obotx/diy-robot-kit/README.md

# ObotX

ObotX is an open-source mobile manipulator with a mecanum base, two vertical
Z axes, a horizontal X axis and a four-finger electric gripper.

This repository contains the bill of materials, electrical diagram, firmware
and Raspberry Pi control software required to reproduce and commission the
robot.

<p align="center">
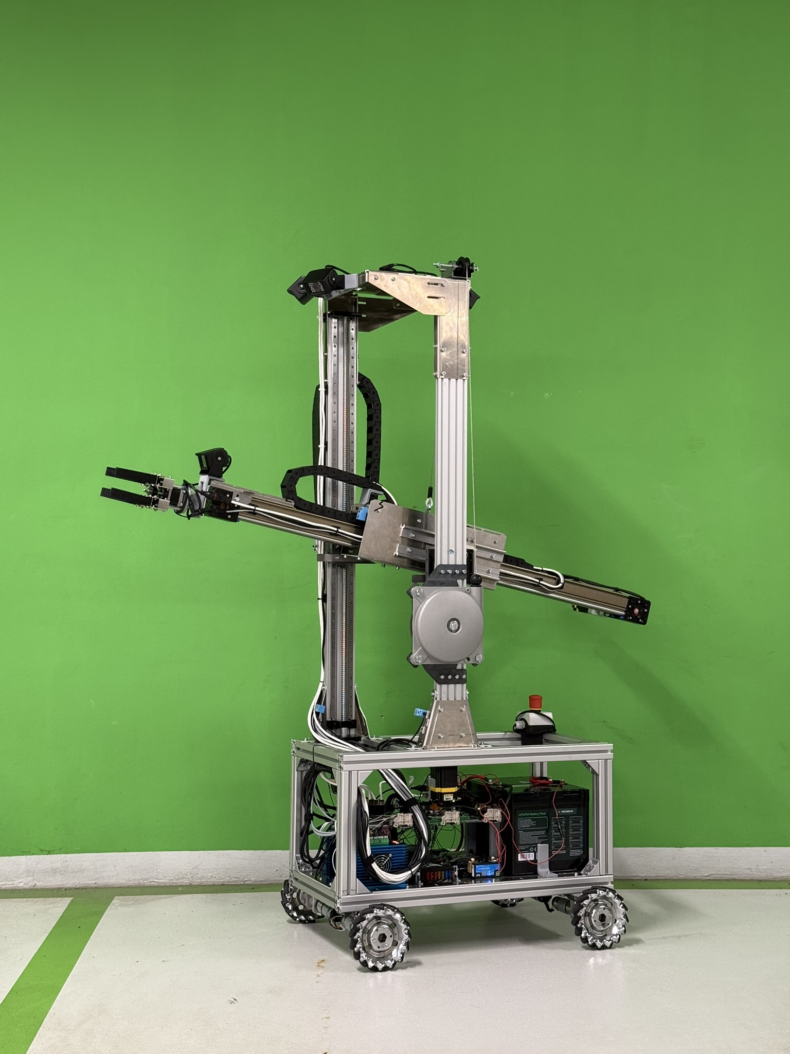
[picture p1: media/obotx-robot.jpg]
ObotX mobile manipulator
  
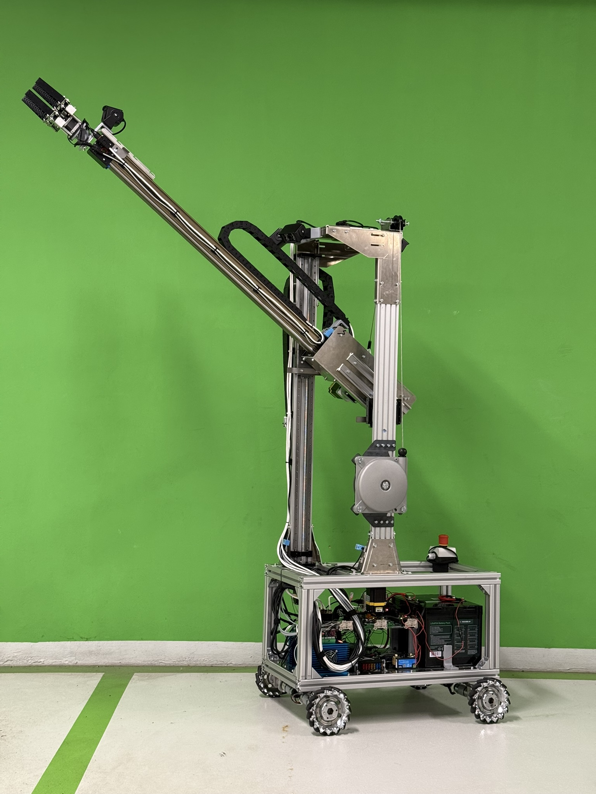
[picture p2: media/obotx-robot-extended.jpg]
ObotX manipulator extended
  
</p>

### Demonstration video

The following video shows the assembled ObotX robot in operation.

https://github.com/user-attachments/assets/15b41a1a-71f6-4121-ad5b-7e64adb0d48f

## Teleoperation system

The complete ObotX teleoperation system consists of two parts:

| Component | Role |
| --- | --- |
| **Device** | The physical ObotX robot, including the mecanum base, manipulator, gripper, cameras, Raspberry Pi and STM32 controllers. |
| **Teleoperation interface** | The browser-based operator panel served by the Raspberry Pi. It sends commands to the Device and displays robot status and camera video. |

```text
Operator -> Browser interface -> Wi-Fi / Ethernet -> ObotX Device
```

The Raspberry Pi web server and teleoperation interface are included in this
repository under [`software/rpi`](software/rpi/).

### Teleoperation interface

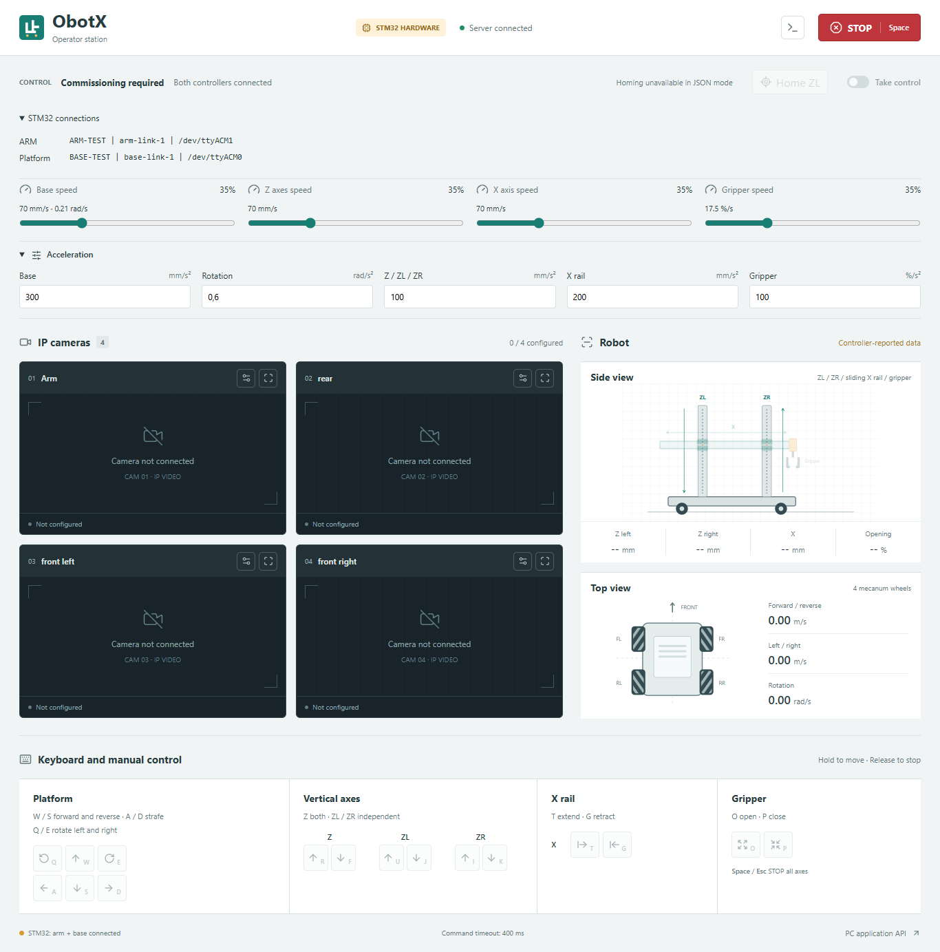
[picture p3: media/obotx-teleoperation-interface.png]
ObotX browser-based teleoperation interface


## Build and commissioning order

1. Purchase the parts from the [main BOM](hardware/bom/bom.csv) and
   [mechanical BOM](hardware/bom/mechanical-bom.csv).
2. Build the robot using the [mechanical assembly drawings](docs/assembly/README.md).
3. Wire the robot according to the
   [electrical diagram](hardware/wiring/ObotX_electrical_diagram.pdf).
4. Configure and commission the
   [battery system](docs/power/victron-battery-commissioning.md).
5. Configure the [closed-loop stepper drivers](software/stm32_arm/docs/zdm-2ha865-parameters.md).
6. Flash the [ARM](software/stm32_arm/README.md) and
   [BASE](software/stm32_base/README.md) controllers.
7. Install the [Raspberry Pi software](software/rpi/INSTALL.md) and configure
   the [network connection](software/rpi/docs/network-connection.md).
8. Complete the [commissioning checklist](docs/testing/commissioning-checklist.md)
   before placing the robot on the floor or attaching a payload.

## Documentation

Use the [documentation index](docs/README.md) to find the instructions for each
subsystem.

## Safety

Keep the physical emergency stop accessible. Support axes that can fall when
motor power is removed. Begin motor tests unloaded and with the drive wheels
raised. Never use the browser, Wi-Fi, Ethernet, camera video, BatteryProtect or
software STOP as the only emergency-stop function.

Do not commit passwords, Bluetooth encryption keys, private configuration,
invoices, contracts or personal/customer data.
