obotx/diy-robot-kit/hardware/drawings/README.md

# Mechanical drawings

Assembly drawings in [`assemblies/`](assemblies/) contain bills of materials,
exploded views and mounting instructions. Part drawings in [`parts/`](parts/)
define manufacturing dimensions, material, thickness and bending data.

## Assembly order

| Drawing | Assembly |
| --- | --- |
| [OBX-A001](assemblies/OBX-A001_REV.pdf) | Base frame |
| [OBX-A005](assemblies/OBX-A005_REV.pdf) | One wheel and motor assembly; build four |
| [OBX-A006](assemblies/OBX-A006_REV.pdf) | Electrical mounting plate assembly |
| [OBX-A012](assemblies/OBX-A012_REV.pdf) | Complete mobile base |
| [OBX-A011](assemblies/OBX-A011_REV.pdf) | Cable carrier assembly |
| [OBX-A009](assemblies/OBX-A009_REV.pdf) | Vertical lifting module |
| [OBX-A003](assemblies/OBX-A003_REV.pdf) | Fixed node module |
| [OBX-A004](assemblies/OBX-A004_REV.pdf) | Moving node |
| [OBX-A010](assemblies/OBX-A010_REV.pdf) | Horizontal actuator module |
| [OBX-A007](assemblies/OBX-A007_REV.pdf) | Balancer module |
| [OBX-A008](assemblies/OBX-A008_REV.pdf) | Cable pulley block |
| [OBX-A000](assemblies/OBX-A000_REV.pdf) | Final robot integration |

Read every sheet of a drawing before assembly. The item numbers in an exploded
view refer to the bill of materials on the first sheet of that drawing.

Use the part PDFs when ordering laser-cut, bent or machined parts. Send the
matching STEP file together with the PDF, but treat the PDF dimensions,
material and tolerances as authoritative.
