obotx/diy-robot-kit/hardware/bom/bom.csv

Category | Subsystem | Item | Qty | Estimated Cost PLN | Supplier/Link | Notes
Control | Raspberry Pi Gateway | Raspberry Pi 4B 4GB | 1 | 470 | https://www.morele.net/raspberry-pi-4-model-b-cpu-1-5ghz-ram-4gb-5939927/ | Robot-side gateway
Control | Raspberry Pi Gateway | SanDisk Ultra microSD 64GB 140MB/s UHS-I Class 10 A1 with adapter | 1 | 90 | https://botland.com.pl/karty-pamieci-microsd-sd/9960-karta-pamieci-sandisk-ultra-microsd-64gb-140mbs-uhs-i-klasa-10-a1-z-adapterem-619659200541.html | Raspberry Pi system storage
Control | Base Controller | STM32 Nucleo-F446RE | 1 | 89 | https://botland.com.pl/stm32-nucleo/4905-stm32-nucleo-f446re-stm32f446re-arm-cortex-m4-5904422333164.html | Base controller
Control | Arm Controller | STM32 Nucleo-F446RE | 1 | 89 | https://botland.com.pl/stm32-nucleo/4905-stm32-nucleo-f446re-stm32f446re-arm-cortex-m4-5904422333164.html | Arm controller
Control | USB | Angled USB-A to Mini-USB cable, 1 m, black | 2 | 34 | https://allegro.pl/oferta/kabel-usb-mini-usb-do-nawigacji-kamery-aparatu-wideorejestratora-1m-katowy-15325171795 | Connects Raspberry Pi to STM32 Nucleo boards
Control | Signal Interface | PC817 8-channel optoisolator module | 1 | 12 | https://allegro.pl/oferta/modul-optoizolatora-8-kanalowego-pc817-18445333761 | 8-channel optoisolated input module
Control | Signal Interface | PC817 4-channel optoisolator module | 1 | 9 | https://allegro.pl/oferta/modul-optoizolatora-4-kanalowego-pc817-18445323186 | 4-channel optoisolated input module
Control | Signal Interface | ULN driver module | 2 | 32 | https://www.amazon.pl/dp/B0CH8ZD1FL | Output driver modules for X and Z control sections
Base | Drive | Mecanum wheel and motor platform set | 1 | 3500 | https://pl.aliexpress.com/item/4001034973724.html | Complete base wheel and motor set
Base | Drive | Cytron MDD10A Rev 2.0 dual-channel DC motor driver | 2 | 218 | https://botland.com.pl/sterowniki-silnikow-dc/15818-cytron-mdd10a-dwukanalowy-sterownik-silnikow-dc-30v10a-5904422350444.html | Two boards control four base motors
Arm | Z Axis | 4 Nm 5.8 A closed-loop stepper motor with brake and ZDM-2HA865 driver | 2 | 1378 | https://sklep.akcesoria-cnc.pl/silnik-serwo-krokowy-4nm-5-8a-serwokontroler-zdm-2ha865-z-hamulcem-p-505.html | One motor and driver set per Z axis
Arm | X Axis | 2.5 Nm 4 A NEMA 23 57EBP105ALC-TF0 closed-loop stepper motor with ZDM-2HA865 driver | 1 | 455 | https://sklep.akcesoria-cnc.pl/silnik-serwo-krokowy-2-5nm-4a-serwokontroler-zdm-2ha865-cnc-p-10.html | X-axis motor and driver set
Sensors | Arm | Inductive limit sensor | 4 | 48 | https://pl.aliexpress.com/item/1005007377313993.html | One sensor for each axis and one level-detection sensor
Gripper | End Effector | Electric four-finger gripper | 1 | 350 | https://pl.aliexpress.com/item/1005009794922378.html | Electric four-finger variant
Gripper | Motor Driver | Pololu 2973 TB67S249FTG stepper motor driver carrier | 1 | 54 | https://botland.com.pl/sterowniki-silnikow-krokowych/12228-tb67s249ftg-sterownik-silnika-krokowego-47v45a-pololu-2973-5904422318918.html | Gripper stepper motor driver
Power | Battery | Green Cell CUBE LiFePO4 12.8 V 50 Ah 640 Wh battery with BMS | 2 | 1240 | https://allegro.pl/produkt/green-cell-cube-akumulator-lifepo4-50ah-12v-12-8v-640wh-lfpgc12v50ah-28bf92dd-3377-480e-abae-5b22cc76a739?offerId=17348570470 | Two batteries connected in series after individual charging and balancing
Power | Charging | FOXSUR FPT-250 12 V / 24 V 25 A charger | 1 | 235 | https://www.foxsur.com/products/119.html | LiFePO4-compatible charger
Power | Protection | Victron Energy BatteryProtect BP-65 12/24 V 65 A | 1 | 144 | https://allegro.pl/produkt/zabezpieczenie-akumulatora-victron-energy-batteryprotect-12-24v-65a-f34779a4-f8ed-4237-9bd2-b917573e413c?offerId=18337320716 | Low-voltage load disconnect
Power | Monitoring | Victron Energy SmartShunt 300 A / 50 mV | 1 | 279 | https://allegro.pl/oferta/victron-smart-shunt-monitoring-akumulatorowy-akumulatora-300a-50mv-17166550056 | Battery monitor with Bluetooth
Power | Protection | VEOZ 06112 battery disconnect switch, 200 A, 12/24 V | 1 | 30 | https://allegro.pl/oferta/wylacznik-pradu-hebel-w-obudowie-200a-12-24v-kamer-van-przyczepa-kempingowa-16363077673 | Main service disconnect
Power | Protection | Mini-ANL / MIDI fuse holder, 200 A | 1 | 25 | https://allegro.pl/produkt/gniazdo-bezpiecznika-mini-anl-midval-200a-minianl-9d2406f0-88eb-432b-bf5a-58fbd06d9141?offerId=13480475607 | Holder for the main battery fuse
Power | Protection | Mini-ANL / MIDI fuse, 60 A, 32 V | 1 | 8 | https://allegro.pl/produkt/bezpiecznik-samochodowy-nozycowy-mini-anl-60a-32v-adc839b3-0ead-4bf9-b0bf-be926bc51fba?offerId=13427921262 | Main battery fuse
Power | Protection | UNI GB8A 8-way fuse holder | 1 | 30 | https://allegro.pl/oferta/skrzynka-gniazdo-obudowa-bezpiecznikow-uni-gb8a-11463680225 | Branch fuse holder; install fuse ratings shown in the electrical diagram
Power | Distribution | Positive DC busbar, 14-way, 150 A, 48 V DC | 1 | 50 | https://allegro.pl/produkt/listwa-zaciskowa-14-wyjsc-150a-rozdzielacz-pradu-48v-dc-fa34389f-f51d-4b50-9f6e-cc494f19f347?offerId=19054339890 | Positive power distribution
Power | Distribution | Negative DC busbar, 14-way, 150 A, 48 V DC | 1 | 50 | https://allegro.pl/produkt/listwa-zaciskowa-14-wyjsc-150a-rozdzielacz-pradu-48v-dc-fa34389f-f51d-4b50-9f6e-cc494f19f347?offerId=19054339890 | Ground / negative power distribution
Power | DC/DC | Mean Well DDR-60G-12 DIN-rail DC/DC converter, 12 V 5 A | 1 | 220 | https://www.tme.eu/pl/details/ddr-60g-12/przetwornice-dc-dc/mean-well/ | 12 V accessory and camera rail
Power | DC/DC | Mean Well DDR-30G-5 DIN-rail DC/DC converter, 5 V 5 A | 1 | 180 | https://www.tme.eu/pl/details/ddr-30g-5/przetwornice-dc-dc/mean-well/ | Dedicated Raspberry Pi 5 V rail
Vision | Cameras | Wired camera, 3.6 mm lens, non-PoE | 4 | 480 | https://pl.aliexpress.com/item/1005008786075053.html | Four wired cameras
Network | Ethernet | Teltonika TSF010 unmanaged 5-port 10/100 Ethernet switch | 1 | 154 | https://allegro.pl/oferta/teltonika-tsf010-plaski-switch-przemyslowy-5x-eth-na-szyne-din-18436236300 | DIN-rail switch for cameras and Raspberry Pi
Wiring | Mounting | DRG-01 DIN-rail module holder | 10 | 25 | https://www.gotronik.pl/drg-01-uchwyt-mocujacy-na-szyne-din-35mm-p-6660.html | Recommended quantity for mounting modules on 35 mm DIN rail
Wiring | Mounting | DRG-03 DIN-rail module holder | 6 | 48 | https://www.gotronik.pl/drg-03-uchwyt-mocujacy-na-szyne-din-35mm-p-6663.html | Recommended quantity for mounting modules on 35 mm DIN rail
