obotx/diy-robot-kit/hardware/bom/mechanical-bom.csv

Group | Part number / standard | Description | Qty | Source
Custom part | OBX-P001 | 40 x 40 profile, L=306 mm | 5 | OBX-A001
Custom part | OBX-P002 | 40 x 40 profile, L=750 mm | 4 | OBX-A001
Custom part | OBX-P013 | 40 x 40 profile, L=296 mm | 1 | OBX-A001
Custom part | OBX-P014 | 40 x 40 profile, L=132 mm | 2 | OBX-A001
Custom part | OBX-P021 | 40 x 40 profile, L=400 mm | 4 | OBX-A001
Custom part | OBX-P004 | Z carriage mount | 1 | OBX-A009
Custom part | OBX-P004M | Mirrored Z carriage mount | 1 | OBX-A009
Custom part | OBX-P005 | X-axis mount | 1 | OBX-A003
Custom part | OBX-P006 | IGUS mount | 1 | OBX-A004
Custom part | OBX-P007 | Z-axis mount | 2 | OBX-A009
Custom part | OBX-P008 | Upper mount | 2 | OBX-A009
Custom part | OBX-P009 | X-axis mount cover | 1 | OBX-A003
Custom part | OBX-P010 | Gripper mount | 1 | OBX-A010
Custom part | OBX-P015 | Limit-switch indicator 2 | 2 | OBX-A009
Custom part | OBX-P016 | Limit-switch indicator 3 | 1 | OBX-A004
Custom part | OBX-P017 | Limit-switch mount | 1 | OBX-A003
Custom part | OBX-P018 | Limit-switch indicator 4 | 1 | OBX-A010
Custom part | OBX-P019 | Limit-switch indicator 1 | 2 | OBX-A009
3D printed | OBX-P022 | Bearing housing 1; 100% infill, 0.3 mm, ABS/ASA | 2 | OBX-A003 and OBX-A004
3D printed | OBX-P023 | Bearing housing 2; 100% infill, 0.3 mm, ABS/ASA | 2 | OBX-A003 and OBX-A004
Custom part | OBX-P025 | Wheel mount | 4 | 4 x OBX-A005
Custom part | OBX-P028 | Balancer mount | 1 | OBX-A007
Custom part | OBX-P029 | Pulley-block mount | 1 | OBX-A008
3D printed | OBX-P030 | Pulley spacer; 100% infill, 0.3 mm, ABS/ASA | 4 | OBX-A008
Custom part | OBX-P031 | Cable-carrier mount | 1 | OBX-A003
Custom part | OBX-P032 | Gripper camera mount | 1 | OBX-A010
Custom part | OBX-P033 | Fixed cable-carrier mount | 1 | OBX-A011
Custom part | OBX-P034 | Electrical mounting plate | 1 | OBX-A006
Custom part | OBX-P035 | Carriage cable-carrier mount | 1 | OBX-A011
Custom part | OBX-P036 | Camera mount | 1 | OBX-A009
Custom part | OBX-P038 | Gearbox spacer | 3 | OBX-A010
Purchased mechanical | FI3K4040M | 40 x 40 angle connector kit | 22 | OBX-A001
Purchased mechanical | WS_10_300_1 | Linear rail | 2 | OBX-A003
Purchased mechanical | IGUS WJ200UM_01_10 | Linear carriage | 2 | OBX-A004
Purchased mechanical | IGGUS WJ200UM_01_10_LL | Linear carriage LL | 2 | OBX-A004
Purchased mechanical | TULEJA B-12-15-12-18-1,5 | Flanged bushing | 2 | OBX-A003 and OBX-A004
Purchased mechanical | Shoulder screw ISO 7379-12-M10-25 | Shoulder screw | 2 | OBX-A003 and OBX-A004
Purchased mechanical | KGX80-1000 | Vertical linear module | 2 | OBX-A009
Purchased mechanical | DS60-1000 | Horizontal linear module | 1 | OBX-A010
Purchased mechanical | HPS60-05SW | Gearbox, ratio 5:1 | 1 | OBX-A010
Purchased mechanical | JM30C | Jaw coupling, 14 mm / 14 mm | 1 | OBX-A010
Purchased mechanical | OBX-P037 | CNC cable carrier, 18 x 37 mm | 2 | OBX-A010 and OBX-A011
Purchased mechanical | BALANSER | Balancer | 1 | OBX-A007
Purchased mechanical | Szpula Diall 8 x 50 mm | Pulley wheel | 2 | OBX-A008
Purchased mechanical | Shoulder screw ISO 7379-8-M6-55 | Shoulder screw | 2 | OBX-A008
Main BOM reference | OMNI WHEEL + MOTOR | Wheel and motor assembly | 4 | Main BOM; 4 x OBX-A005
Main BOM reference | NEMA 23 57EBP105ALC-TF0 | X-axis stepper motor | 1 | Main BOM; OBX-A010
Fastener | DIN 912 M3 x 20 | Socket-head screw | 14 | OBX-A003 and OBX-A009
Fastener | ISO 4032 M3 | Hex nut | 14 | OBX-A003 and OBX-A009
Fastener | DIN 912 M4 x 16 | Socket-head screw | 16 | 4 x OBX-A005
Fastener | ISO 4032 M4 | Hex nut | 16 | 4 x OBX-A005
Fastener | DIN 912 M5 x 10 | Socket-head screw | 8 | OBX-A007
Fastener | DIN 912 M5 x 12 | Socket-head screw | 69 | OBX-A005, OBX-A009, OBX-A010 and OBX-A011
Fastener | DIN 912 M5 x 16 | Socket-head screw | 56 | OBX-A003, OBX-A006, OBX-A008, OBX-A009 and OBX-A010
Fastener | DIN 912 M5 x 20 | Socket-head screw | 8 | OBX-A003 and OBX-A004
Fastener | DIN 912 M5 x 35 | Socket-head screw | 4 | OBX-A010
Fastener | ISO 4032 M5 | Hex nut | 54 | OBX-A003, OBX-A008, OBX-A009, OBX-A010 and OBX-A011
Fastener | DIN EN ISO 7040 M5 | Self-locking nut | 4 | OBX-A004
Fastener | DIN 557 M5 | Square nut | 39 | OBX-A007, OBX-A009, OBX-A010 and OBX-A011
Fastener | M5 profile T-nut with spring ball | Profile T-nut | 38 | OBX-A005, OBX-A006 and OBX-A009
Fastener | ISO 7089-5 | Washer | 4 | OBX-A008
Fastener | DIN 912 M6 x 16 | Socket-head screw | 22 | OBX-A003, OBX-A004 and OBX-A010
Fastener | ISO 4032 M6 | Hex nut | 2 | OBX-A008
Fastener | DIN 557 M8 | Square nut | 2 | OBX-A010
Fastener | DIN 912 M8 x 12 | Socket-head screw | 2 | OBX-A010
Fastener | DIN 912 M10 x 35 | Socket-head screw | 3 | OBX-A007
Fastener | ISO 4032 M10 | Hex nut | 3 | OBX-A007
Fastener | DIN EN ISO 7040 M10 | Self-locking nut | 2 | OBX-A003 and OBX-A004
