obotx/diy-robot-kit/hardware/cad/solidworks/DS60 - 1000.SLDASM

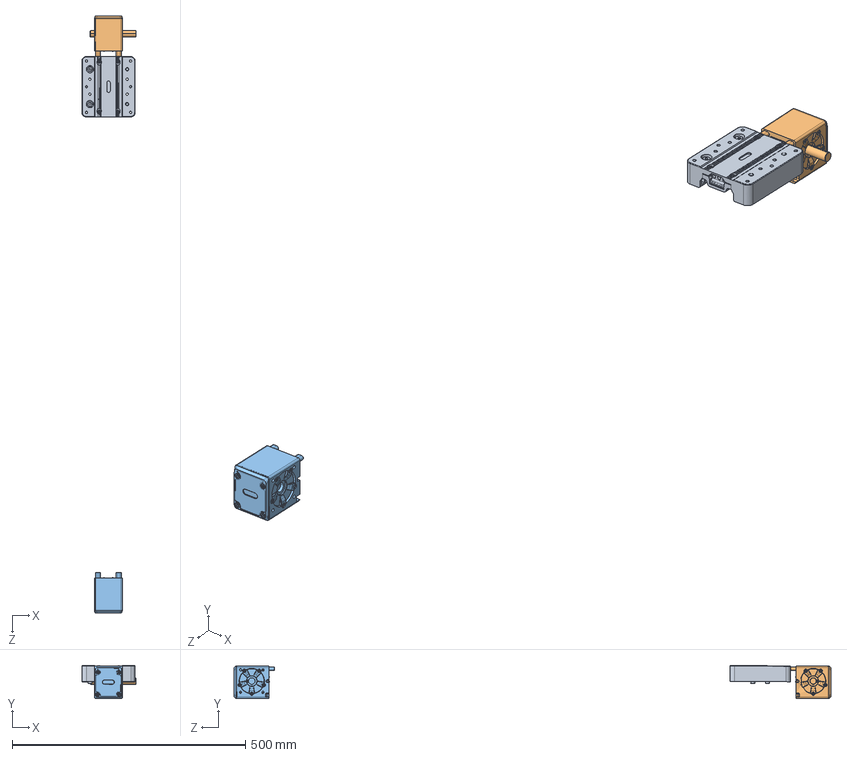
[picture p4: CAD file, 2026-11-09]
hardware/cad/solidworks/DS60 - 1000.SLDASM
116.4 x 70.8 x 1280.0 mm
60C____
