obotx/diy-robot-kit/hardware/cad/solidworks/OBX-P028.SLDPRT

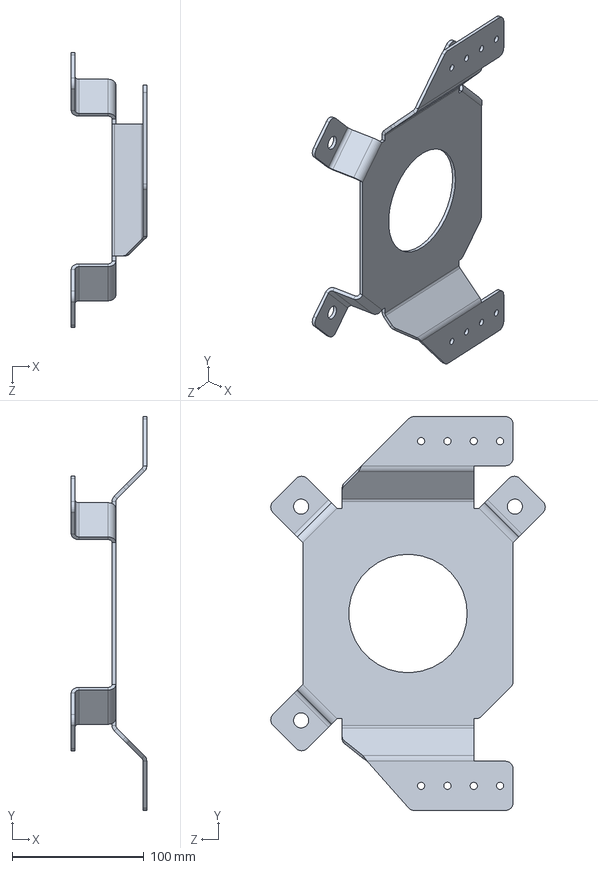
[picture p5: CAD file, 2026-11-09]
hardware/cad/solidworks/OBX-P028.SLDPRT
57.5 x 299.5 x 208.8 mm
