obotx/diy-robot-kit/hardware/cad/step/assemblies/OBX-A007__mm_szt_REV.STEP

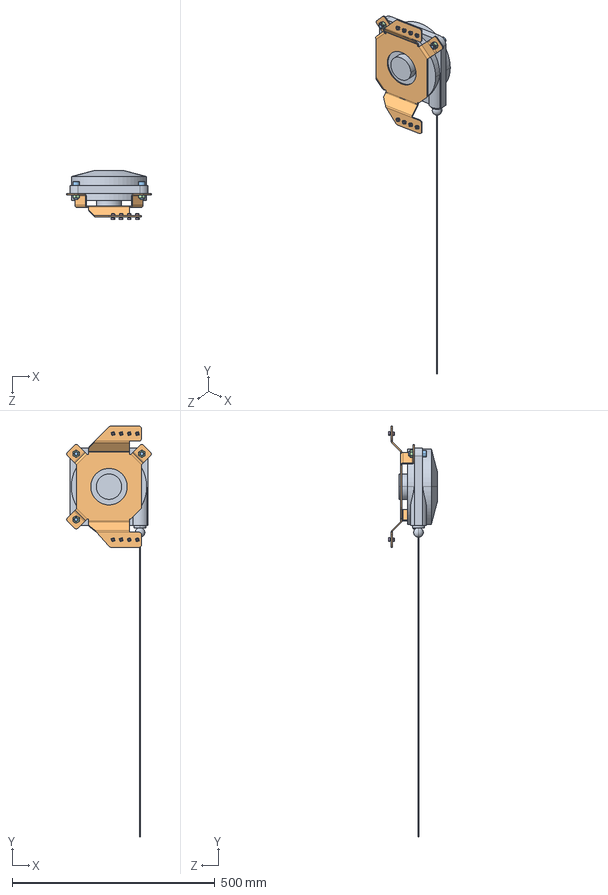
[picture p6: CAD file, 2026-11-09]
hardware/cad/step/assemblies/OBX-A007__mm_szt_REV.STEP
208.8 x 1014.6 x 122.0 mm
BALANSER
OBX-P028
DIN 912 M10 x 35 --- 35N_DIN 912 M10 x 35 --- 35N x 3
ISO - 4032 - M10 - W - N_ISO - 4032 - M10 - W - N x 3
DIN 912 M5 x 10 --- 10N_DIN 912 M5 x 10 --- 10N x 8
Square nut DIN 557 M5 -N_Square nut DIN 557 M5 -N x 8
