obotx/diy-robot-kit/hardware/cad/step/parts/OBX-P022_ABS_1.5mm_szt_REV.STEP

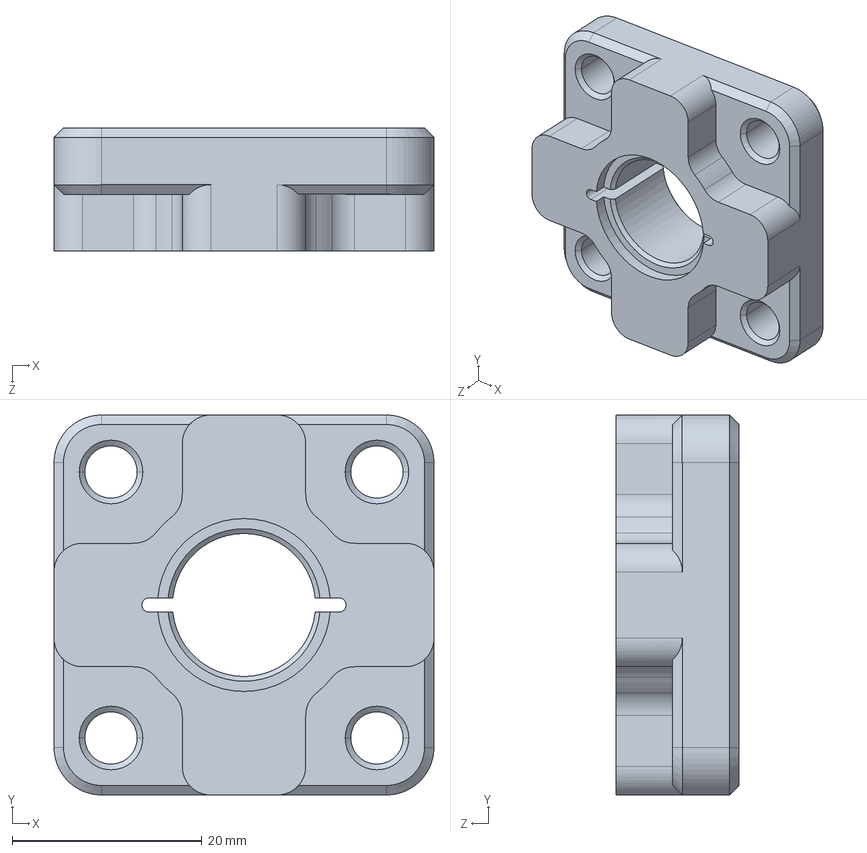
[picture p7: CAD file, 2026-11-09]
hardware/cad/step/parts/OBX-P022_ABS_1.5mm_szt_REV.STEP
40.0 x 40.0 x 13.0 mm
