obotx/diy-robot-kit/hardware/cad/solidworks/OBX-P037.SLDPRT

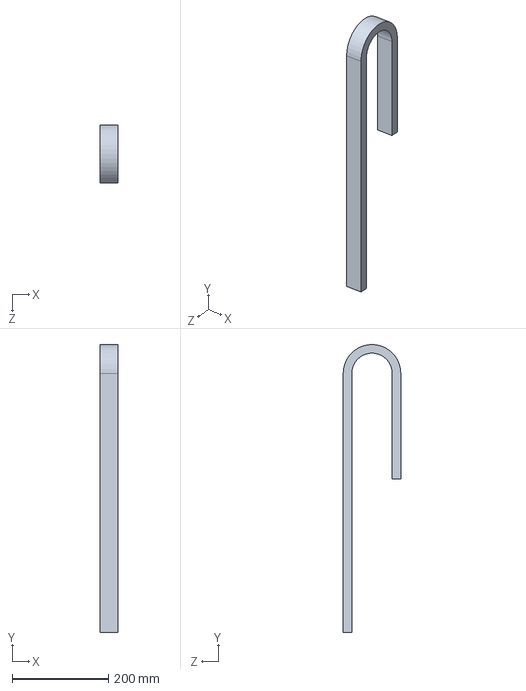
[picture p8: CAD file, 2026-11-09]
hardware/cad/solidworks/OBX-P037.SLDPRT
37.0 x 600.0 x 120.0 mm
