obotx/diy-robot-kit/hardware/cad/step/parts/OBX-P015_Stal węglowa_1.5mm_szt_REV.STEP

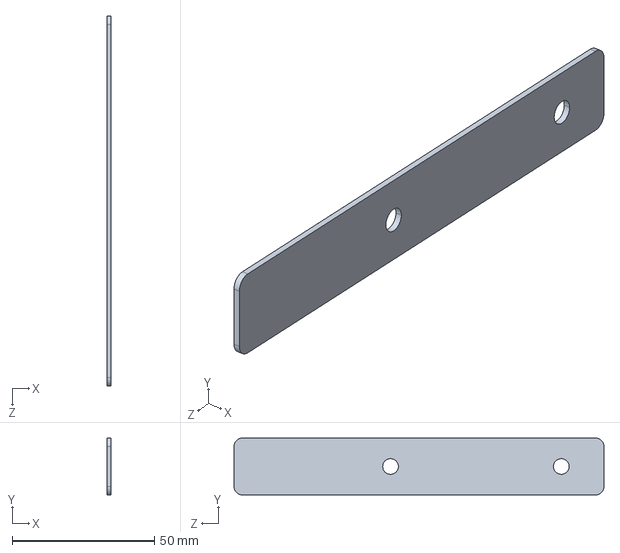
[picture p10: CAD file, 2026-11-09]
hardware/cad/step/parts/OBX-P015_Stal węglowa_1.5mm_szt_REV.STEP
1.50 x 20.0 x 130.0 mm
