obotx/diy-robot-kit/hardware/cad/step/parts/OBX-P030.STEP

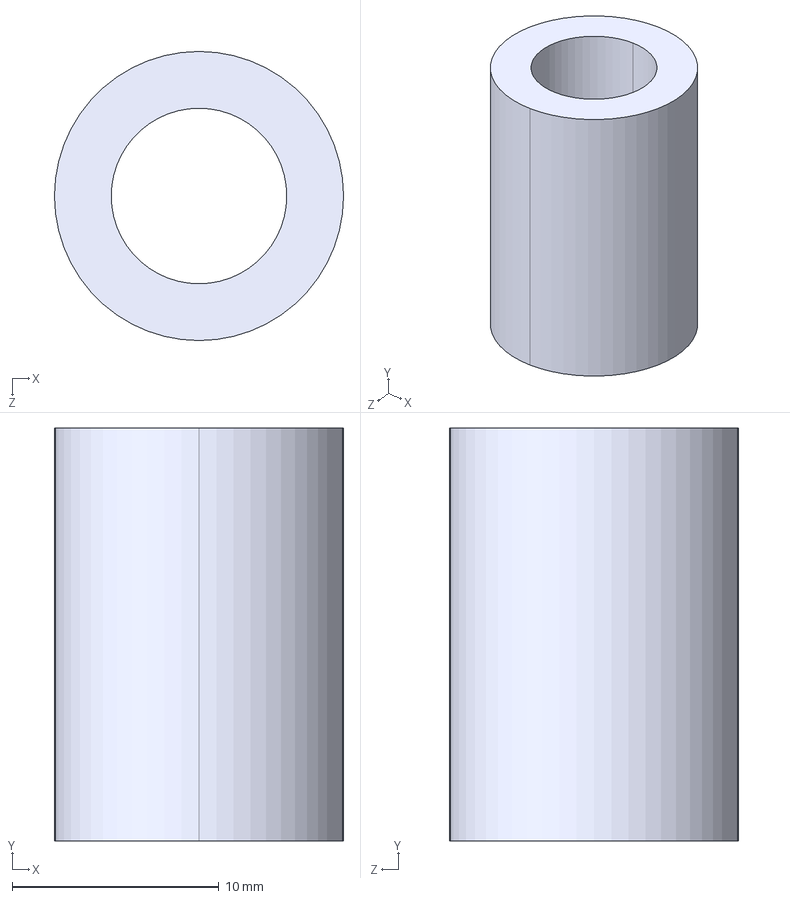
[picture p12: CAD file, 2026-11-09]
hardware/cad/step/parts/OBX-P030.STEP
14.0 x 20.0 x 14.0 mm
