obotx/diy-robot-kit/hardware/cad/solidworks/OBX-P013.SLDPRT

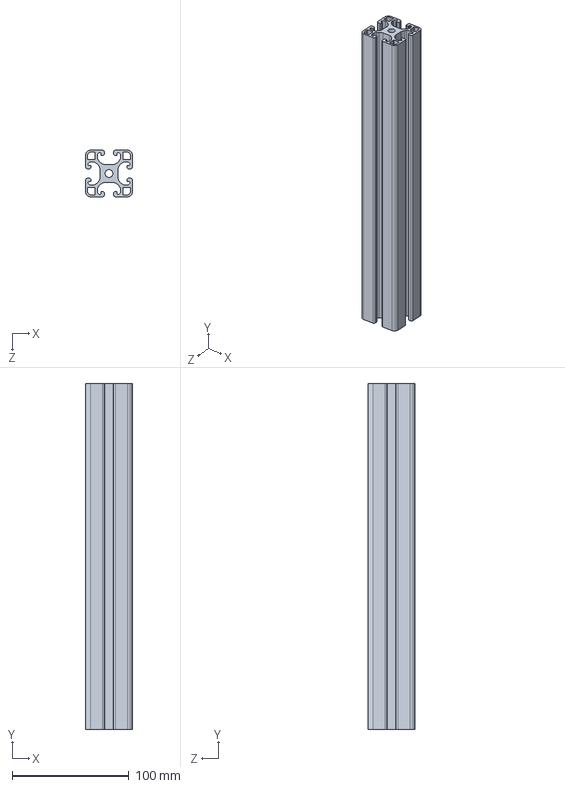
[picture p13: CAD file, 2026-11-09]
hardware/cad/solidworks/OBX-P013.SLDPRT
40.0 x 296.0 x 40.0 mm
