obotx/diy-robot-kit/hardware/cad/step/assemblies/OBX-A008__mm_szt_REV.STEP

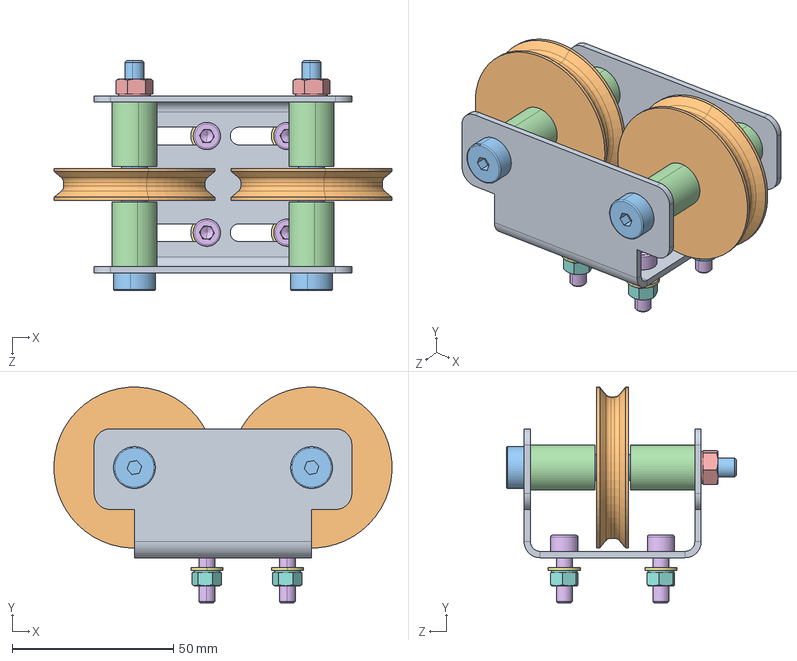
[picture p14: CAD file, 2026-11-09]
hardware/cad/step/assemblies/OBX-A008__mm_szt_REV.STEP
104.9 x 67.0 x 71.5 mm
OBX-P029
Szpula Diall 8 x 50 mm x 2
ŚRUBA PASOWANA ISO 7379-8-M6-55 x 2
OBX-P030 x 4
ISO - 4032 - M6 - W - N_ISO - 4032 - M6 - W - N x 2
DIN 912 M5 x 16 --- 16N_DIN 912 M5 x 16 --- 16N x 4
Washer ISO 7089 - 5_Washer ISO 7089 - 5 x 4
ISO - 4032 - M5 - W - N_ISO - 4032 - M5 - W - N x 4
