obotx/diy-robot-kit/hardware/cad/step/parts/OBX-P004M_Stal węglowa_2mm_szt_REV.STEP

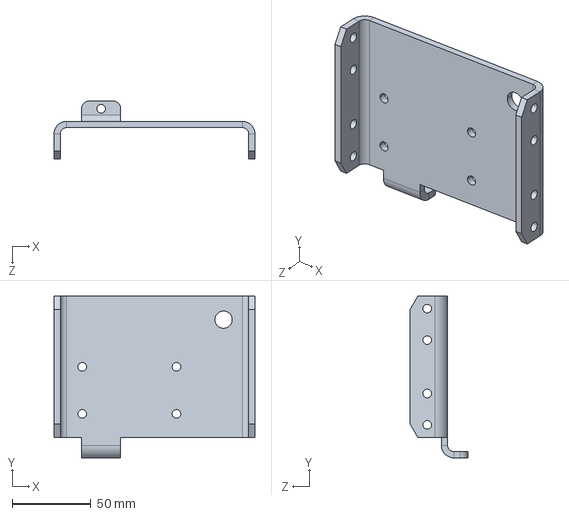
[picture p15: CAD file, 2026-11-09]
hardware/cad/step/parts/OBX-P004M_Stal węglowa_2mm_szt_REV.STEP
128.0 x 103.0 x 37.0 mm
