obotx/diy-robot-kit/hardware/cad/solidworks/OBX-P034.SLDPRT

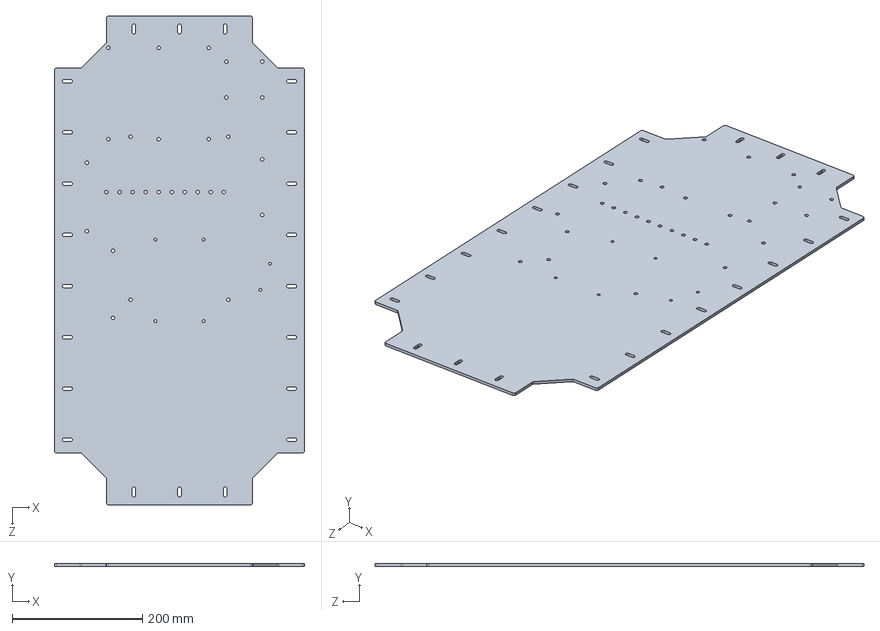
[picture p16: CAD file, 2026-11-09]
hardware/cad/solidworks/OBX-P034.SLDPRT
384.0 x 4.00 x 750.0 mm
