obotx/diy-robot-kit/hardware/cad/step/assemblies/OBX-A001__mm_szt_REV.STEP

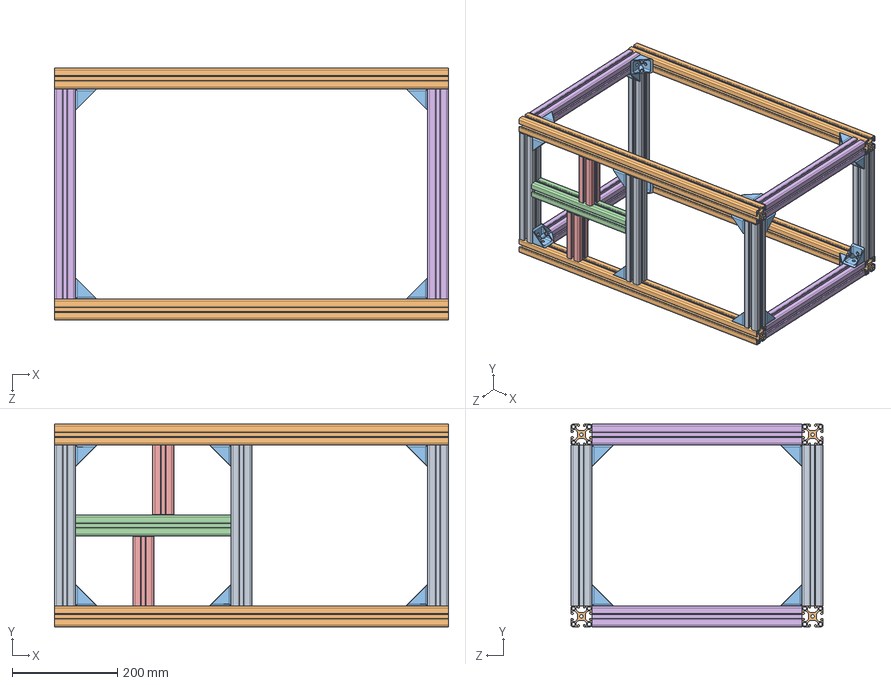
[picture p17: CAD file, 2026-11-09]
hardware/cad/step/assemblies/OBX-A001__mm_szt_REV.STEP
750.0 x 386.0 x 480.0 mm
OBX-P001 x 5
OBX-P002 x 4
FI3K4040M x 22
OBX-P013
OBX-P014 x 2
OBX-P021 x 4
