obotx/diy-robot-kit/hardware/cad/step/parts/OBX-P025_Stal węglowa_4mm_szt_REV.STEP

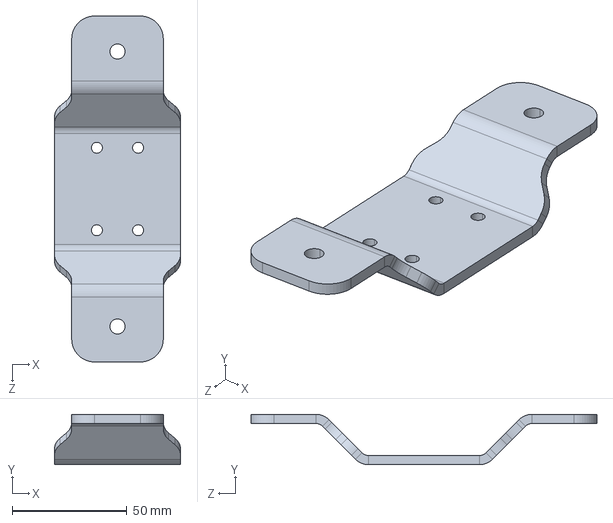
[picture p18: CAD file, 2026-11-09]
hardware/cad/step/parts/OBX-P025_Stal węglowa_4mm_szt_REV.STEP
55.0 x 22.0 x 151.0 mm
