obotx/diy-robot-kit/hardware/cad/step/assemblies/OBX-A005__mm_szt_REV.STEP

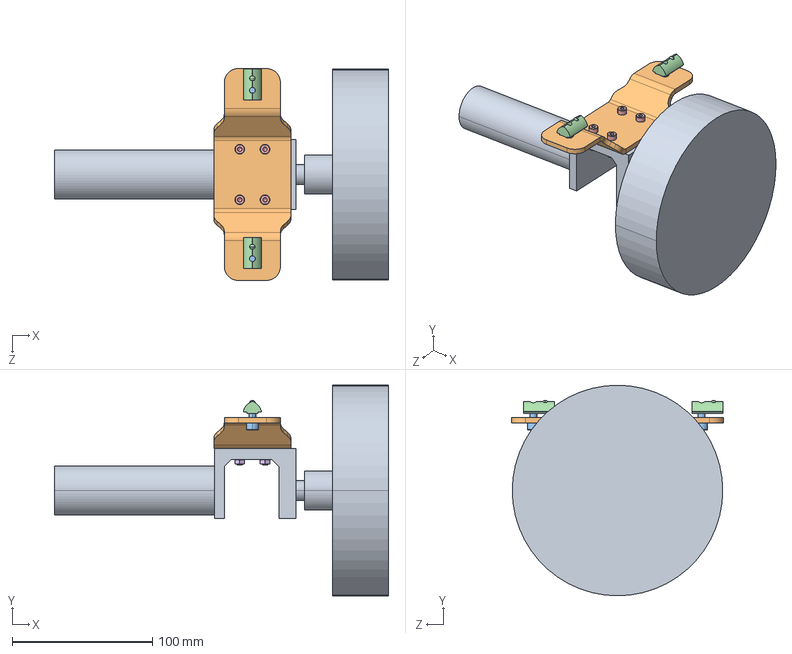
[picture p19: CAD file, 2026-11-09]
hardware/cad/step/assemblies/OBX-A005__mm_szt_REV.STEP
238.0 x 150.0 x 151.0 mm
OMNI WHEEL + MOTOR
OBX-P025
DIN 912 M5 x 12 --- 12N_DIN 912 M5 x 12 --- 12N x 2
Nakrętka wpustowa z kulką 8 M5 ITEM x 2
DIN 912 M4 x 16 --- 16N_DIN 912 M4 x 16 --- 16N x 4
ISO - 4032 - M4 - W - N_ISO - 4032 - M4 - W - N x 4
