obotx/diy-robot-kit/hardware/cad/step/parts/OBX-P016_Stal węglowa_1.5mm_szt_REV.STEP

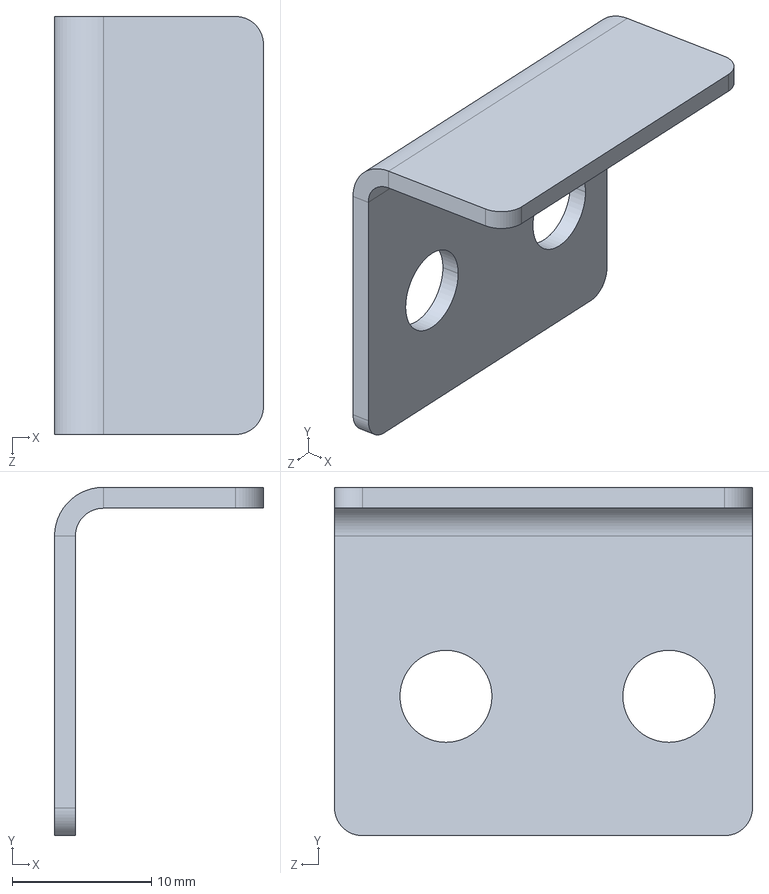
[picture p20: CAD file, 2026-11-09]
hardware/cad/step/parts/OBX-P016_Stal węglowa_1.5mm_szt_REV.STEP
15.0 x 25.0 x 30.0 mm
