obotx/diy-robot-kit/hardware/cad/solidworks/OBX-P033.SLDPRT

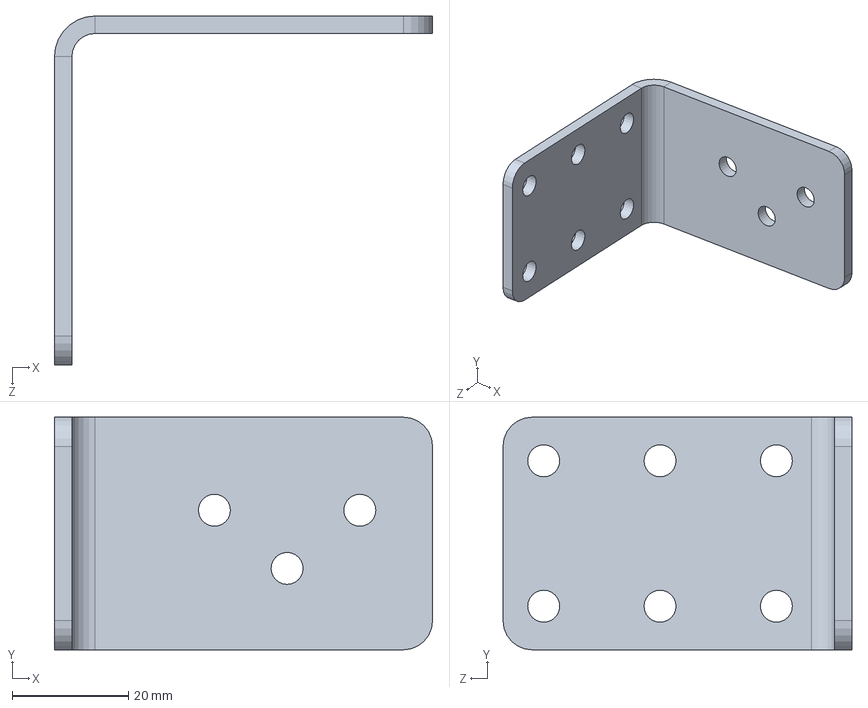
[picture p21: CAD file, 2026-11-09]
hardware/cad/solidworks/OBX-P033.SLDPRT
65.0 x 40.0 x 60.0 mm
