obotx/diy-robot-kit/hardware/cad/step/assemblies/OBX-A011__mm_szt_REV.STEP

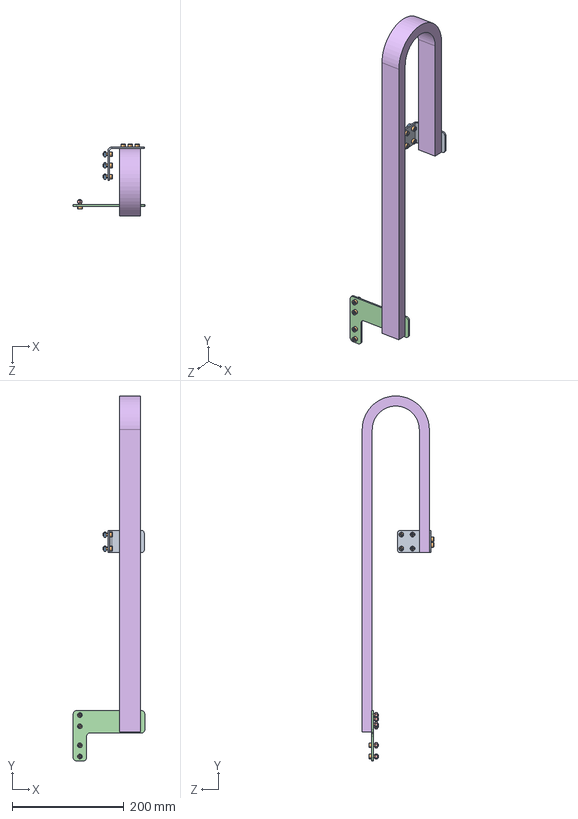
[picture p22: CAD file, 2026-11-09]
hardware/cad/step/assemblies/OBX-A011__mm_szt_REV.STEP
128.0 x 652.0 x 128.0 mm
OBX-P033
DIN 912 M5 x 12 --- 12N_DIN 912 M5 x 12 --- 12N x 16
Square nut DIN 557 M5 -N_Square nut DIN 557 M5 -N x 6
OBX-P035
ISO - 4032 - M5 - W - N_ISO - 4032 - M5 - W - N x 10
OBX-P037
