obotx/diy-robot-kit/hardware/cad/step/parts/OBX-P036_6063-T1_3mm_szt_REV.STEP

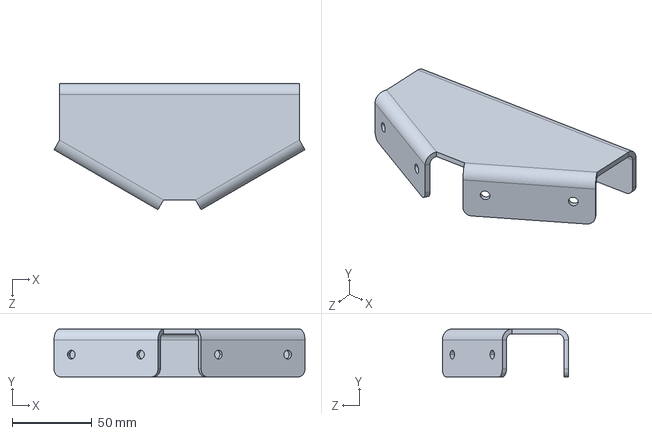
[picture p23: CAD file, 2026-11-09]
hardware/cad/step/parts/OBX-P036_6063-T1_3mm_szt_REV.STEP
157.0 x 30.0 x 79.1 mm
