obotx/diy-robot-kit/hardware/cad/step/parts/OBX-P018_Stal węglowa_1.5mm_szt_REV.STEP

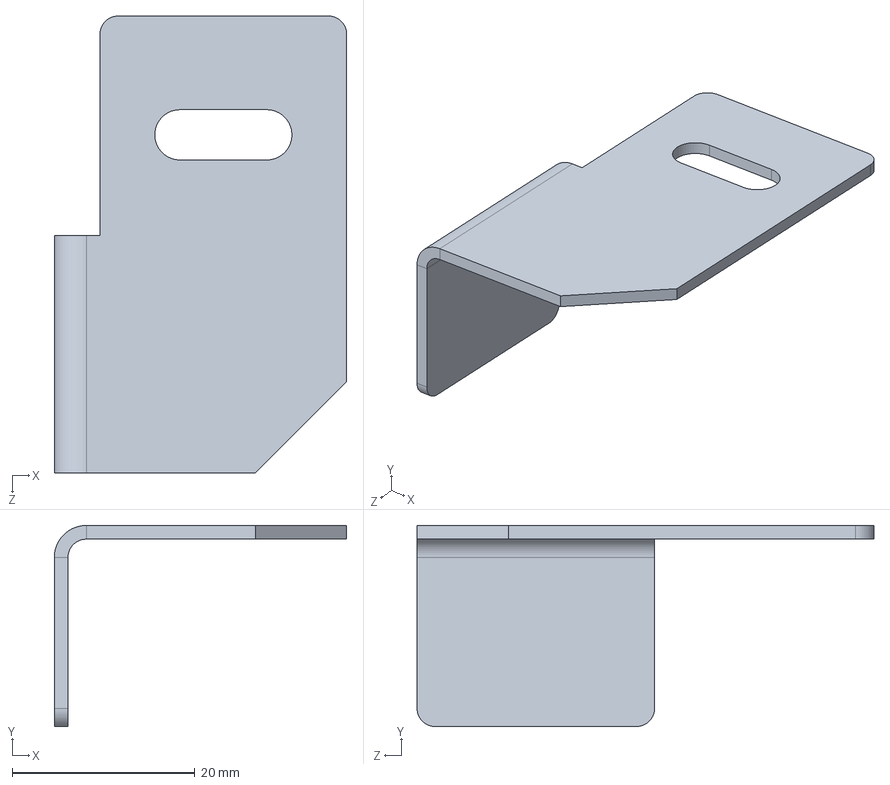
[picture p25: CAD file, 2026-11-09]
hardware/cad/step/parts/OBX-P018_Stal węglowa_1.5mm_szt_REV.STEP
32.0 x 22.0 x 50.0 mm
