obotx/diy-robot-kit/hardware/cad/solidworks/OBX-P023.SLDPRT

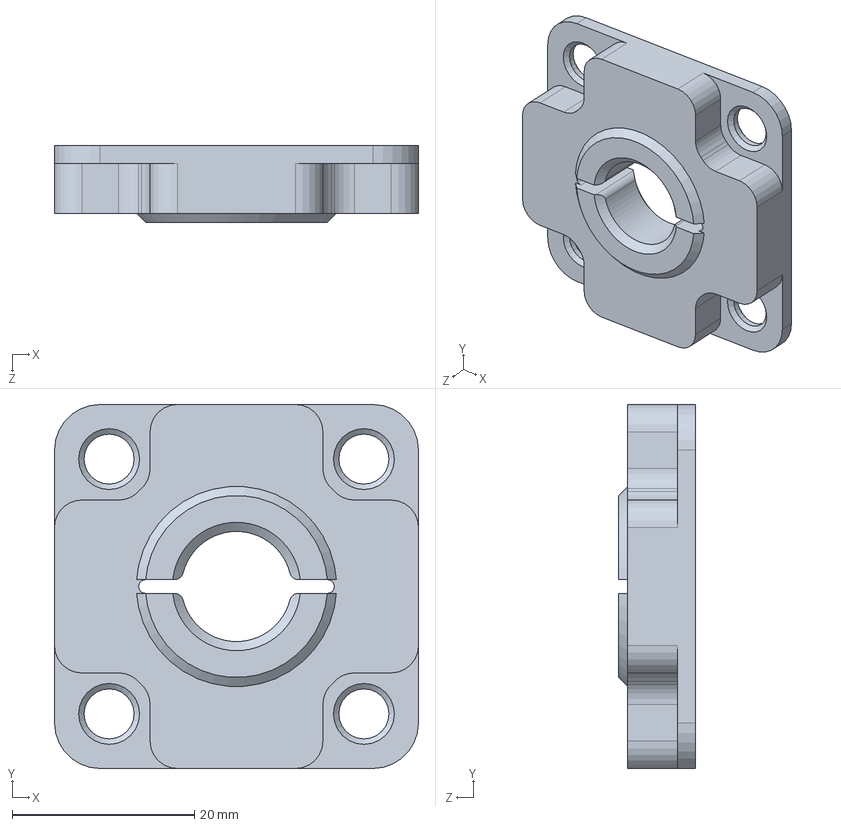
[picture p26: CAD file, 2026-11-09]
hardware/cad/solidworks/OBX-P023.SLDPRT
40.0 x 40.0 x 8.50 mm
