obotx/diy-robot-kit/hardware/cad/step/parts/OBX-P032_6063-T1_3mm_szt_REV.STEP

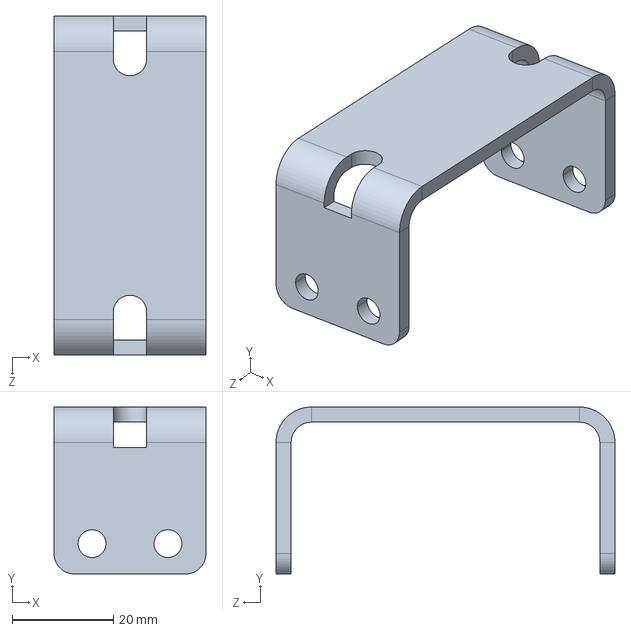
[picture p28: CAD file, 2026-11-09]
hardware/cad/step/parts/OBX-P032_6063-T1_3mm_szt_REV.STEP
30.0 x 33.0 x 67.0 mm
