obotx/diy-robot-kit/hardware/cad/solidworks/OBX-P006.SLDPRT

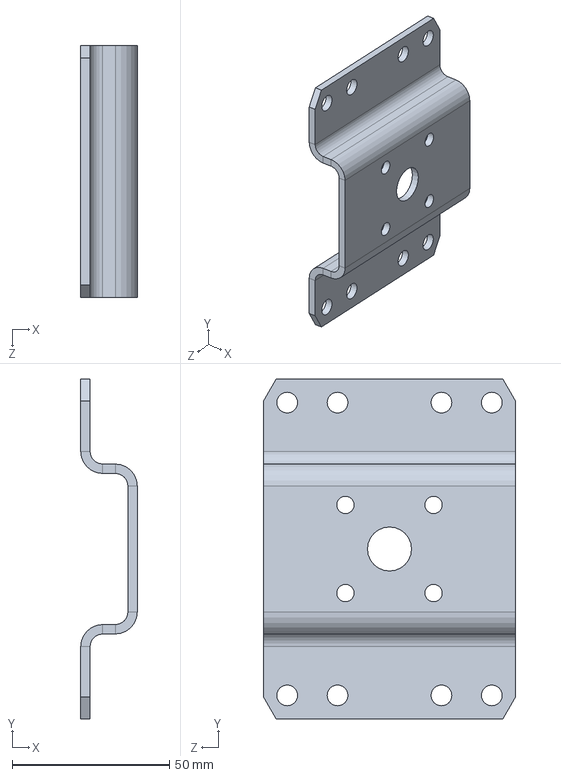
[picture p29: CAD file, 2026-11-09]
hardware/cad/solidworks/OBX-P006.SLDPRT
18.0 x 108.0 x 80.0 mm
