obotx/diy-robot-kit/hardware/cad/step/assemblies/OBX-A012__mm_szt_REV.STEP

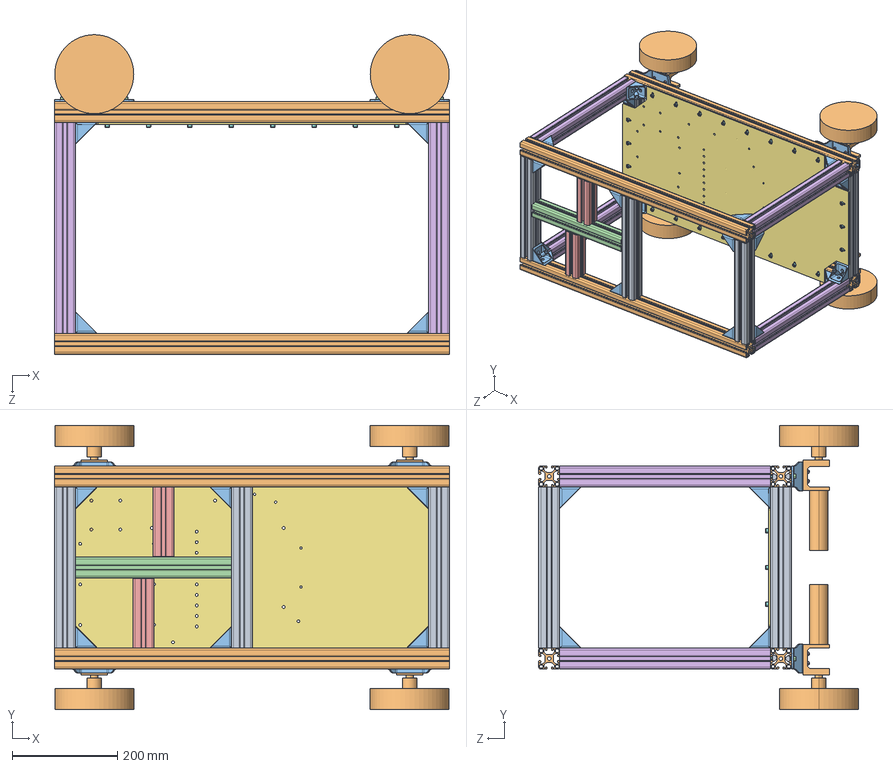
[picture p30: CAD file, 2026-11-09]
hardware/cad/step/assemblies/OBX-A012__mm_szt_REV.STEP
750.0 x 540.0 x 607.0 mm
OBX-P001 x 5
OBX-P002 x 4
FI3K4040M x 22
OBX-P013
OBX-P014 x 2
OBX-P021 x 4
OBX-P034
DIN 912 M5 x 16 --- 16N_DIN 912 M5 x 16 --- 16N x 22
Nakrętka wpustowa z kulką 8 M5 ITEM x 30
OMNI WHEEL + MOTOR x 4
OBX-P025 x 4
DIN 912 M5 x 12 --- 12N_DIN 912 M5 x 12 --- 12N x 8
DIN 912 M4 x 16 --- 16N_DIN 912 M4 x 16 --- 16N x 16
ISO - 4032 - M4 - W - N_ISO - 4032 - M4 - W - N x 16
