obotx/diy-robot-kit/hardware/cad/solidworks/TULEJA B-12-15-12-18-1,5.SLDPRT

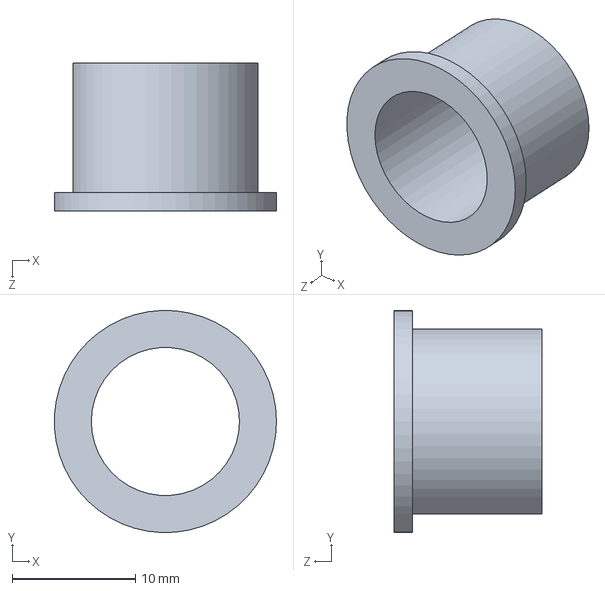
[picture p31: CAD file, 2026-11-09]
hardware/cad/solidworks/TULEJA B-12-15-12-18-1,5.SLDPRT
18.0 x 18.0 x 12.0 mm
