obotx/diy-robot-kit/hardware/cad/step/assemblies/OBX-A004__mm_szt_REV.STEP

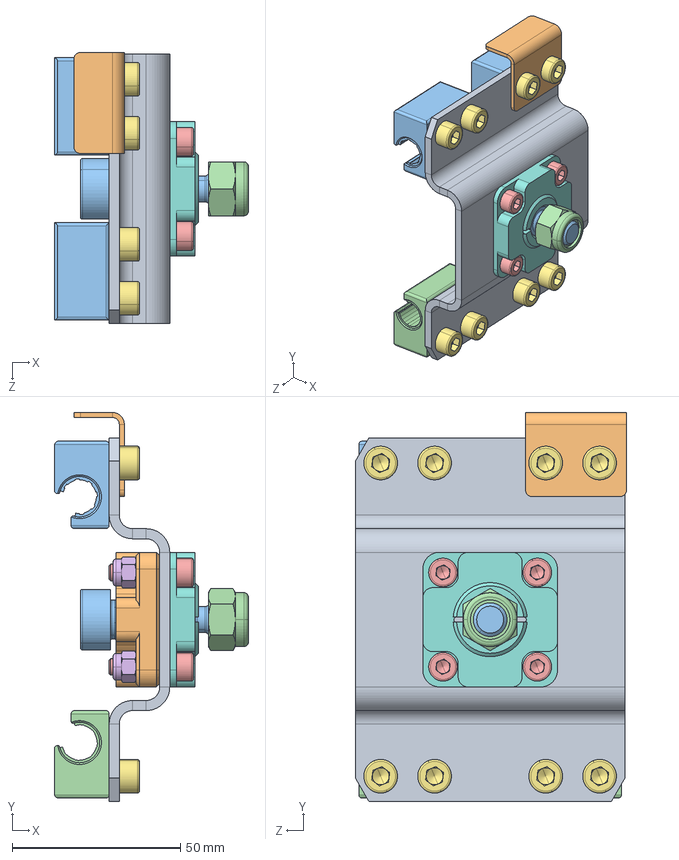
[picture p32: CAD file, 2026-11-09]
hardware/cad/step/assemblies/OBX-A004__mm_szt_REV.STEP
57.7 x 115.5 x 80.5 mm
OBX-P006
OBX-P022
IGUS WJ200UM_01_10 x 2
IGGUS WJ200UM_01_10_LL x 2
DIN 912 M5 x 20 --- 20N_DIN 912 M5 x 20 --- 20N x 4
DIN EN ISO 7040 - M5 - N_DIN EN ISO 7040 - M5 - N x 4
DIN 912 M6 x 16 --- 16N_DIN 912 M6 x 16 --- 16N x 8
OBX-P023
TULEJA B-12-15-12-18-1,5
OBX-P016
Shoulder screw ISO 7379-12-M10-25
DIN EN ISO 7040 - M10 - N_DIN EN ISO 7040 - M10 - N
