obotx/diy-robot-kit/hardware/cad/step/parts/OBX-P010_7075-O (SS)_3mm_szt_REV.STEP

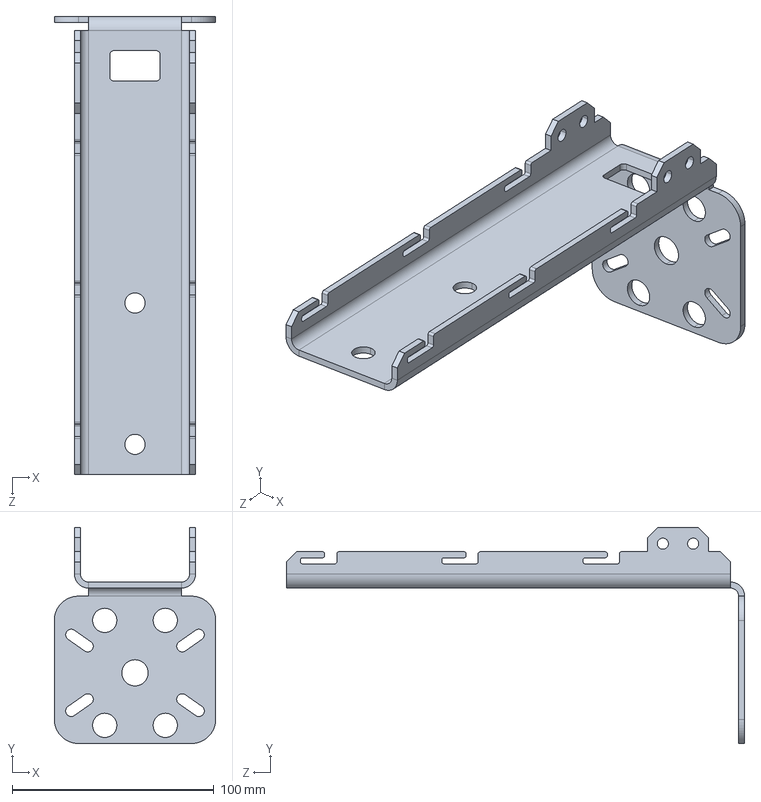
[picture p33: CAD file, 2026-11-09]
hardware/cad/step/parts/OBX-P010_7075-O (SS)_3mm_szt_REV.STEP
80.0 x 107.0 x 227.0 mm
