obotx/diy-robot-kit/hardware/cad/step/parts/OBX-P009_7075-O (SS)_3mm_szt_REV.STEP

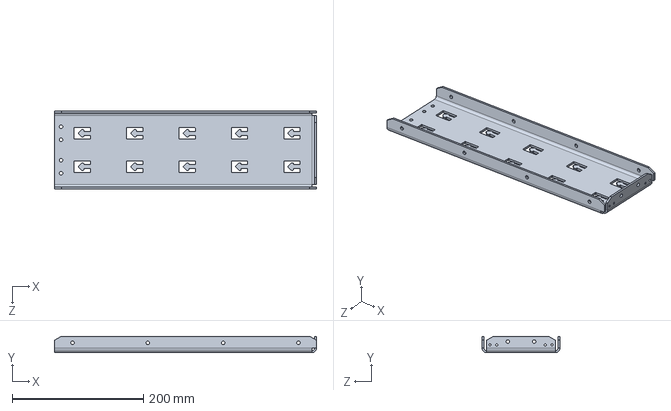
[picture p34: CAD file, 2026-11-09]
hardware/cad/step/parts/OBX-P009_7075-O (SS)_3mm_szt_REV.STEP
400.0 x 25.0 x 119.0 mm
