obotx/diy-robot-kit/hardware/cad/step/parts/OBX-P005_7075-O (SS)_3mm_szt_REV.STEP

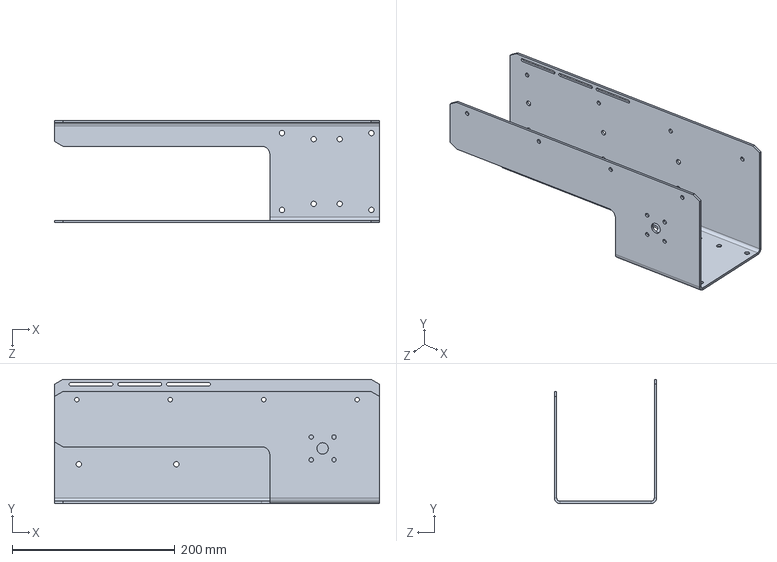
[picture p35: CAD file, 2026-11-09]
hardware/cad/step/parts/OBX-P005_7075-O (SS)_3mm_szt_REV.STEP
400.0 x 153.0 x 126.0 mm
