obotx/diy-robot-kit/hardware/cad/step/parts/OBX-P008_7075-O (SS)_3mm_szt_REV.STEP

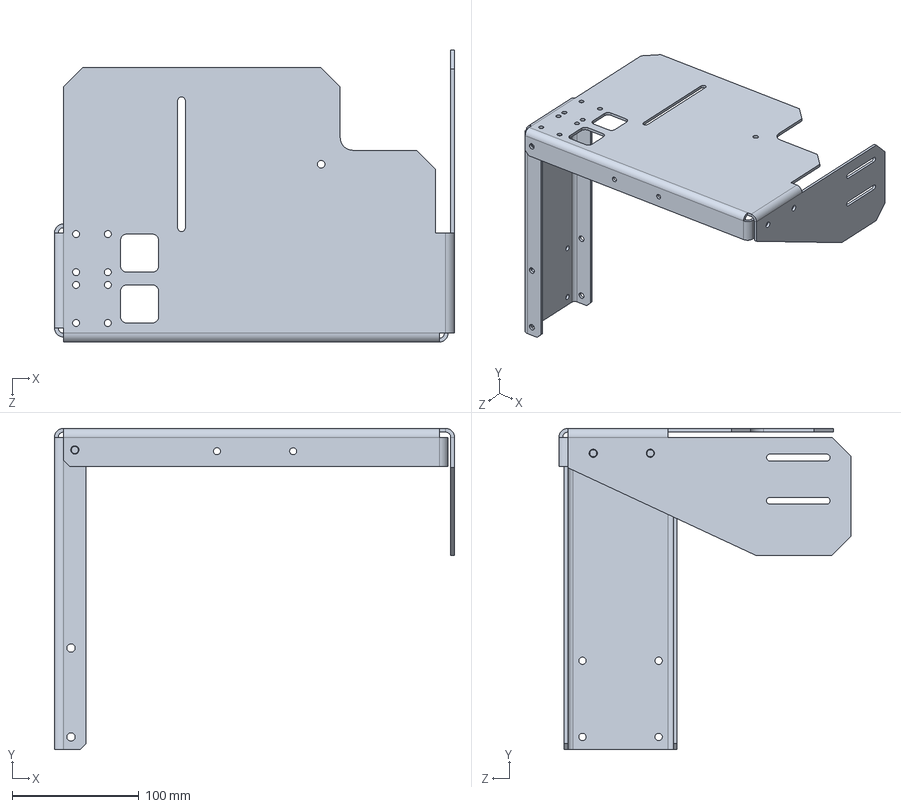
[picture p36: CAD file, 2026-11-09]
hardware/cad/step/parts/OBX-P008_7075-O (SS)_3mm_szt_REV.STEP
315.0 x 253.0 x 230.0 mm
