obotx/diy-robot-kit/hardware/cad/solidworks/IGGUS WJ200UM_01_10_LL.SLDPRT

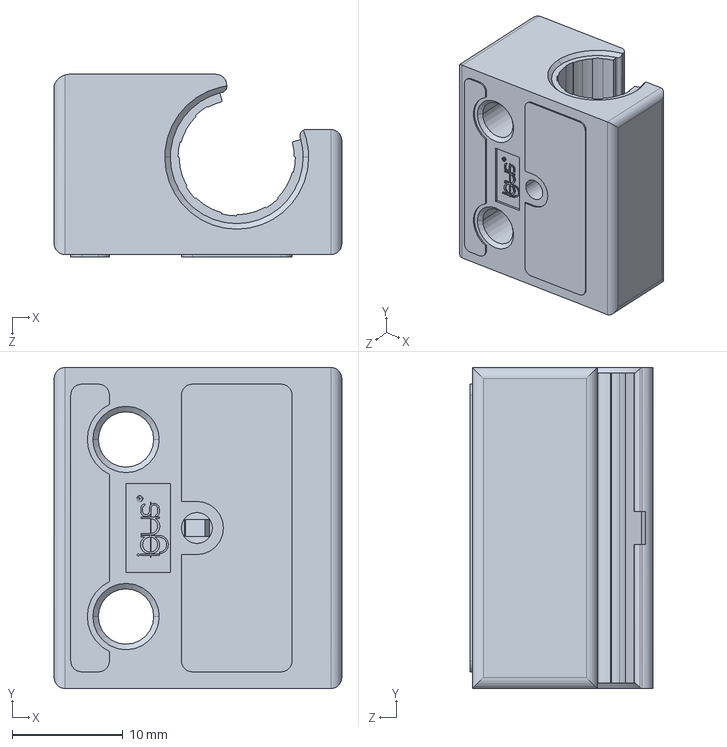
[picture p37: CAD file, 2026-11-09]
hardware/cad/solidworks/IGGUS WJ200UM_01_10_LL.SLDPRT
26.0 x 29.0 x 16.5 mm
