obotx/diy-robot-kit/hardware/cad/solidworks/Szpula Diall 8 x 50 mm.SLDPRT

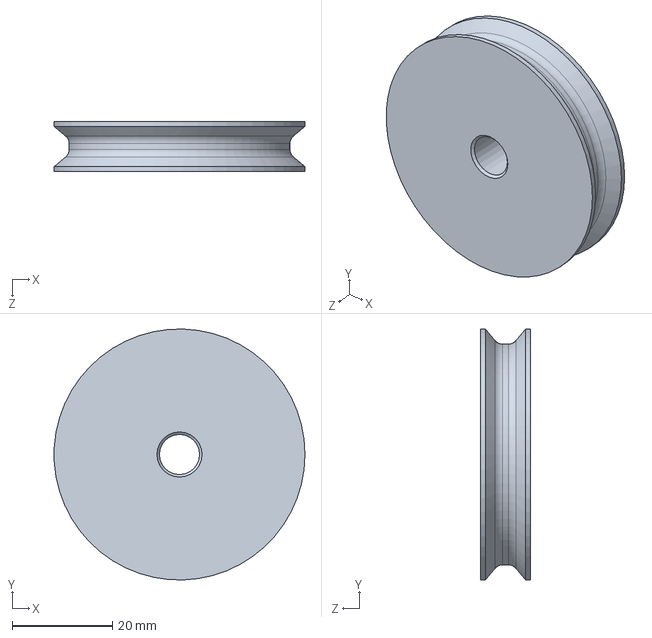
[picture p38: CAD file, 2026-11-09]
hardware/cad/solidworks/Szpula Diall 8 x 50 mm.SLDPRT
50.0 x 50.0 x 10.0 mm
