obotx/diy-robot-kit/hardware/cad/step/parts/OBX-P031_6061-O (SS)_3mm_szt_REV.STEP

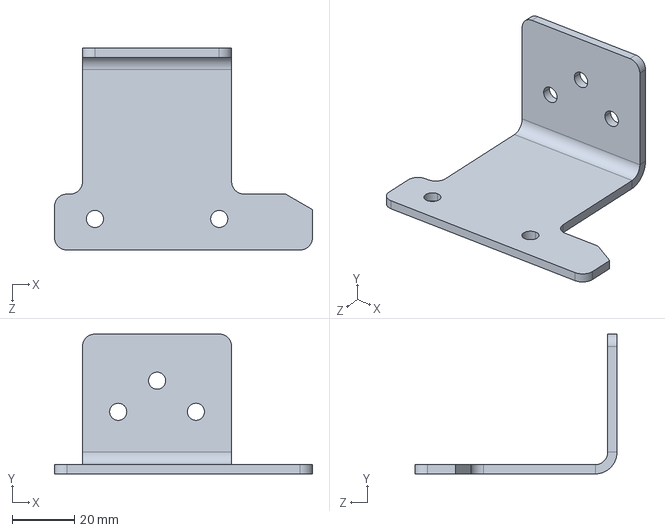
[picture p39: CAD file, 2026-11-09]
hardware/cad/step/parts/OBX-P031_6061-O (SS)_3mm_szt_REV.STEP
83.0 x 45.0 x 65.0 mm
