obotx/diy-robot-kit/hardware/cad/step/parts/OBX-P038_6063-T1_4mm_szt_REV.STEP

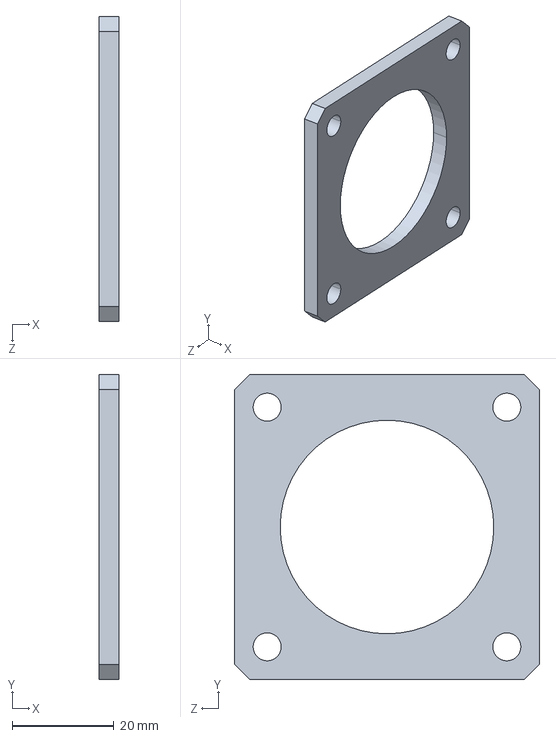
[picture p40: CAD file, 2026-11-09]
hardware/cad/step/parts/OBX-P038_6063-T1_4mm_szt_REV.STEP
4.00 x 60.0 x 60.0 mm
