obotx/diy-robot-kit/hardware/cad/solidworks/OBX-P021.SLDPRT

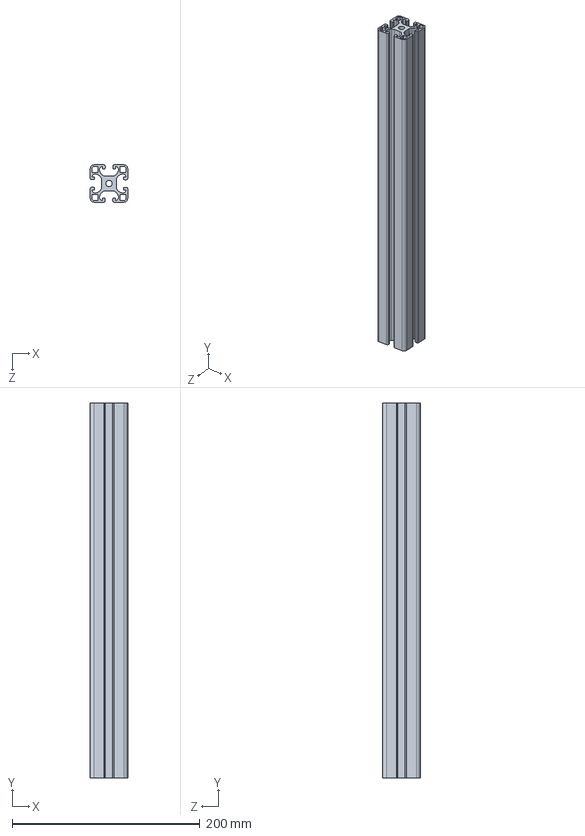
[picture p41: CAD file, 2026-11-09]
hardware/cad/solidworks/OBX-P021.SLDPRT
40.0 x 400.0 x 40.0 mm
