obotx/diy-robot-kit/hardware/cad/step/parts/OBX-P007_7075-O (SS)_3mm_szt_REV.STEP

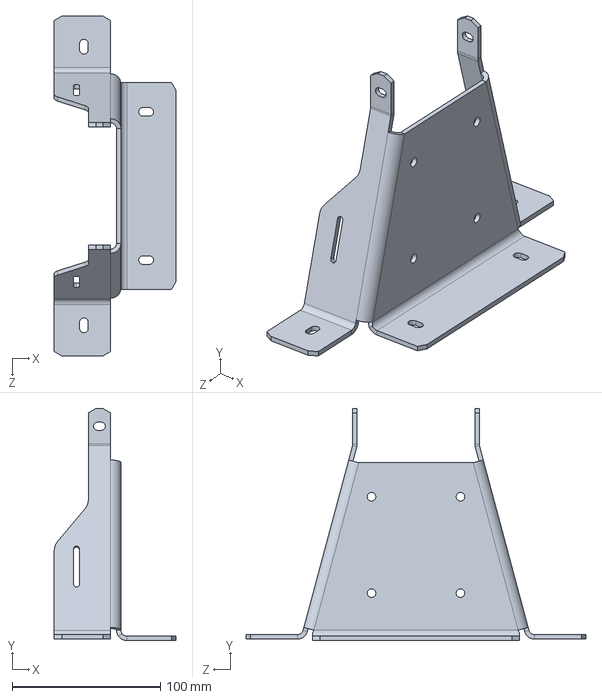
[picture p42: CAD file, 2026-11-09]
hardware/cad/step/parts/OBX-P007_7075-O (SS)_3mm_szt_REV.STEP
82.0 x 156.6 x 229.4 mm
