obotx/diy-robot-kit/hardware/cad/step/parts/OBX-P035_6063-T1_3mm_szt_REV.STEP

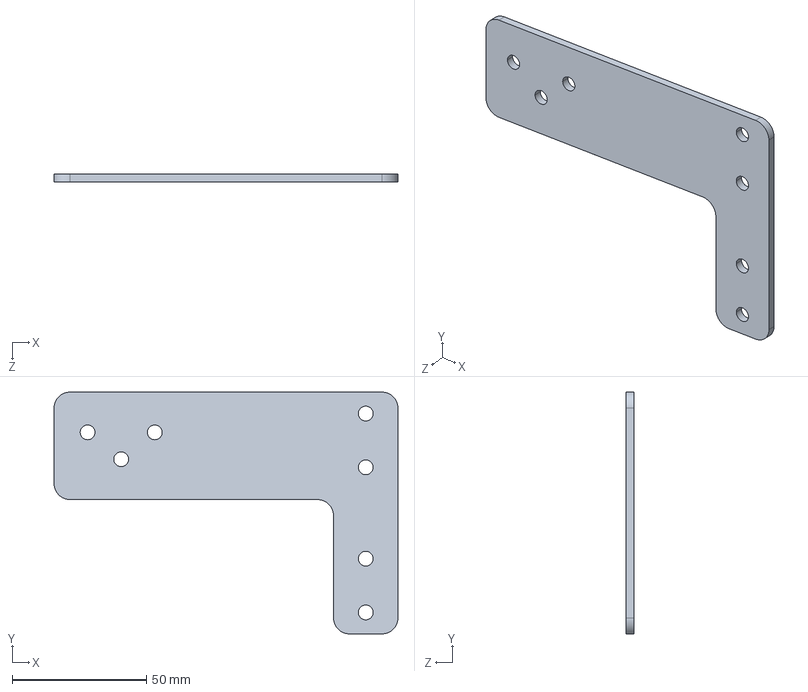
[picture p43: CAD file, 2026-11-09]
hardware/cad/step/parts/OBX-P035_6063-T1_3mm_szt_REV.STEP
128.0 x 90.0 x 3.00 mm
