obotx/diy-robot-kit/hardware/cad/solidworks/JM30C.SLDPRT

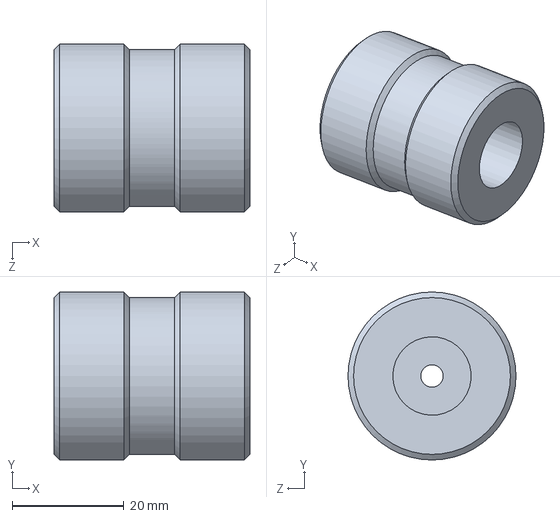
[picture p44: CAD file, 2026-11-09]
hardware/cad/solidworks/JM30C.SLDPRT
35.0 x 30.0 x 30.0 mm
