obotx/diy-robot-kit/hardware/cad/step/parts/OBX-P017_6063-T1_3mm_szt_REV.STEP

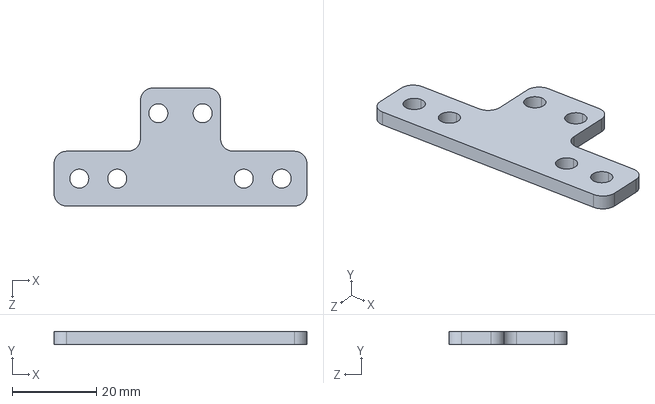
[picture p45: CAD file, 2026-11-09]
hardware/cad/step/parts/OBX-P017_6063-T1_3mm_szt_REV.STEP
60.0 x 3.00 x 28.0 mm
