obotx/diy-robot-kit/hardware/cad/solidworks/OBX-P026.SLDPRT

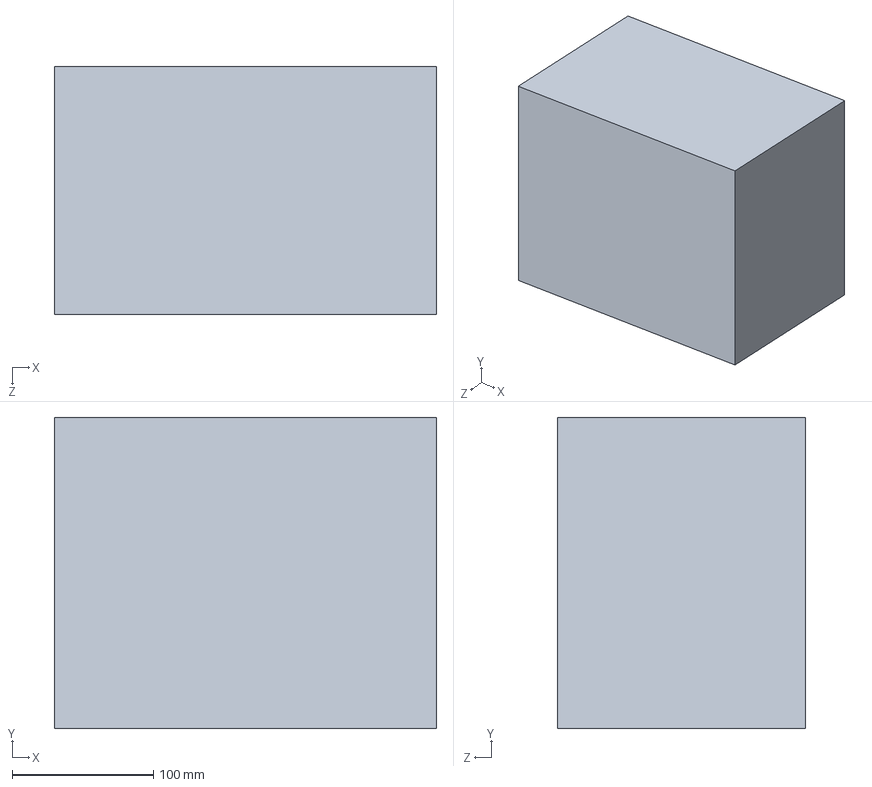
[picture p46: CAD file, 2026-11-09]
hardware/cad/solidworks/OBX-P026.SLDPRT
270.0 x 220.0 x 175.0 mm
