obotx/diy-robot-kit/hardware/cad/solidworks/60________-0.SLDPRT

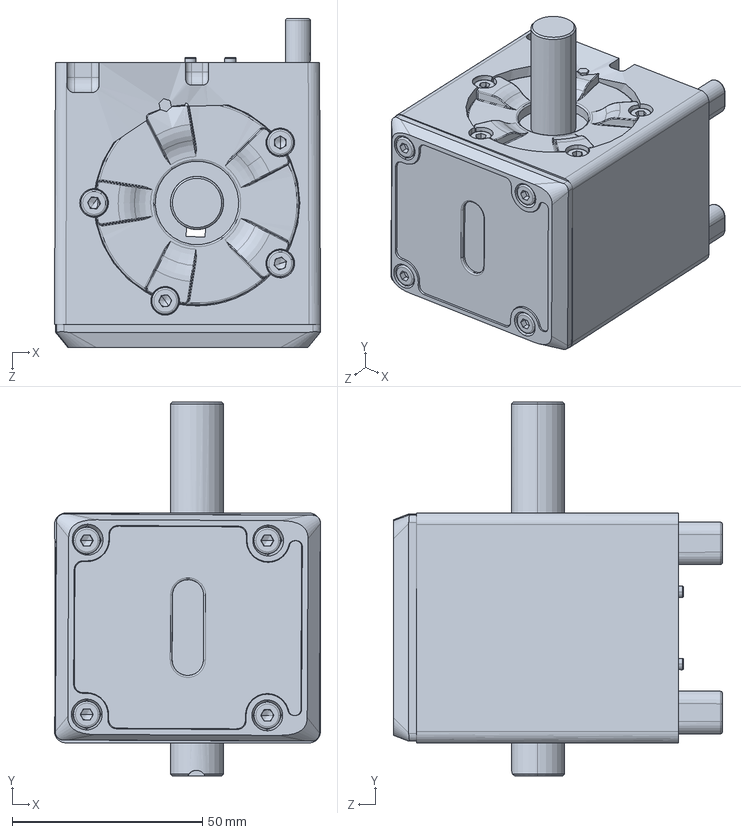
[picture p47: CAD file, 2026-11-09]
hardware/cad/solidworks/60________-0.SLDPRT
70.0 x 98.4 x 86.5 mm
