obotx/diy-robot-kit/hardware/cad/step/parts/OBX-P019_Stal węglowa_1.5mm_szt_REV.STEP

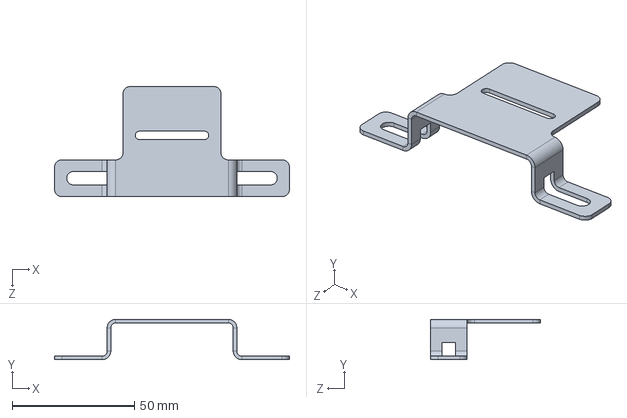
[picture p48: CAD file, 2026-11-09]
hardware/cad/step/parts/OBX-P019_Stal węglowa_1.5mm_szt_REV.STEP
96.0 x 16.5 x 45.0 mm
