obotx/diy-robot-kit/hardware/cad/step/parts/OBX-P029_Stal węglowa_2mm_szt_REV.STEP

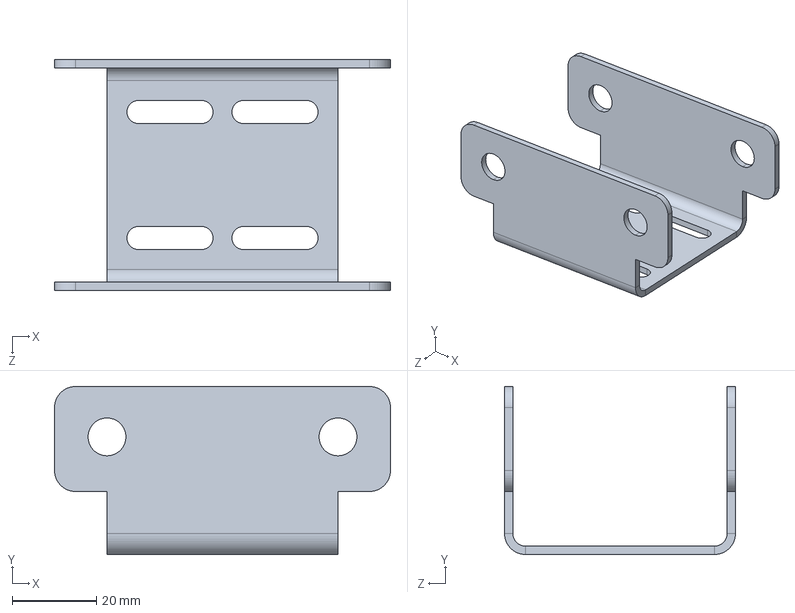
[picture p49: CAD file, 2026-11-09]
hardware/cad/step/parts/OBX-P029_Stal węglowa_2mm_szt_REV.STEP
80.0 x 40.0 x 55.0 mm
