obotx/diy-robot-kit/hardware/cad/solidworks/OBX-P014.SLDPRT

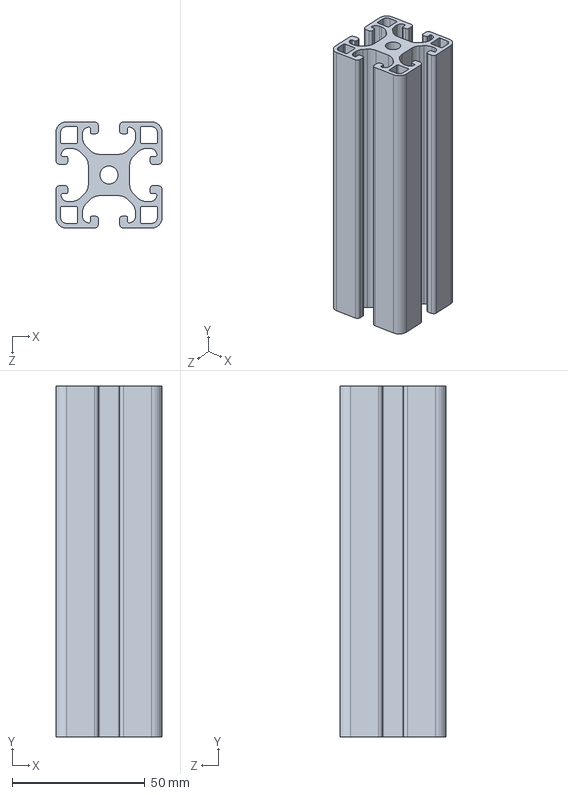
[picture p50: CAD file, 2026-11-09]
hardware/cad/solidworks/OBX-P014.SLDPRT
40.0 x 132.0 x 40.0 mm
