obotx/diy-robot-kit/hardware/cad/solidworks/Nakrętka wpustowa z kulką 8 M5 ITEM.SLDPRT

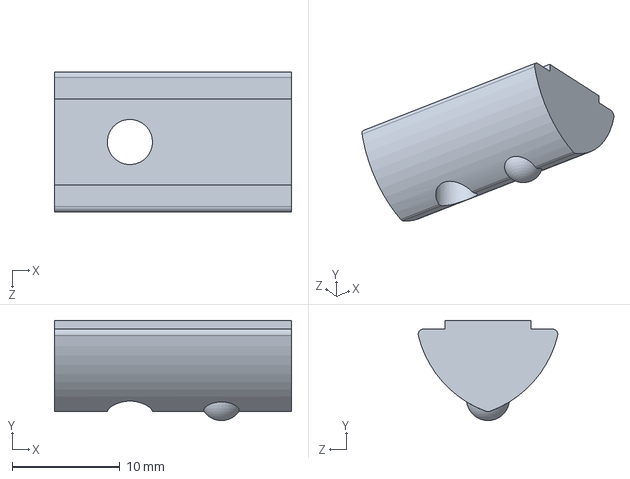
[picture p51: CAD file, 2026-11-09]
hardware/cad/solidworks/Nakrętka wpustowa z kulką 8 M5 ITEM.SLDPRT
22.0 x 9.30 x 13.0 mm
