obotx/diy-robot-kit/hardware/cad/solidworks/NEMA 23 2,3 kN 57EBP105ALC-TF0.SLDPRT

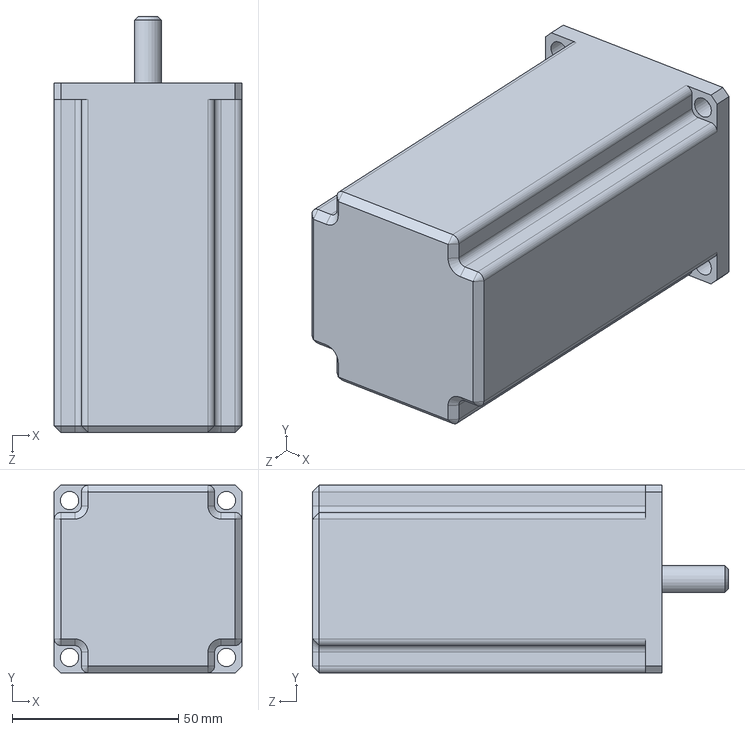
[picture p52: CAD file, 2026-11-09]
hardware/cad/solidworks/NEMA 23 2,3 kN 57EBP105ALC-TF0.SLDPRT
56.4 x 56.4 x 125.0 mm
