obotx/diy-robot-kit/hardware/cad/solidworks/OBX-P018.SLDPRT

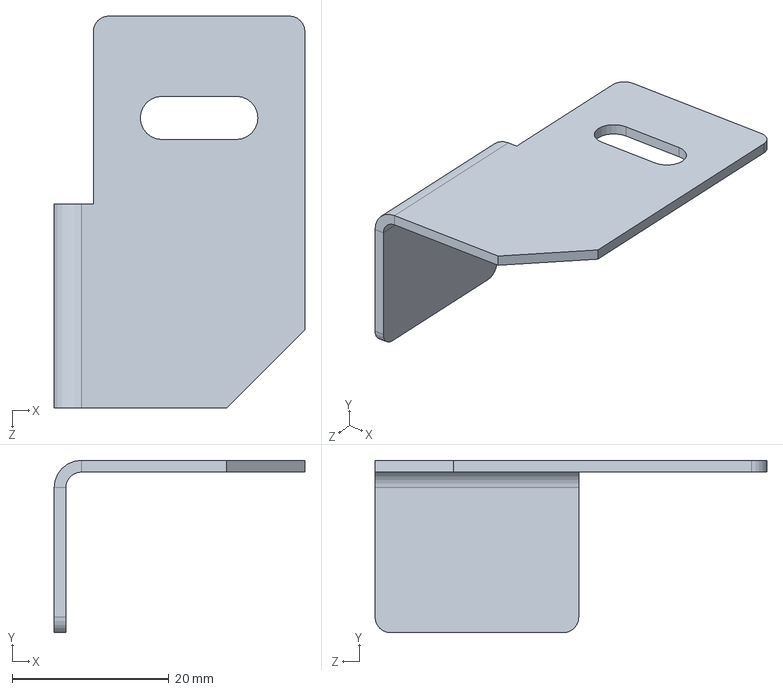
[picture p53: CAD file, 2026-11-09]
hardware/cad/solidworks/OBX-P018.SLDPRT
32.0 x 22.0 x 50.0 mm
