obotx/diy-robot-kit/hardware/cad/solidworks/CZUJNIK KRAŃCOWY.SLDPRT

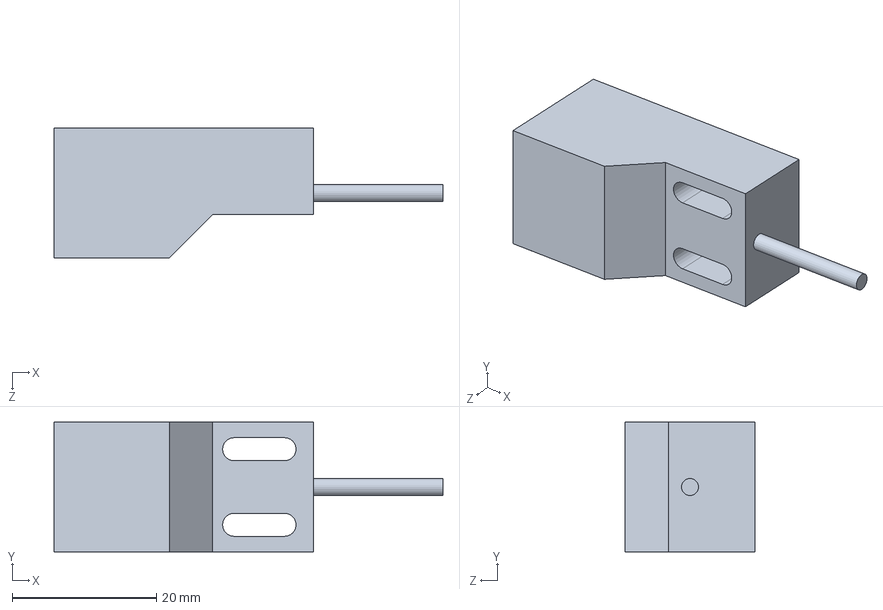
[picture p54: CAD file, 2026-11-09]
hardware/cad/solidworks/CZUJNIK KRAŃCOWY.SLDPRT
54.0 x 18.0 x 18.0 mm
