obotx/diy-robot-kit/hardware/cad/solidworks/BALANSER.SLDPRT

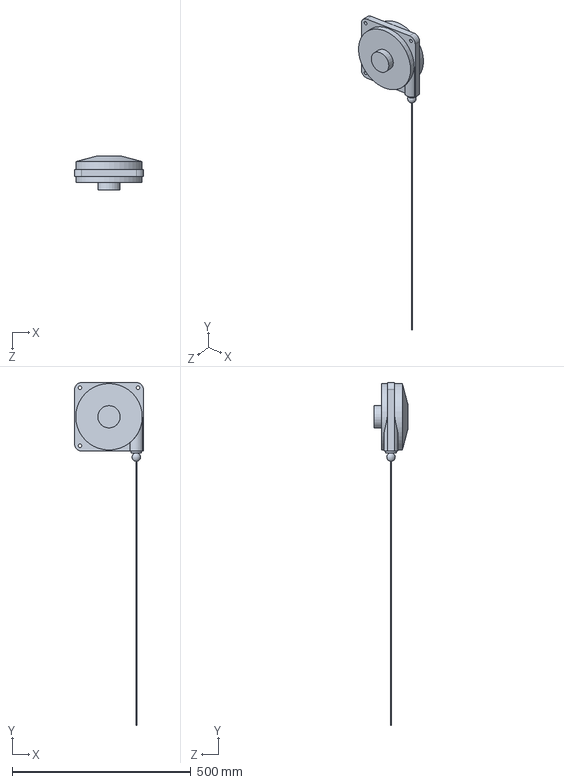
[picture p55: CAD file, 2026-11-09]
hardware/cad/solidworks/BALANSER.SLDPRT
193.0 x 960.8 x 95.0 mm
