obotx/diy-robot-kit/hardware/cad/solidworks/OBX-P019.SLDPRT

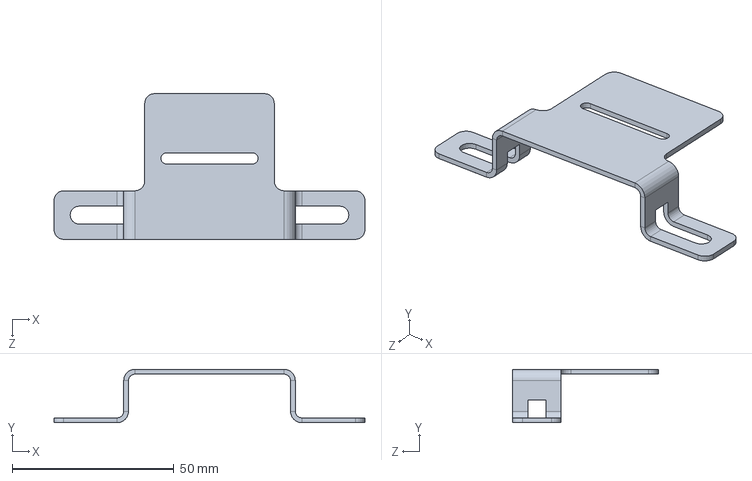
[picture p56: CAD file, 2026-11-09]
hardware/cad/solidworks/OBX-P019.SLDPRT
96.0 x 16.5 x 45.0 mm
