obotx/diy-robot-kit/hardware/cad/solidworks/HPS60-05SW.SLDPRT

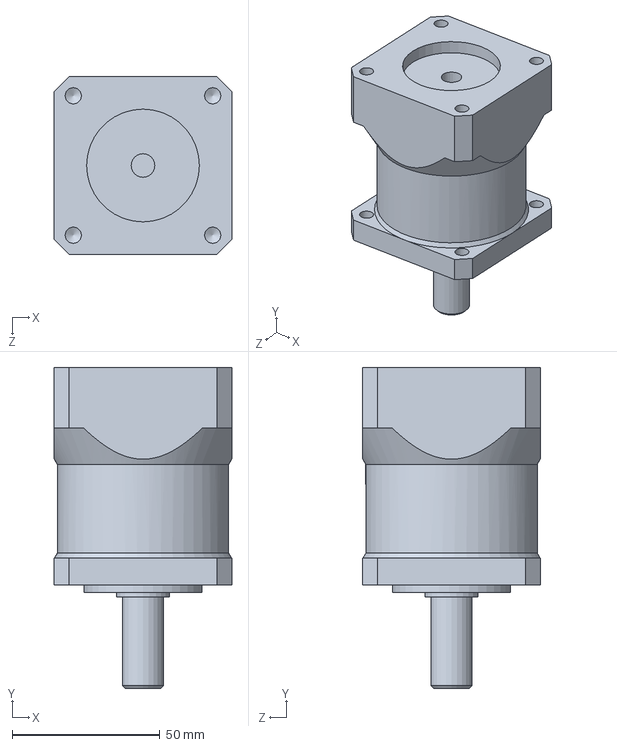
[picture p57: CAD file, 2026-11-09]
hardware/cad/solidworks/HPS60-05SW.SLDPRT
60.0 x 108.5 x 60.0 mm
