obotx/diy-robot-kit/hardware/cad/solidworks/60C____.SLDPRT

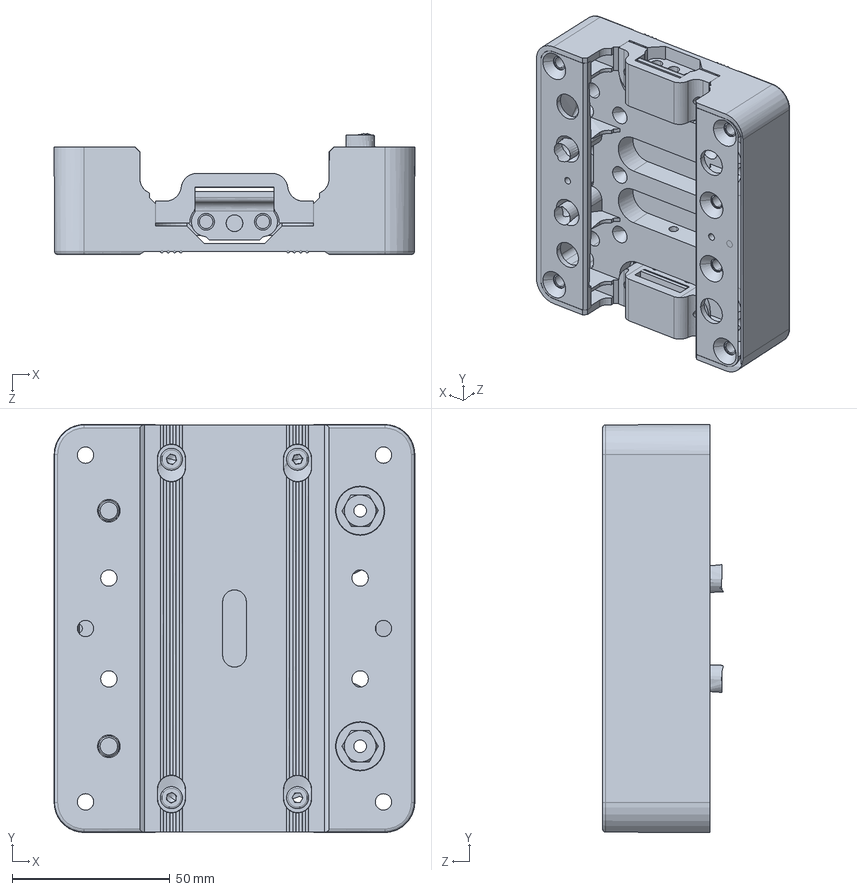
[picture p58: CAD file, 2026-11-09]
hardware/cad/solidworks/60C____.SLDPRT
114.4 x 129.4 x 38.3 mm
