obotx/diy-robot-kit/hardware/cad/solidworks/60______(______).SLDPRT

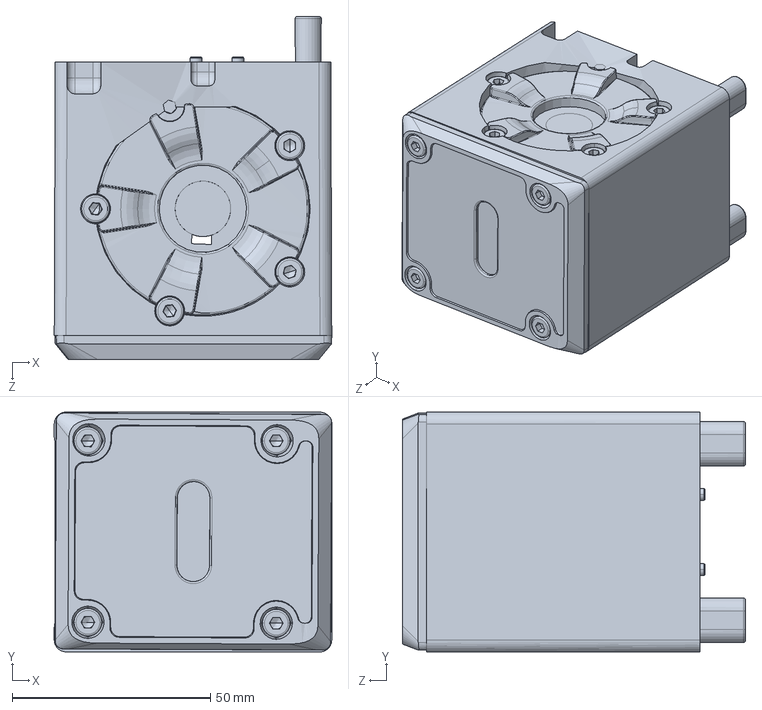
[picture p59: CAD file, 2026-11-09]
hardware/cad/solidworks/60______(______).SLDPRT
70.0 x 60.5 x 86.5 mm
