obotx/diy-robot-kit/hardware/cad/solidworks/OBX-P002.SLDPRT

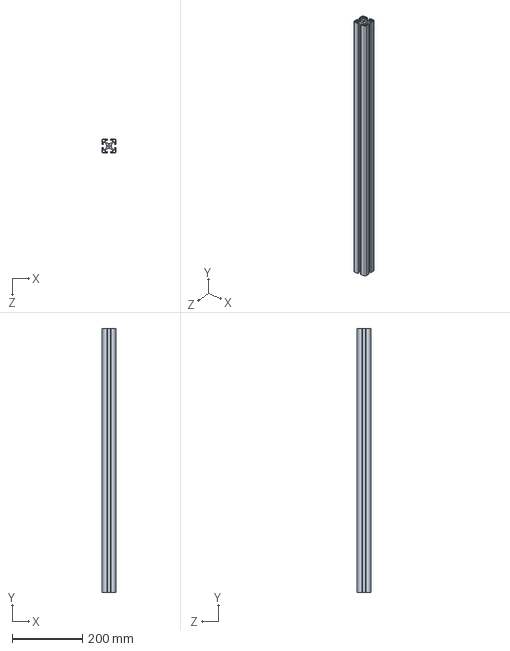
[picture p60: CAD file, 2026-11-09]
hardware/cad/solidworks/OBX-P002.SLDPRT
40.0 x 750.0 x 40.0 mm
