obotx/diy-robot-kit/hardware/cad/solidworks/KGX80-1000.SLDPRT

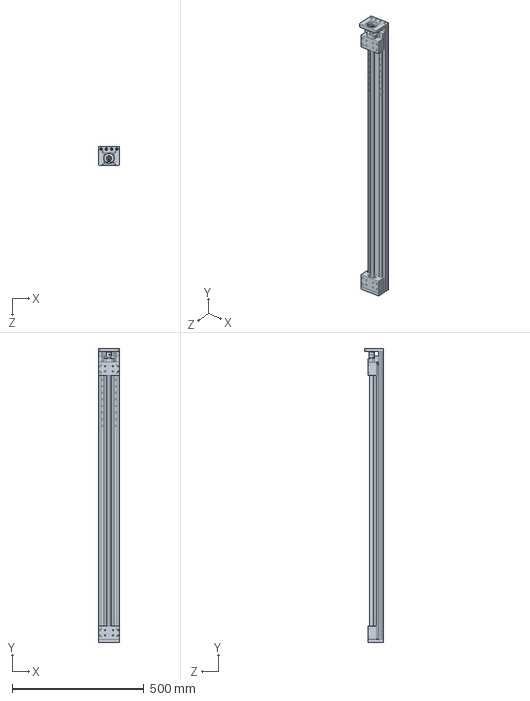
[picture p61: CAD file, 2026-11-09]
hardware/cad/solidworks/KGX80-1000.SLDPRT
80.0 x 1114.0 x 72.5 mm
