obotx/diy-robot-kit/hardware/cad/solidworks/IGUS WJ200UM_01_10.SLDPRT

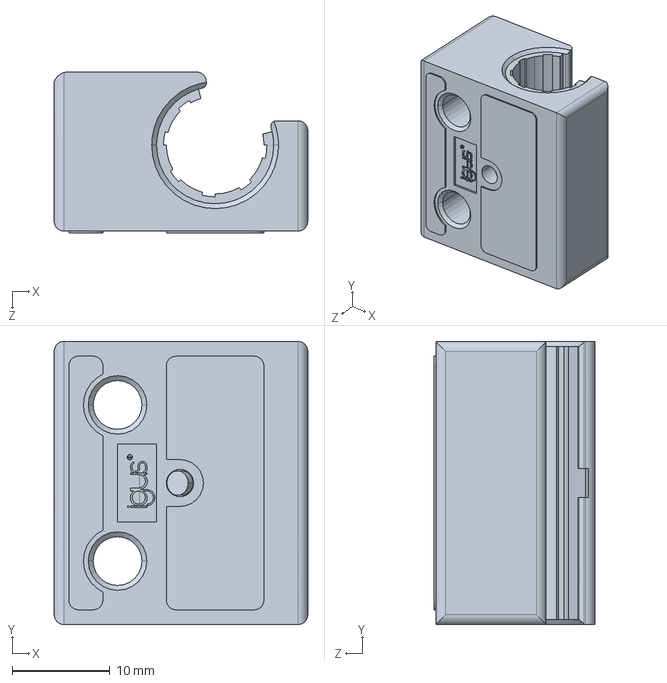
[picture p62: CAD file, 2026-11-09]
hardware/cad/solidworks/IGUS WJ200UM_01_10.SLDPRT
26.0 x 29.0 x 16.5 mm
