obotx/diy-robot-kit/hardware/cad/solidworks/OBX-P001.SLDPRT

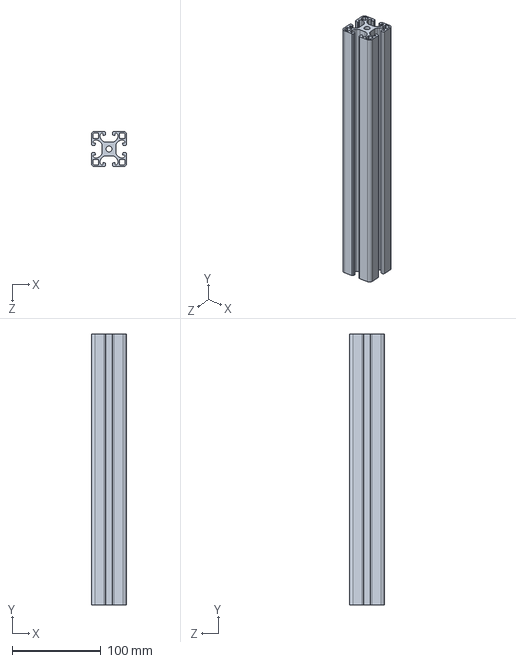
[picture p63: CAD file, 2026-11-09]
hardware/cad/solidworks/OBX-P001.SLDPRT
40.0 x 306.0 x 40.0 mm
