obotx/diy-robot-kit/hardware/cad/solidworks/OBX-P027.SLDPRT

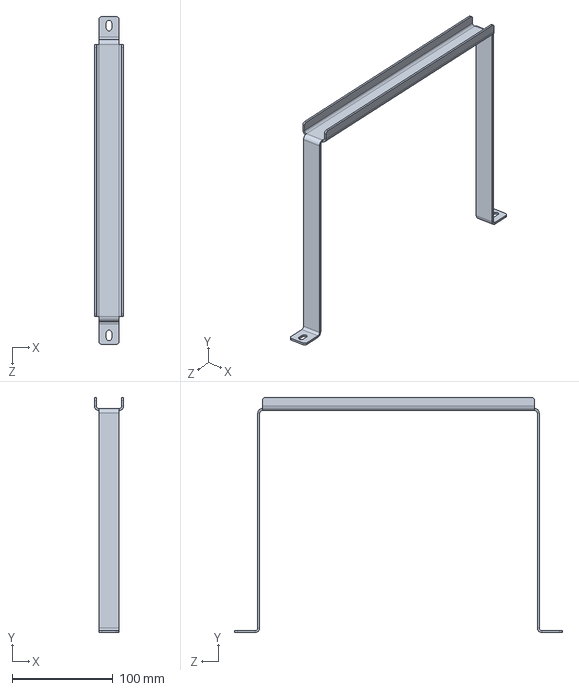
[picture p64: CAD file, 2026-11-09]
hardware/cad/solidworks/OBX-P027.SLDPRT
29.2 x 233.0 x 325.0 mm
