obotx/diy-robot-kit/hardware/cad/solidworks/OMNI WHEEL + MOTOR.SLDPRT

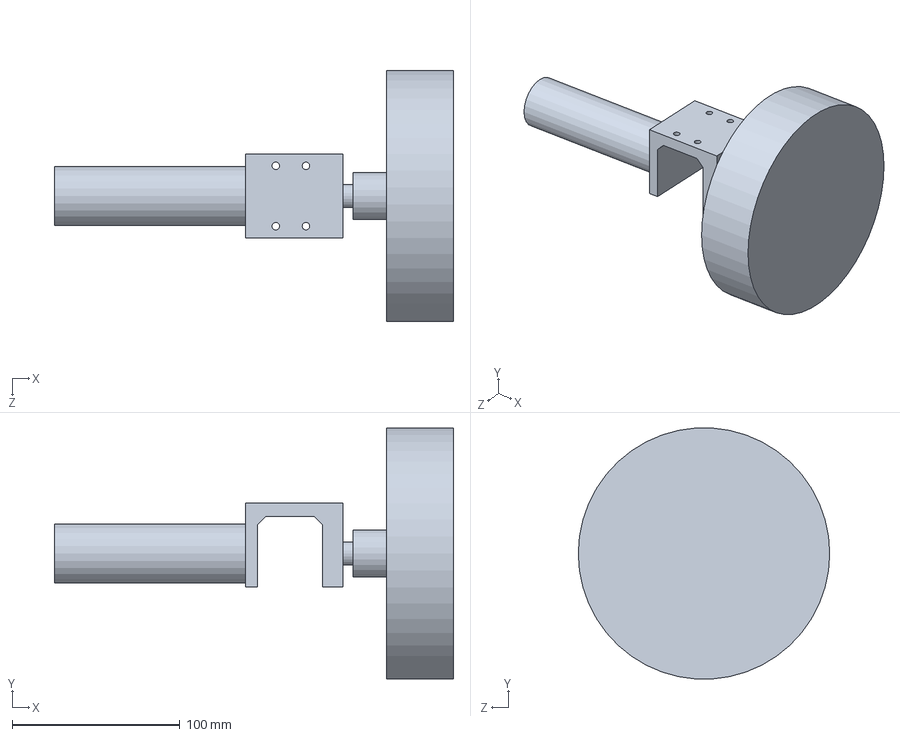
[picture p65: CAD file, 2026-11-09]
hardware/cad/solidworks/OMNI WHEEL + MOTOR.SLDPRT
238.0 x 149.7 x 150.0 mm
