obotx/diy-robot-kit/hardware/cad/solidworks/WS_10_300_1.SLDPRT

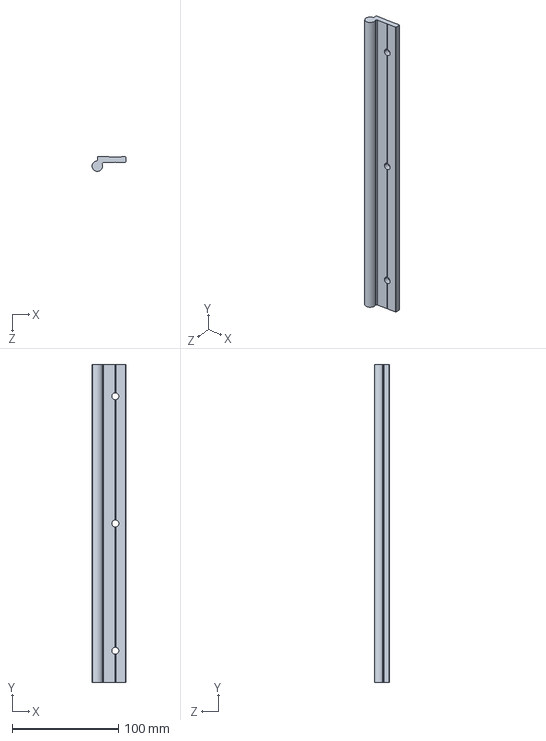
[picture p66: CAD file, 2026-11-09]
hardware/cad/solidworks/WS_10_300_1.SLDPRT
32.0 x 300.0 x 14.0 mm
