obotx/diy-robot-kit/hardware/cad/solidworks/FI3K4040M.SLDPRT

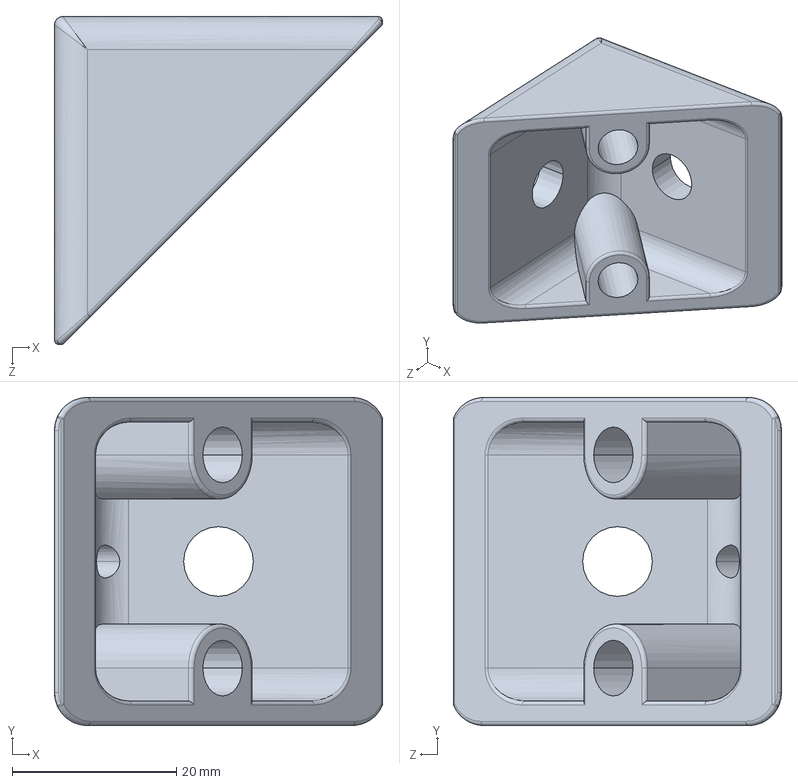
[picture p67: CAD file, 2026-11-09]
hardware/cad/solidworks/FI3K4040M.SLDPRT
40.0 x 40.0 x 40.0 mm
