obotx/diy-robot-kit/hardware/cad/solidworks/ŚRUBA PASOWANA ISO 7379-8-M6-55.SLDPRT

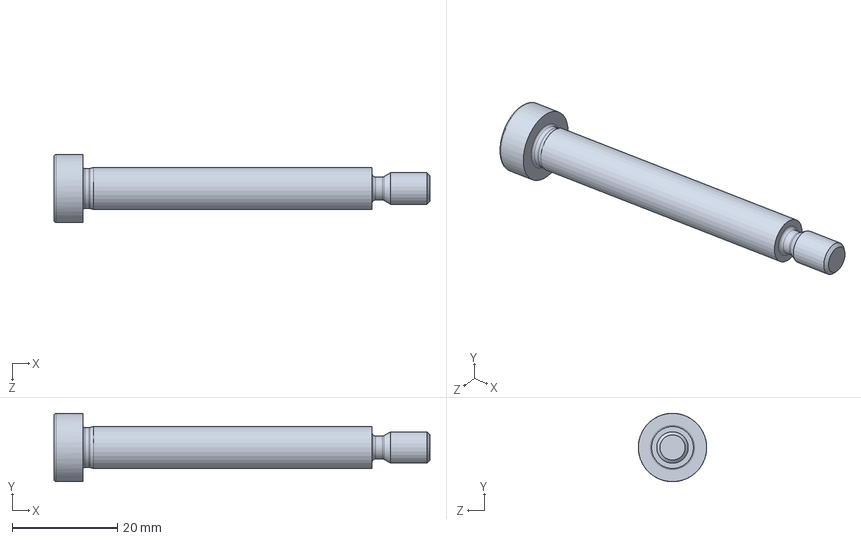
[picture p68: CAD file, 2026-11-09]
hardware/cad/solidworks/ŚRUBA PASOWANA ISO 7379-8-M6-55.SLDPRT
71.5 x 13.0 x 13.0 mm
