obotx/diy-robot-kit/hardware/cad/solidworks/OBX-P003.SLDPRT

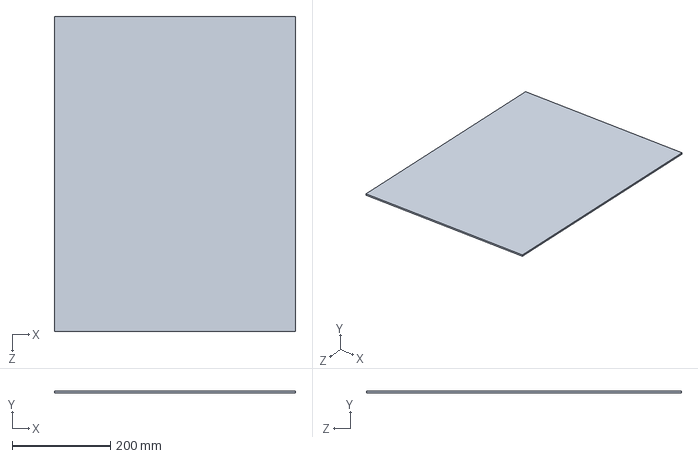
[picture p69: CAD file, 2026-11-09]
hardware/cad/solidworks/OBX-P003.SLDPRT
490.0 x 4.00 x 640.0 mm
