obotx/diy-robot-kit/hardware/cad/solidworks/OBX-A010.SLDASM

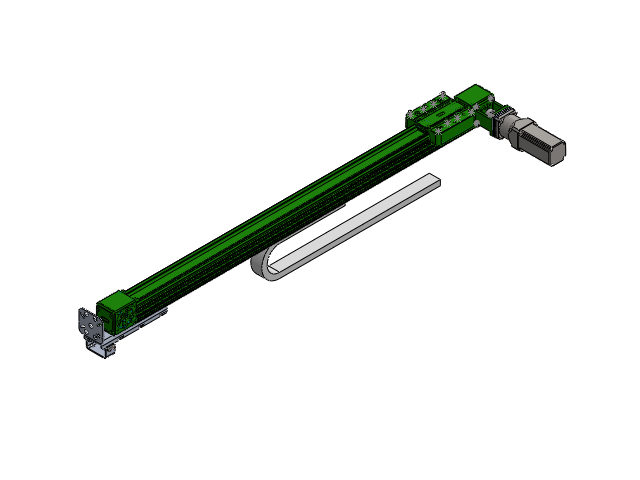
[picture p70: CAD file, 2026-11-09]
hardware/cad/solidworks/OBX-A010.SLDASM
60C____
OBX-P038 x 3
HPS60-05SW
NEMA 23 2,3 kN 57EBP105ALC-TF0
OBX-P010
OBX-P018
OBX-P032
DIN 912 M5 x 12 --- 12N x 5
ISO - 4032 - M5 - W - N x 8
Square nut DIN 557 M5 -N
Square nut DIN 557 M8 -N x 2
DIN 912 M8 x 12 --- 12N x 2
DIN 912 M6 x 16 --- 16N x 8
DIN 912 M5 x 16 --- 16N x 4
DIN 912 M5 x 35 --- 22N x 4
JM30C
OBX-P037
