obotx/diy-robot-kit/hardware/cad/solidworks/OBX-A007.SLDASM

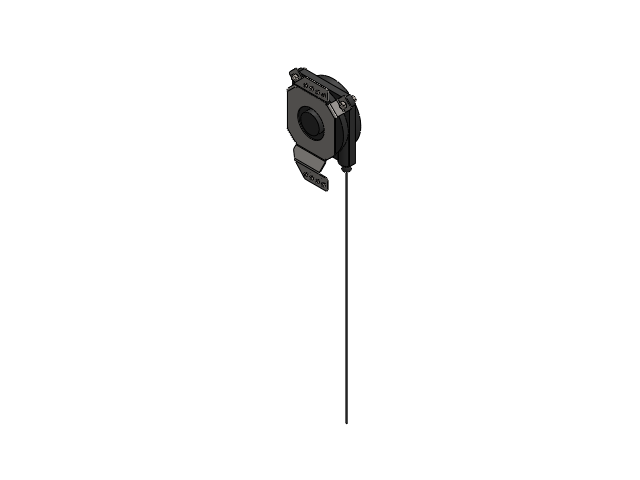
[picture p71: CAD file, 2026-11-09]
hardware/cad/solidworks/OBX-A007.SLDASM
BALANSER
OBX-P028
DIN 912 M10 x 35 --- 35N x 3
ISO - 4032 - M10 - W - N x 3
DIN 912 M5 x 10 --- 10N x 8
Square nut DIN 557 M5 -N x 8
