obotx/diy-robot-kit/hardware/cad/solidworks/OBX-A000.SLDASM

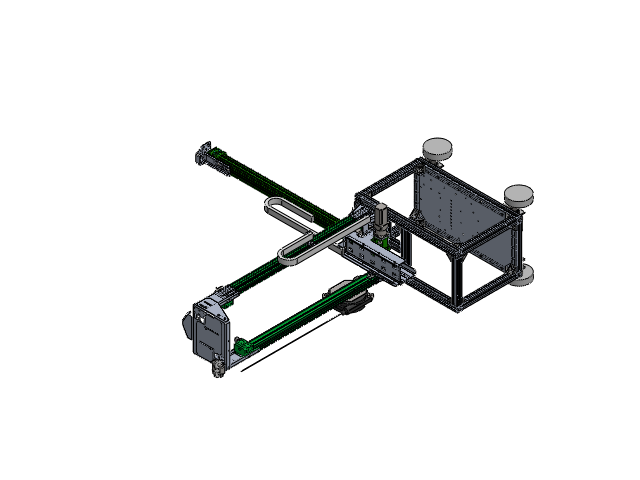
[picture p72: CAD file, 2026-11-09]
hardware/cad/solidworks/OBX-A000.SLDASM
OBX-P001 x 5
OBX-P002 x 4
FI3K4040M x 22
OBX-P013
OBX-P014 x 2
OBX-P021 x 4
OBX-P034
DIN 912 M5 x 16 --- 16N x 56
Nakrętka wpustowa z kulką 8 M5 ITEM x 38
OMNI WHEEL + MOTOR x 4
OBX-P025 x 4
DIN 912 M5 x 12 --- 12N x 69
DIN 912 M4 x 16 --- 16N x 16
ISO - 4032 - M4 - W - N x 16
60C____
OBX-P038 x 3
HPS60-05SW
NEMA 23 2,3 kN 57EBP105ALC-TF0
OBX-P010
OBX-P018
OBX-P032
ISO - 4032 - M5 - W - N x 54
Square nut DIN 557 M5 -N x 39
Square nut DIN 557 M8 -N x 2
DIN 912 M8 x 12 --- 12N x 2
DIN 912 M6 x 16 --- 16N x 22
DIN 912 M5 x 35 --- 22N x 4
JM30C
OBX-P037 x 2
OBX-P005
OBX-P022 x 2
WS_10_300_1 x 2
OBX-P009
DIN 912 M5 x 20 --- 20N x 8
OBX-P023 x 2
TULEJA B-12-15-12-18-1,5 x 2
OBX-P031
CZUJNIK KRAŃCOWY x 6
DIN 912 M3 x 20 --- 20N x 14
ISO - 4032 - M3 - W - N x 14
OBX-P017
Shoulder screw ISO 7379-12-M10-25 x 2
DIN EN ISO 7040 - M10 - N x 2
OBX-P006
IGUS WJ200UM_01_10 x 2
IGGUS WJ200UM_01_10_LL x 2
DIN EN ISO 7040 - M5 - N x 4
OBX-P016
OBX-P008 x 2
OBX-P019 x 2
KGX80-1000 x 2
OBX-P007 x 2
OBX-P004
OBX-P004M
OBX-P015 x 2
OBX-P033
OBX-P035
OBX-P036
BALANSER
OBX-P028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
