obotx/diy-robot-kit/hardware/cad/solidworks/OBX-A003.SLDASM

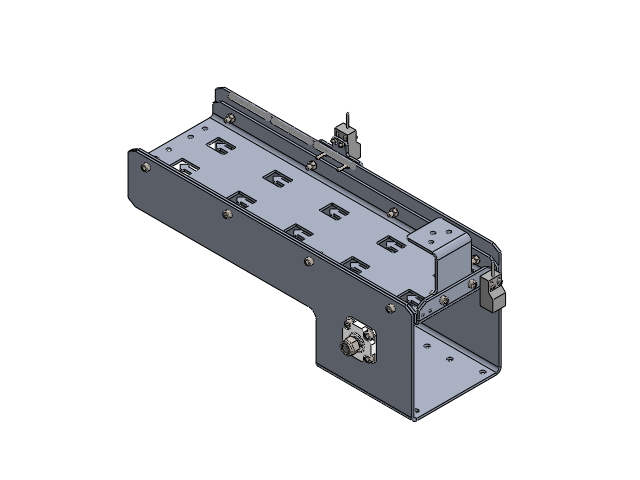
[picture p75: CAD file, 2026-11-09]
hardware/cad/solidworks/OBX-A003.SLDASM
OBX-P005
OBX-P022
WS_10_300_1 x 2
OBX-P009
OBX-P023
TULEJA B-12-15-12-18-1,5
OBX-P031
CZUJNIK KRAŃCOWY x 2
OBX-P017
Shoulder screw ISO 7379-12-M10-25
DIN 912 M5 x 20 --- 20N x 4
DIN 912 M6 x 16 --- 16N x 6
DIN 912 M5 x 16 --- 16N x 10
ISO - 4032 - M5 - W - N x 20
DIN 912 M3 x 20 --- 20N x 6
ISO - 4032 - M3 - W - N x 6
DIN EN ISO 7040 - M10 - N
