obotx/diy-robot-kit/hardware/cad/solidworks/OBX-A009.SLDASM

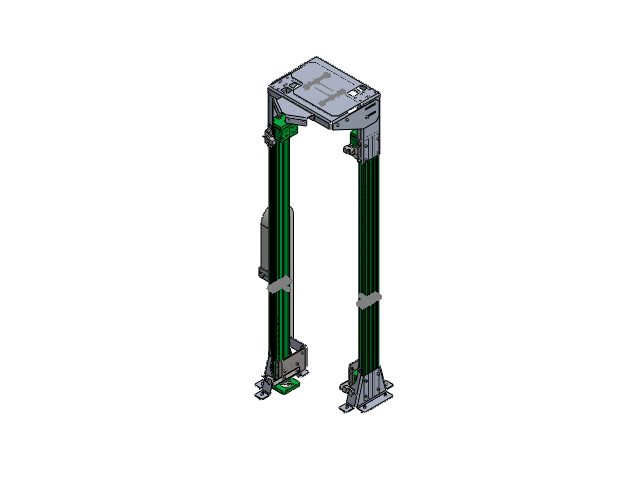
[picture p76: CAD file, 2026-11-09]
hardware/cad/solidworks/OBX-A009.SLDASM
OBX-P008 x 2
OBX-P019 x 2
CZUJNIK KRAŃCOWY x 4
KGX80-1000 x 2
OBX-P007 x 2
OBX-P004
OBX-P004M
OBX-P015 x 2
DIN 912 M5 x 12 --- 12N x 56
Square nut DIN 557 M5 -N x 30
ISO - 4032 - M5 - W - N x 22
DIN 912 M3 x 20 --- 20N x 8
ISO - 4032 - M3 - W - N x 8
DIN 912 M5 x 16 --- 16N x 16
Nakrętka wpustowa z kulką 8 M5 ITEM x 8
OBX-P033
OBX-P035
OBX-P037
OBX-P036
