obotx/diy-robot-kit/hardware/cad/solidworks/OBX-A011.SLDASM

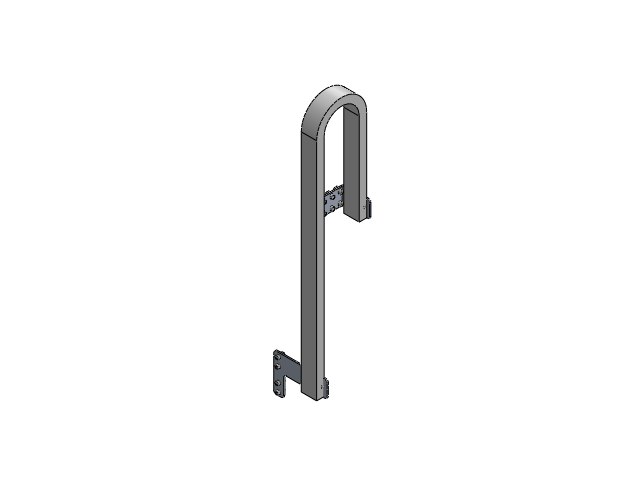
[picture p77: CAD file, 2026-11-09]
hardware/cad/solidworks/OBX-A011.SLDASM
OBX-P033
OBX-P035
Square nut DIN 557 M5 -N x 6
DIN 912 M5 x 12 --- 12N x 16
ISO - 4032 - M5 - W - N x 10
OBX-P037
