obotx/diy-robot-kit/hardware/cad/solidworks/OBX-A006.SLDASM

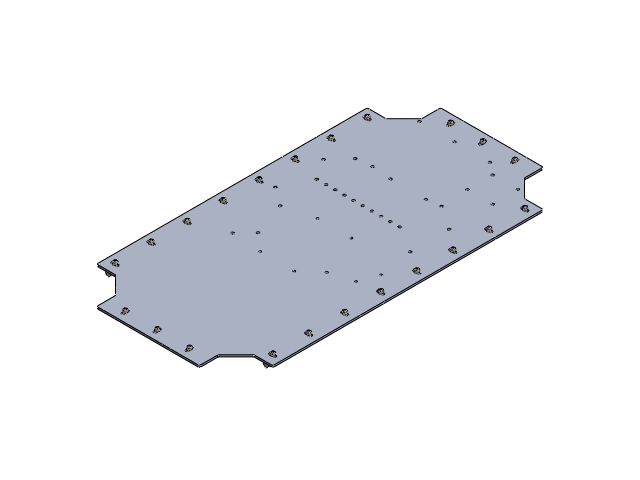
[picture p78: CAD file, 2026-11-09]
hardware/cad/solidworks/OBX-A006.SLDASM
OBX-P034
DIN 912 M5 x 16 --- 16N x 22
Nakrętka wpustowa z kulką 8 M5 ITEM x 22
