obotx/diy-robot-kit/hardware/cad/solidworks/OBX-A001.SLDASM

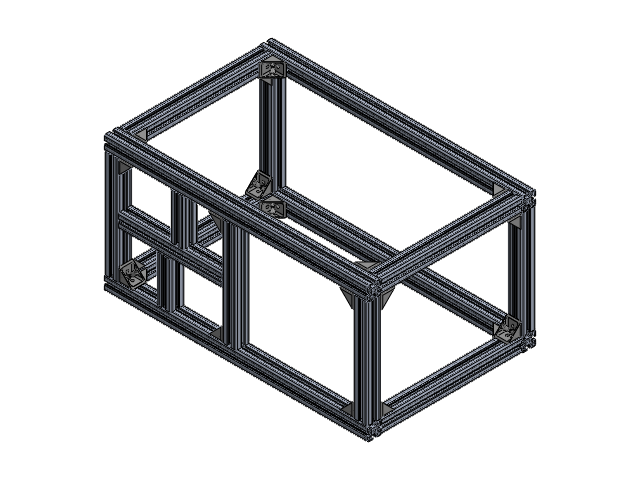
[picture p79: CAD file, 2026-11-09]
hardware/cad/solidworks/OBX-A001.SLDASM
OBX-P001 x 5
OBX-P002 x 4
FI3K4040 x 22
OBX-P013
OBX-P014 x 2
OBX-P021 x 4
