obotx/diy-robot-kit/hardware/cad/solidworks/OBX-A005.SLDASM

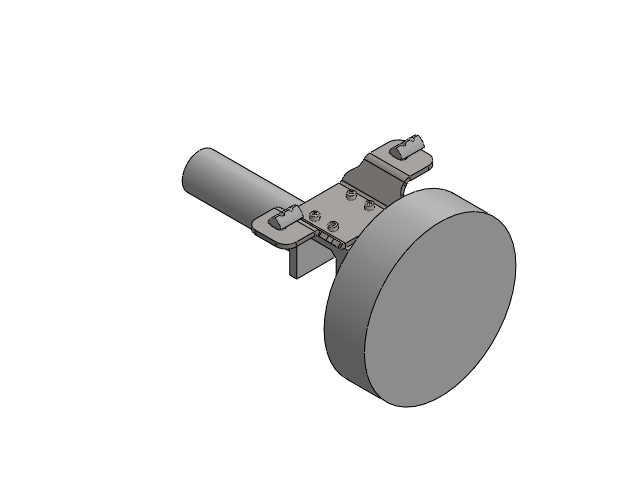
[picture p80: CAD file, 2026-11-09]
hardware/cad/solidworks/OBX-A005.SLDASM
OMNI WHEEL + MOTOR
OBX-P025
DIN 912 M5 x 12 --- 12N x 2
Nakrętka wpustowa z kulką 8 M5 ITEM x 2
DIN 912 M4 x 16 --- 16N x 4
ISO - 4032 - M4 - W - N x 4
