obotx/diy-robot-kit/hardware/cad/solidworks/OBX-A004.SLDASM

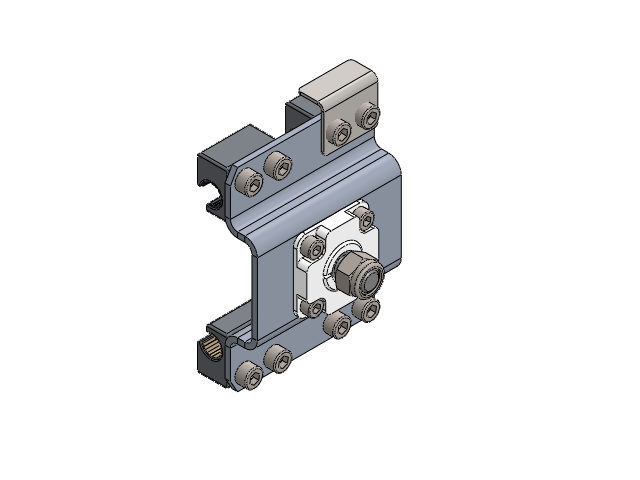
[picture p81: CAD file, 2026-11-09]
hardware/cad/solidworks/OBX-A004.SLDASM
OBX-P006
OBX-P022
IGUS WJ200UM_01_10 x 2
IGGUS WJ200UM_01_10_LL x 2
DIN 912 M5 x 20 --- 20N x 4
DIN EN ISO 7040 - M5 - N x 4
DIN 912 M6 x 16 --- 16N x 8
OBX-P023
TULEJA B-12-15-12-18-1,5
OBX-P016
Shoulder screw ISO 7379-12-M10-25
DIN EN ISO 7040 - M10 - N
