obotx/diy-robot-kit/(list of files, cad)

Other CAD files:
hardware/cad/step/parts/OBX-P006_7075-O (SS)_3mm_szt_REV.STEP
hardware/cad/step/parts/OBX-P033_6063-T1_3mm_szt_REV.STEP
hardware/cad/solidworks/OBX-P004M.SLDPRT
hardware/cad/solidworks/OBX-P025.SLDPRT
hardware/cad/step/parts/OBX-P023_ABS_1.5mm_szt_REV.STEP
hardware/cad/solidworks/OBX-P005.SLDPRT
hardware/cad/step/parts/OBX-P004_Stal węglowa_3mm_szt_REV.STEP
hardware/cad/solidworks/OBX-P009.SLDPRT
hardware/cad/step/parts/OBX-P034_Stop 6061_4mm_szt_REV.STEP
hardware/cad/solidworks/OBX-P007.SLDPRT
hardware/cad/solidworks/OBX-P022.SLDPRT
hardware/cad/step/parts/OBX-P028_Stal węglowa_3mm_szt_REV.STEP
hardware/cad/solidworks/OBX-P008.SLDPRT
hardware/cad/solidworks/OBX-P031.SLDPRT
hardware/cad/solidworks/OBX-P004.SLDPRT
hardware/cad/solidworks/(57)60______.SLDPRT
hardware/cad/solidworks/OBX-P010.SLDPRT
hardware/cad/solidworks/OBX-P035.SLDPRT
hardware/cad/solidworks/OBX-P032.SLDPRT
hardware/cad/solidworks/OBX-P038.SLDPRT
hardware/cad/solidworks/OBX-P036.SLDPRT
hardware/cad/solidworks/OBX-P017.SLDPRT
hardware/cad/solidworks/OBX-P015.SLDPRT
hardware/cad/solidworks/OBX-P016.SLDPRT
hardware/cad/solidworks/OBX-P029.SLDPRT
hardware/cad/solidworks/60________.SLDPRT
hardware/cad/solidworks/OBX-A000.SLDDRW
hardware/cad/solidworks/OBX-A001.SLDDRW
hardware/cad/solidworks/OBX-A002.SLDDRW
hardware/cad/solidworks/OBX-A003.SLDDRW
hardware/cad/solidworks/OBX-A004.SLDDRW
hardware/cad/solidworks/OBX-A005.SLDDRW
hardware/cad/solidworks/OBX-A006.SLDDRW
hardware/cad/solidworks/OBX-A007.SLDDRW
hardware/cad/solidworks/OBX-A008.SLDDRW
hardware/cad/solidworks/OBX-A009.SLDDRW
hardware/cad/solidworks/OBX-A010.SLDDRW
hardware/cad/solidworks/OBX-A011.SLDDRW
hardware/cad/solidworks/OBX-A012.SLDDRW
hardware/cad/solidworks/OBX-P004.SLDDRW
hardware/cad/solidworks/OBX-P005.SLDDRW
hardware/cad/solidworks/OBX-P006.SLDDRW
hardware/cad/solidworks/OBX-P007.SLDDRW
hardware/cad/solidworks/OBX-P008.SLDDRW
hardware/cad/solidworks/OBX-P009.SLDDRW
hardware/cad/solidworks/OBX-P010.SLDDRW
hardware/cad/solidworks/OBX-P015.SLDDRW
hardware/cad/solidworks/OBX-P016.SLDDRW
hardware/cad/solidworks/OBX-P017.SLDDRW
hardware/cad/solidworks/OBX-P018.SLDDRW
hardware/cad/solidworks/OBX-P019.SLDDRW
hardware/cad/solidworks/OBX-P022.SLDDRW
hardware/cad/solidworks/OBX-P023.SLDDRW
hardware/cad/solidworks/OBX-P025.SLDDRW
hardware/cad/solidworks/OBX-P027.SLDDRW
hardware/cad/solidworks/OBX-P028.SLDDRW
hardware/cad/solidworks/OBX-P029.SLDDRW
hardware/cad/solidworks/OBX-P030.SLDDRW
hardware/cad/solidworks/OBX-P030.SLDPRT
hardware/cad/solidworks/OBX-P031.SLDDRW
hardware/cad/solidworks/OBX-P032.SLDDRW
hardware/cad/solidworks/OBX-P033.SLDDRW
hardware/cad/solidworks/OBX-P034.SLDDRW
hardware/cad/solidworks/OBX-P035.SLDDRW
hardware/cad/solidworks/OBX-P036.SLDDRW
hardware/cad/solidworks/OBX-P038.SLDDRW
hardware/cad/solidworks/Shoulder screw ISO 7379-12-M10-25.sldprt
hardware/cad/solidworks/Shoulder screw ISO 7379-8-M6-55.stp
hardware/cad/solidworks/test.SLDDRW
