obotx/diy-robot-kit/hardware/wiring/ObotX_electrical_diagram.pdf

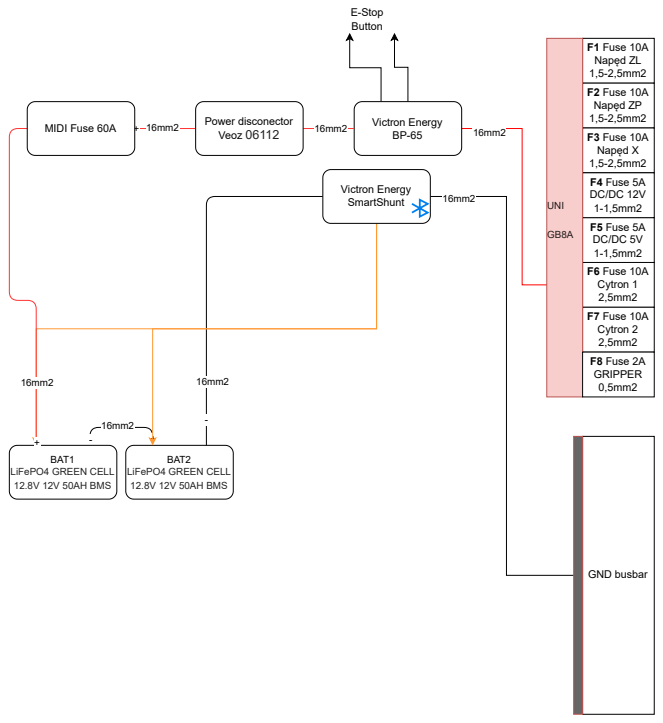
[picture p82: page 1]
BAT1 LiFePO4 GREEN CELL 12.8V 12V 50AH BMS; BAT2 LiFePO4 GREEN CELL 12.8V 12V 50AH BMS; Victron Energy BP-65; Victron Energy SmartShunt; MIDI Fuse 60A; F6 Fuse 10A Cytron 1 2,5mm2; F7 Fuse 10A Cytron 2 2,5mm2; F1 Fuse 10A Napęd ZL 1,5-2,5mm2; F2 Fuse 10A Napęd ZP 1,5-2,5mm2; F3 Fuse 10A Napęd X 1,5-2,5mm2; F5 Fuse 5A DC/DC 5V 1-1,5mm2; F4 Fuse 5A DC/DC 12V 1-1,5mm2; GND busbar; UNI; 16mm2 Power disconector Veoz 06112; E-Stop Button; F8 Fuse 2A GRIPPER 0,5mm2

STM32
NUCLEO-F446RE
1 | 2
3 | 4
5 | 6
7 | 8
9 | 10
11 | 12
13 | 14
15 | 16
17 | 18
19 | 20
21 | 22
23 | 24
25 | 26
27 | 28
29 | 30
31 | 32
33 | 34
35 | 36
37 | 38
1 | 2
3 | 4
5 | 6
7 | 8
9 | 10
11 | 12
13 | 14
15 | 16
17 | 18
19 | 20
21 | 22
23 | 24
25 | 26
27 | 28
29 | 30
31 | 32
33 | 34
35 | 36
37 | 38

USB

CN7 | CN10 ULN Z 3B | ULN Z 2B

ULN Z 4B

ULN Z 7B

ULN Z 6B

ULN Z 8B

ULN X 4B

ULN X 3B
ULN X 2B

PC817 X V2

PC817 X V1

PC817 X V3

PC817 X V4

PC817 Z V1

PC817 Z V2

PC817 Z V3

PC817 Z V4

PC817 Z V5

PC817 Z V6

PC817 Z V7

PC817 Z V8

+5v gnd

GC1 CW/CCW

GC1 CLK

GC1 ENABLE

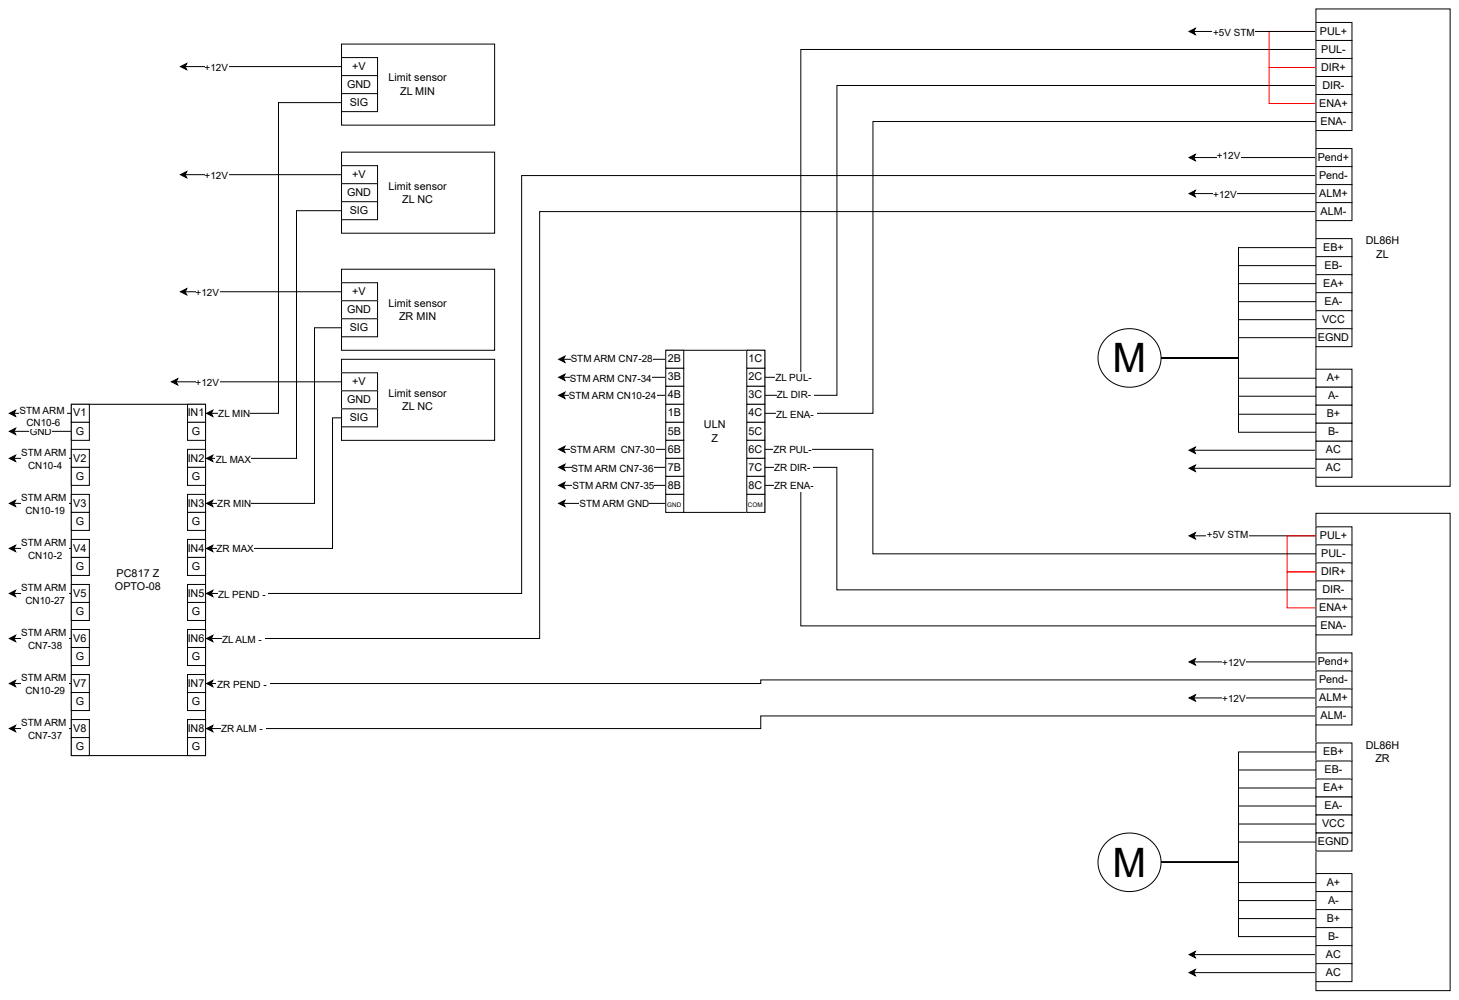
[picture p83: page 3]
ZL PUL-; ZL DIR-; +5V STM; PUL+; PUL- DIR+ DIR- ENA+ ENA-; Pend+; ZL PEND -; Pend- ALM+ ALM-; EB+ EB- EA+ EA- VCC EGND; PUL+ PUL- DIR+ DIR- ENA+ ENA-; Pend+ Pend- ALM+ ALM-; ULNZ; STM ARM CN7-28; STM ARM CN7-34; STM ARM CN10-24; STM ARM GND; GND; COM; STM ARM CN7-30; STM ARM CN7-36; STM ARM CN7-35; ZL ENA-; PC817 Z OPTO-08; STM ARM CN7-38; Limit sensor ZL MIN; GND SIG; Limit sensor ZL NC; +V GND SIG; Limit sensor ZR MIN; ZL MIN; ZL MAX; ZR MIN; ZR MAX; ZR PUL-; ZR DIR-; ZR ENA-; STM ARM CN10-6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

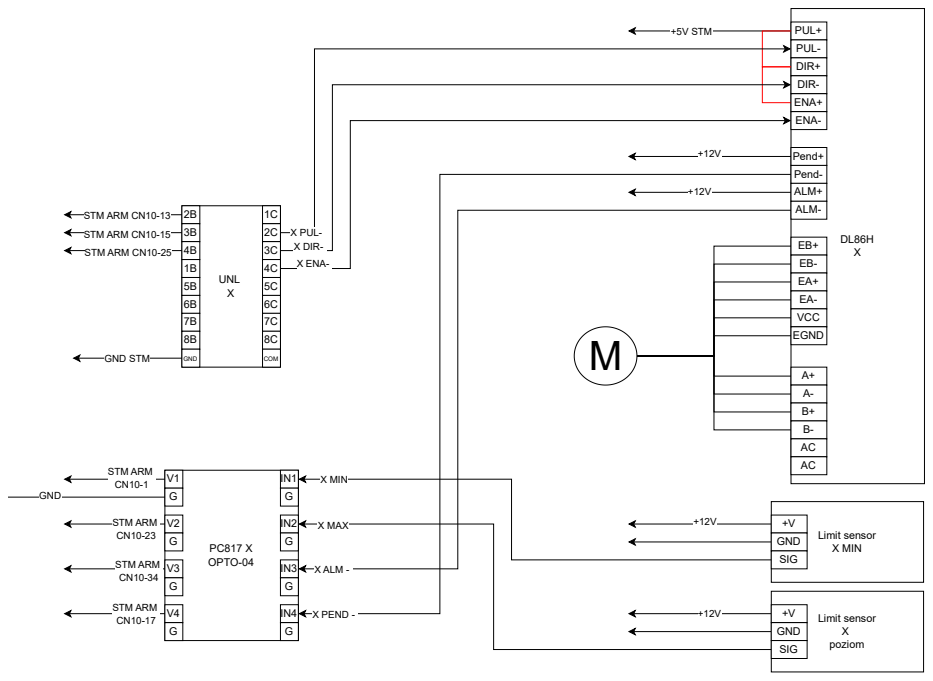
[picture p84: page 4]
+5V STM; PUL+; PUL-; DIR+; DIR-; ENA+; ENA-; Pend+; X PEND -; Pend-; ALM+; X ALM -; ALM-; VCC; EGND; UNLX; GND STM; GND; COM; PC817 X OPTO-04; STM ARM CN10-17; Limit sensor X MIN; Limit sensor X; poziom; SIG; X MIN; X MAX; X PUL- X DIR-; STM ARM CN10-13; STM ARM CN10-15; STM ARM CN10-25; X ENA-; STM ARM CN10-1; STM ARM CN10-23; STM ARM CN10-34

5B | 5C
6B | 6C
7B | 7C
8B | 8C

GND | G

GND
SIG

# MGREEN

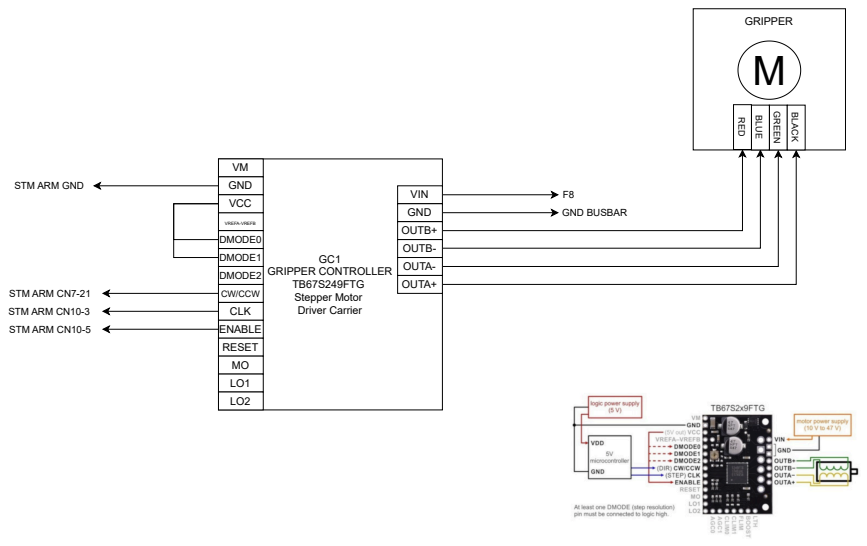
[picture p85: page 5]
GC1 GRIPPER CONTROLLER TB67S249FTG Stepper Motor Driver Carrier; VREFA-VREFB DMODE0; STM ARM CN10-3; CLK; STM ARM CN7-21; CW/CCW; VIN; GND; GND BUSBAR; OUTB+; OUTB-; OUTA-; OUTA+; STM ARM GND; VCC; DMODE1; DMODE2; STM ARM CN10-5; ENABLE; RESET; GRIPPER; RED; BLUE; BLACK

STM32
NUCLEO-F446RE
1 | 2
3 | 4
5 | 6
7 | 8
9 | 10
11 | 12
13 | 14
15 | 16
17 | 18
19 | 20
21 | 22
23 | 24
25 | 26
27 | 28
29 | 30
31 | 32 | 31 | 32
33 | 34 | 33 | 34
35 | 36 | 35 | 36
37 | 38 | 37 | 38
1 | 2
3 | 4
5 | 6
7 | 8
9 | 10
11 | 12
13 | 14
15 | 16
17 | 18
19 | 20
21 | 22
23 | 24
25 | 26
27 | 28
29 | 30

USB

CN7 | CN10 BC¹ PWM¹

BC1 PWM2

BC2 PWM1

BC2 PWM2

GND

BC2 DIR1

BC1 DIR2

BC1 DIR1

BC2 DIR2

M FL HALL

A
M FR HALL

A
M RL HALL

A

M RR HALL A

M FL HALL B

M FR HALL B
M RL HALL B

M RR HALL B

M

E

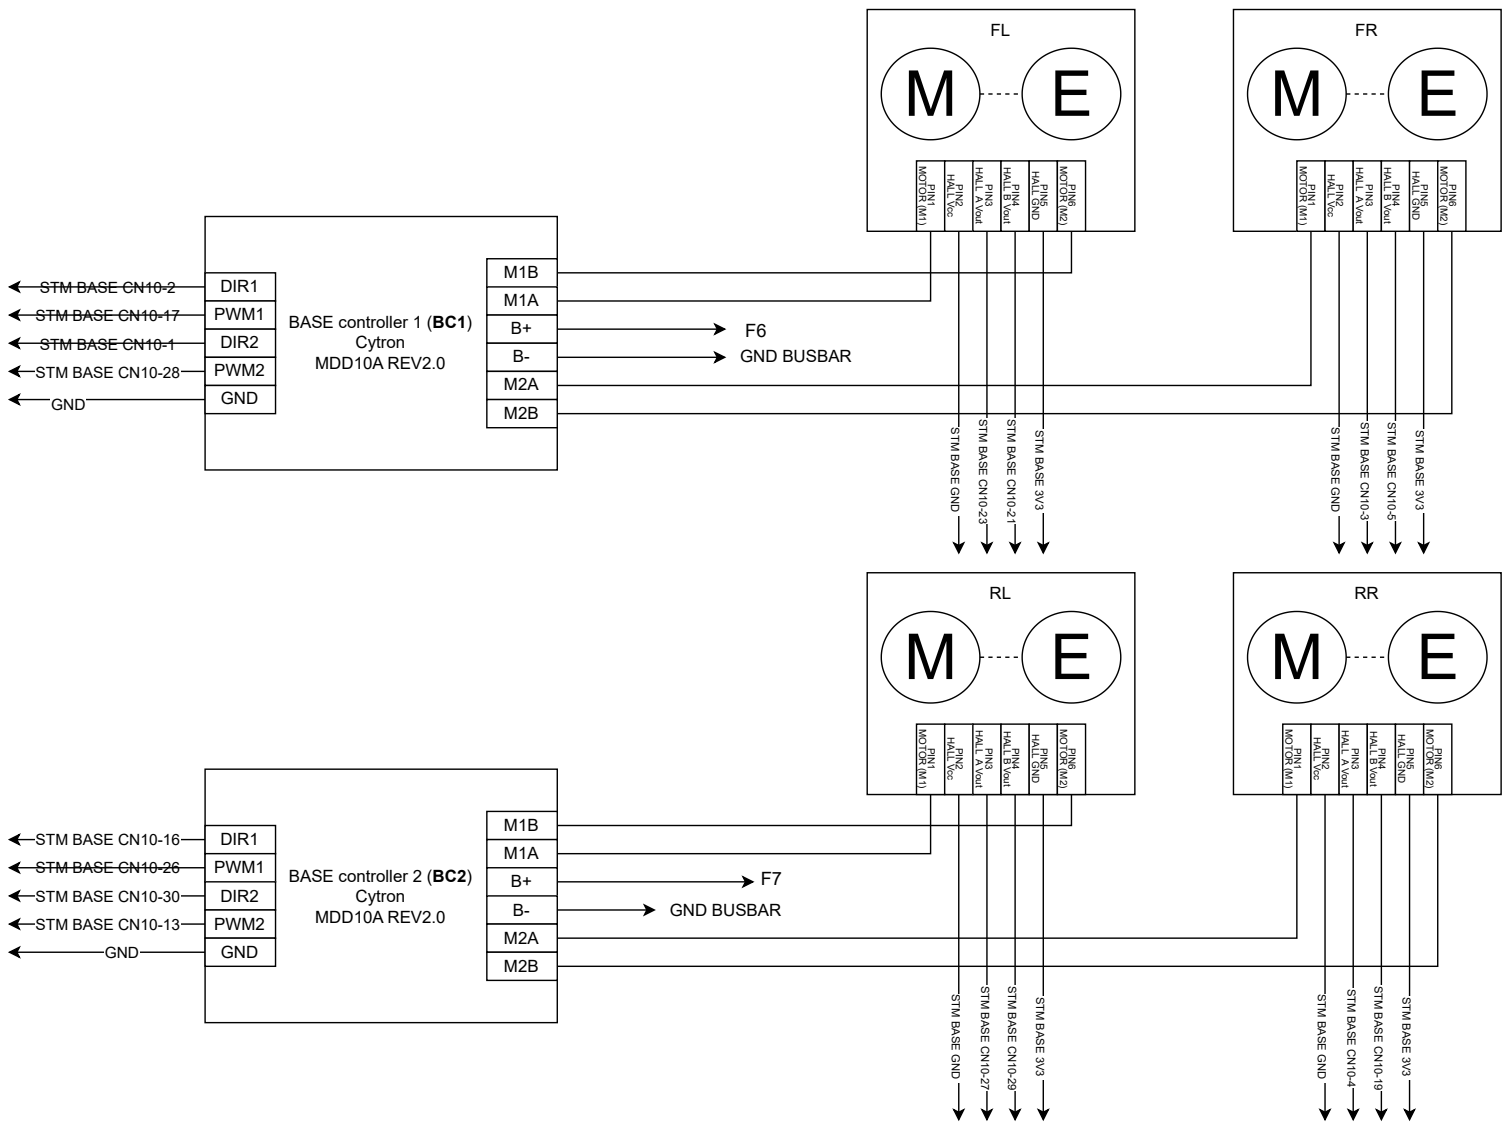
[picture p86: page 7]
PIN1; MOTOR (M1); STM BASE CN10-17; PIN2; HALL Vcc; PIN3; HALL A Vout; PIN4; HALL B Vout; PIN5; HALL GND; PIN6; MOTOR (M2); MOT; STM BASE CN10-26; STM BASE CN10-2; STM BASE CN10-1; STM BASE CN10-23; STM BASE CN10-3; STM BASE CN10-27; STM BASE CN10-4; STM BASE CN10-21; STM BASE CN10-5; STM BASE CN10-29; STM BASE CN10-19; STM BASE 3V3; BASE controller 1 (BC1; Cytron MDD10A REV2.0; DIR1; PWM1; DIR2; PWM2; GND; STM BASE CN10-28; GND BUSBAR; BASE controller 2 (BC2; STM BASE CN10-13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

STM BASE GND
