obotx/diy-robot-kit/hardware/drawings/assemblies/OBX-A000_REV.pdf

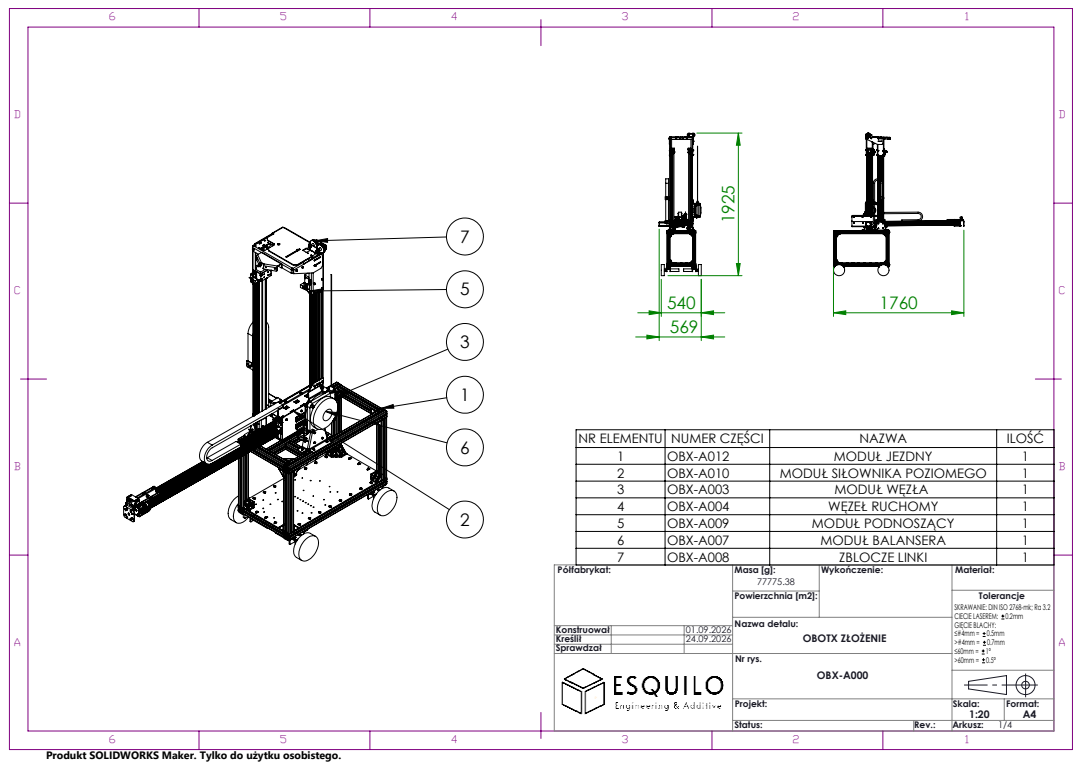
[picture p87: page 1]
OBOTX ZŁOŻENIE; Nazwa detalu: Konstruował

NR ELEMENTU | NUMER CZĘŚCI | NAZWA | ILOŚĆ
1 | OBX-A012 | MODUŁ JEZDNY | 1
2 | OBX-A010 | MODUŁ SIŁOWNIKA POZIOMEGO | 1
3 | OBX-A003 | MODUŁ WĘZŁA | 1
4 | OBX-A004 | WĘZEŁ RUCHOMY | 1
5 | OBX-A009 | MODUŁ PODNOSZĄCY | 1
6 | OBX-A007 | MODUŁ BALANSERA | 1
7 | OBX-A008 | ZBLOCZE LINKI | 1

Półfabrykat: | Masa [g]: 77775.38 | Wykończenie: | Materiał:

Powierzchnia [m2]: | | Tolerancje SKRAWANIE: DIN ISO 2768-mk; Ra 3.2 CIECIE LASEREM: 0.2mm GIĘCIE BLACHY: ≤#4mm = 0.5mm >#4mm = 0.7mm ≤60mm = 1° >60mm = 0.5°

Kreślił | | 24.09.2026
Sprawdzał

Nr rys. OBX-A000

Projekt: | Skala: 1:20 | Format: A4
Status: | Rev.: | Arkusz:

Produkt SOLIDWORKS Maker. Tylko do użytku osobistego.

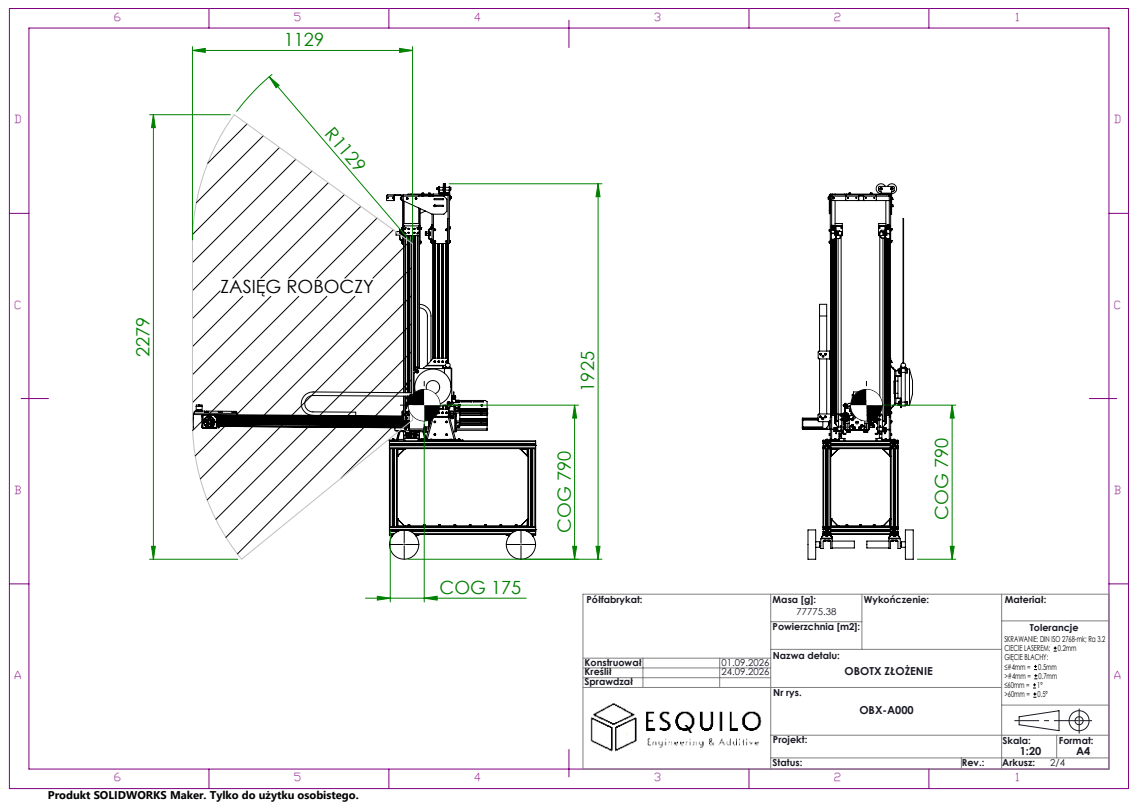
[picture p88: page 2]
COG 790; COG 175; ZASIĘG ROBOCZY; OBOTX ZŁOŻENIE; Konstruował; 01.09.2026 Nazwa detalu:

Półfabrykat: | Masa [g]: 77775.38 | Wykończenie: | Materiał:

Powierzchnia [m2]: | | Tolerancje SKRAWANIE: DIN ISO 2768-mk; Ra 3.2 CIECIE LASEREM: 0.2mm GIĘCIE BLACHY: ≤#4mm = 0.5mm >#4mm = 0.7mm ≤60mm = 1° >60mm = 0.5°

Sprawdzał

Nr rys. OBX-A000

Projekt: | Skala: | Format:

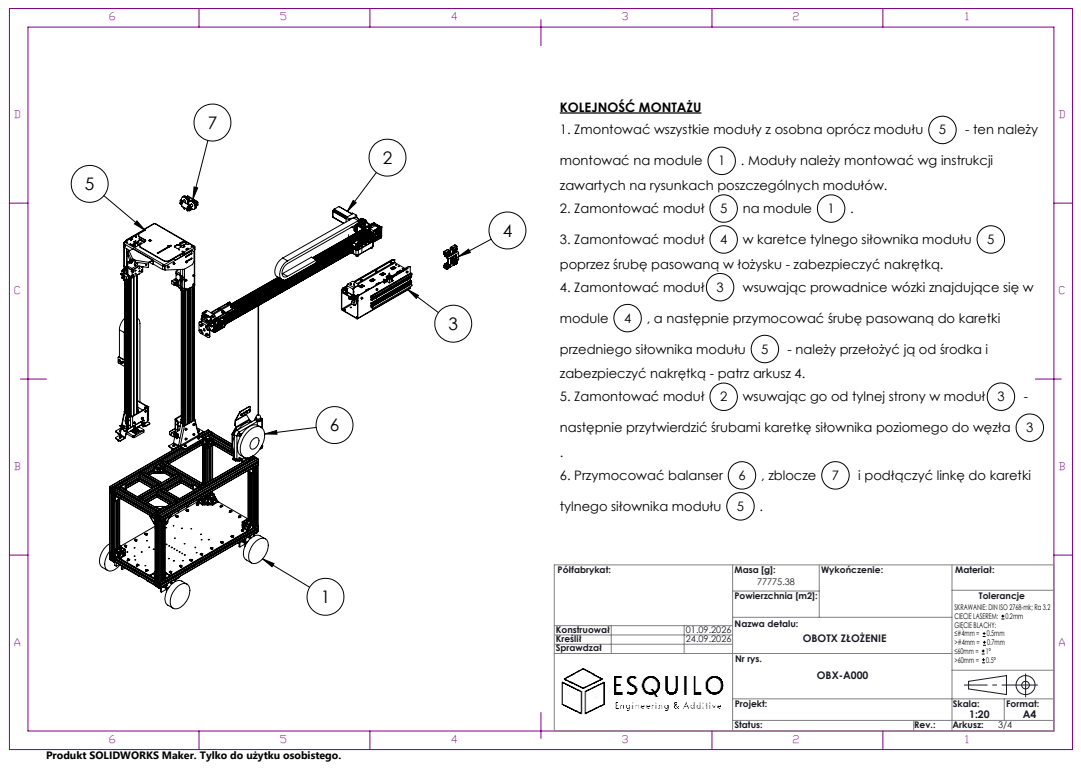
[picture p89: page 3]
OBOTX ZŁOŻENIE; Konstruował; 01.09.2026 Nazwa detalu:

KOLEJNOŚĆ MONTAŻU
1. Zmontować wszystkie moduły z osobna oprócz modułu 5 - ten należy
montować na module 1 . Moduły należy montować wg instrukcji
zawartych na rysunkach poszczególnych modułów.
2. Zamontować moduł 5 na module 1 .

3. Zamontować moduł 4 w karetce tylnego siłownika modułu 5
poprzez śrubę pasowaną w łożysku - zabezpieczyć nakrętką.
4. Zamontować moduł 3 wsuwając prowadnice wózki znajdujące się w
module 4 , a następnie przymocować śrubę pasowaną do karetki
przedniego siłownika modułu 5 - należy przełożyć ją od środka i
zabezpieczyć nakrętką - patrz arkusz 4.
5. Zamontować moduł 2 wsuwając go od tylnej strony w moduł 3 -
następnie przytwierdzić śrubami karetkę siłownika poziomego do węzła 3
6. Przymocować balanser 6 , zblocze 7 i podłączyć linkę do karetki
tylnego siłownika modułu 5 .

Półfabrykat: | Masa [g]: 77775.38 | Wykończenie: | Materiał:

Powierzchnia [m2]: | | Tolerancje SKRAWANIE: DIN ISO 2768-mk; Ra 3.2 CIECIE LASEREM: 0.2mm GIĘCIE BLACHY: ≤#4mm = 0.5mm >#4mm = 0.7mm ≤60mm = 1° >60mm = 0.5°

Sprawdzał

Nr rys. OBX-A000

Projekt: | Skala: | Format:

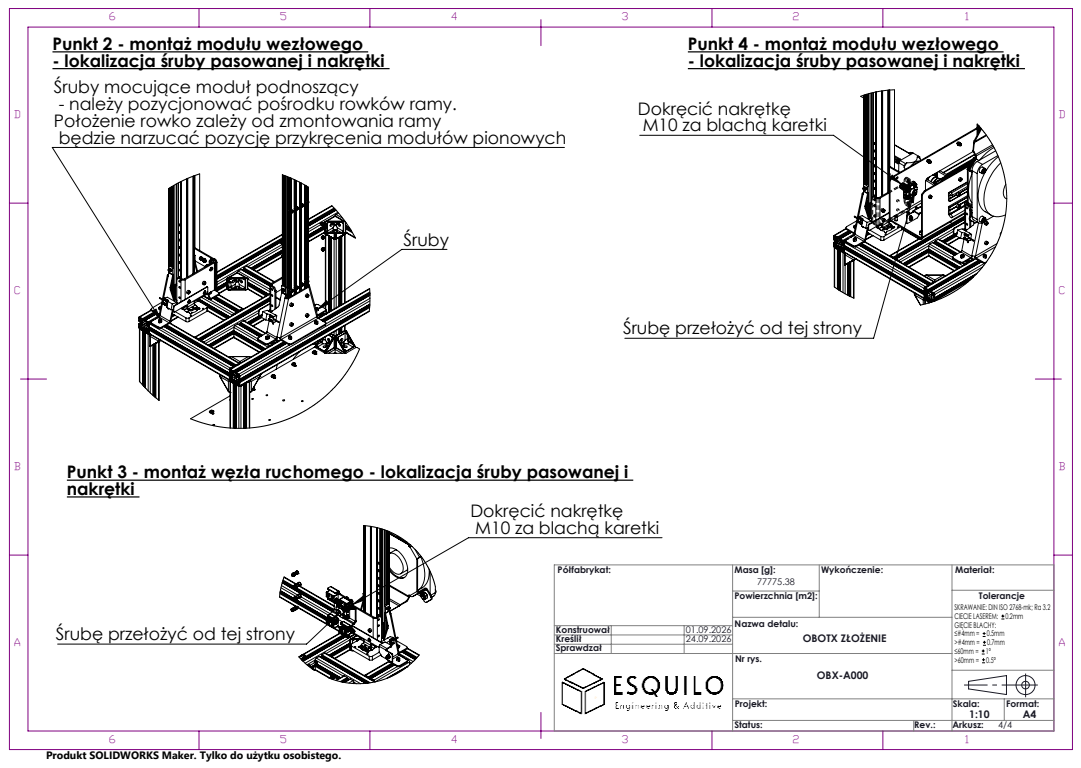
[picture p90: page 4]
- lokalizacja śruby pasowanej i nakrętki; Punkt 4 - montaż modułu wezłowego; OBOTX ZŁOŻENIE; Konstruował; 01.09.2026 Nazwa detalu:

Punkt 2 - montaż modułu wezłowego
Śruby mocujące moduł podnoszący
- należy pozycjonować pośrodku rowków ramy.
Położenie rowko zależy od zmontowania ramy
będzie narzucać pozycję przykręcenia modułów pionowych

- lokalizacja śruby pasowanej i nakrętki

Dokręcić nakrętkę
M10 za blachą karetki

Śrubę przełożyć od tej strony

Punkt 3 - montaż węzła ruchomego - lokalizacja śruby pasowanej i
nakrętki

Półfabrykat: | Masa [g]: 77775.38 | Wykończenie: | Materiał:

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

Sprawdzał

Nr rys. OBX-A000

Projekt: | Skala: 1:10 | Format:
