obotx/diy-robot-kit/hardware/drawings/assemblies/OBX-A003_REV.pdf

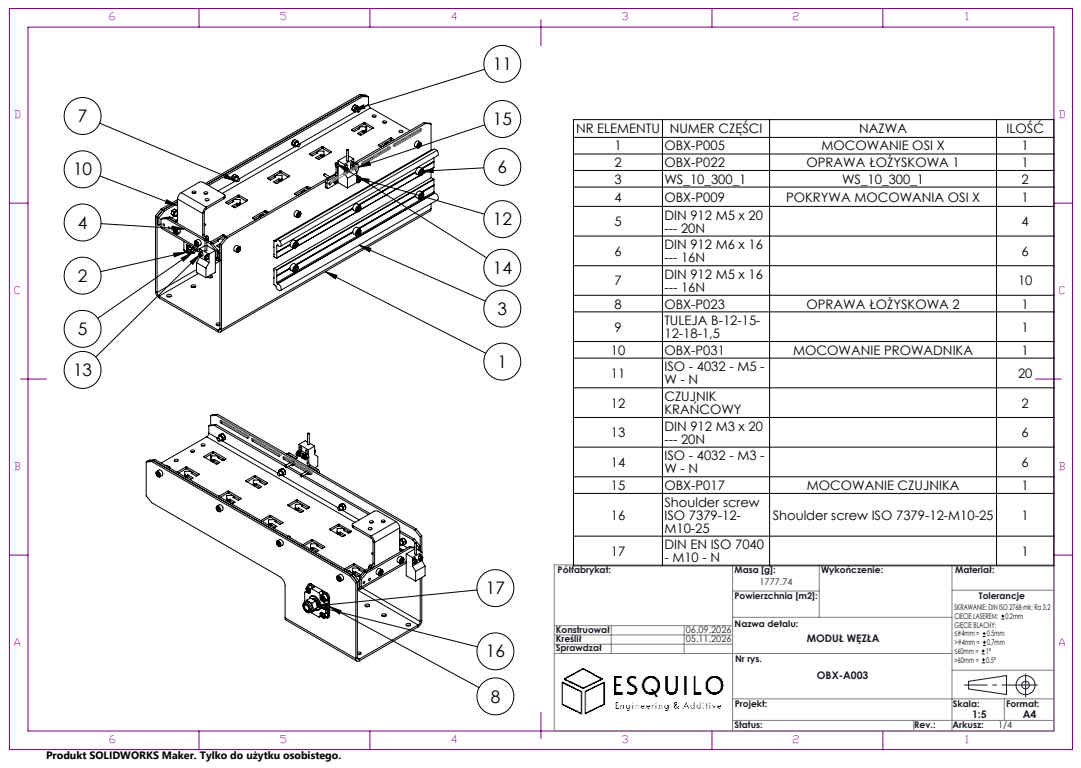
[picture p91: page 1]
MODUŁ WĘZŁA; SKRAWANIE: DIN ISO 2768-mk; Ra 3.2 CIECIE LASEREM: 0.2mm GIĘCIE BLACHY: ≤#4mm = 0.5mm >#4mm = 0.7mm ≤60mm = 1° >60mm = 0.5°; Półfabrykat:; Masa [g]:; Wykończenie:; Materiał:; Nazwa detalu: Konstruował; Powierzchnia [m2]:

NR ELEMENTU | NUMER CZĘŚCI | NAZWA | ILOŚĆ
1 | OBX-P005 | MOCOWANIE OSI X | 1
2 | OBX-P022 | OPRAWA ŁOŻYSKOWA 1 | 1
3 | WS_10_300_1 | WS_10_300_1 | 2
4 | OBX-P009 | POKRYWA MOCOWANIA OSI X | 1
5 | DIN 912 M5 x 20 --- 20N | | 4
6 | DIN 912 M6 x 16 --- 16N | | 6
7 | DIN 912 M5 x 16 --- 16N | | 10
8 | OBX-P023 | OPRAWA ŁOŻYSKOWA 2 | 1
9 | TULEJA B-12-15-12-18-1,5 | | 1
10 | OBX-P031 | MOCOWANIE PROWADNIKA | 1
11 | ISO - 4032 - M5 -W - N | | 20
12 | CZUJNIK KRAŃCOWY | | 2
13 | DIN 912 M3 x 20 --- 20N | | 6
14 | ISO - 4032 - M3 -W - N | | 6
15 | OBX-P017 | MOCOWANIE CZUJNIKA | 1
16 | Shoulder screw ISO 7379-12-M10-25 | Shoulder screw ISO 7379-12-M10-25 | 1

17 | DIN EN ISO 7040 - M10 - N | | 1

Kreślił | | 05.11.2026
Sprawdzał

Nr rys. OBX-A003

Projekt: | Skala: 1:5 | Format: A4
Status: | Rev.: | Arkusz:

Produkt SOLIDWORKS Maker. Tylko do użytku osobistego.

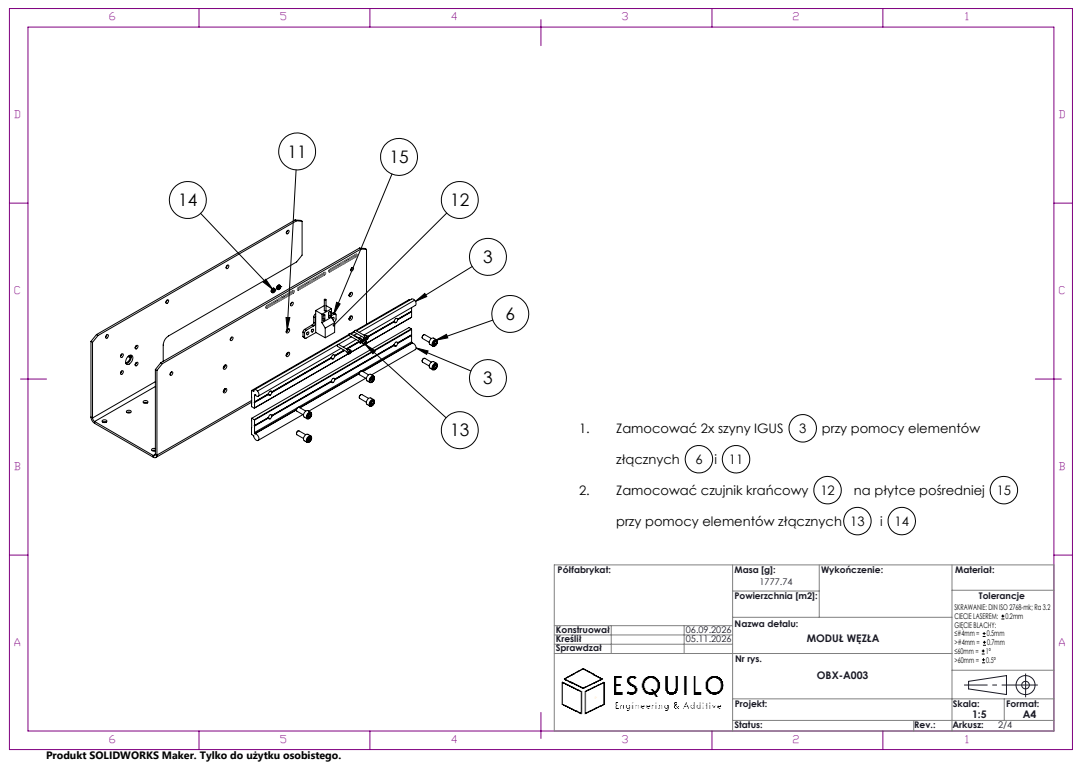
[picture p92: page 2]
MODUŁ WĘZŁA; Konstruował; 06.09.2026 Nazwa detalu:

1. Zamocować 2x szyny IGUS 3 przy pomocy elementów
złącznych 6 i 11
2. Zamocować czujnik krańcowy 12 na płytce pośredniej 15
przy pomocy elementów złącznych 13 i 14

Półfabrykat: | Masa [g]: 1777.74 | Wykończenie: | Materiał:

Powierzchnia [m2]: | | Tolerancje SKRAWANIE: DIN ISO 2768-mk; Ra 3.2 CIECIE LASEREM: 0.2mm GIĘCIE BLACHY: ≤#4mm = 0.5mm >#4mm = 0.7mm ≤60mm = 1° >60mm = 0.5°

Sprawdzał

Nr rys. OBX-A003

Projekt: | Skala: | Format:

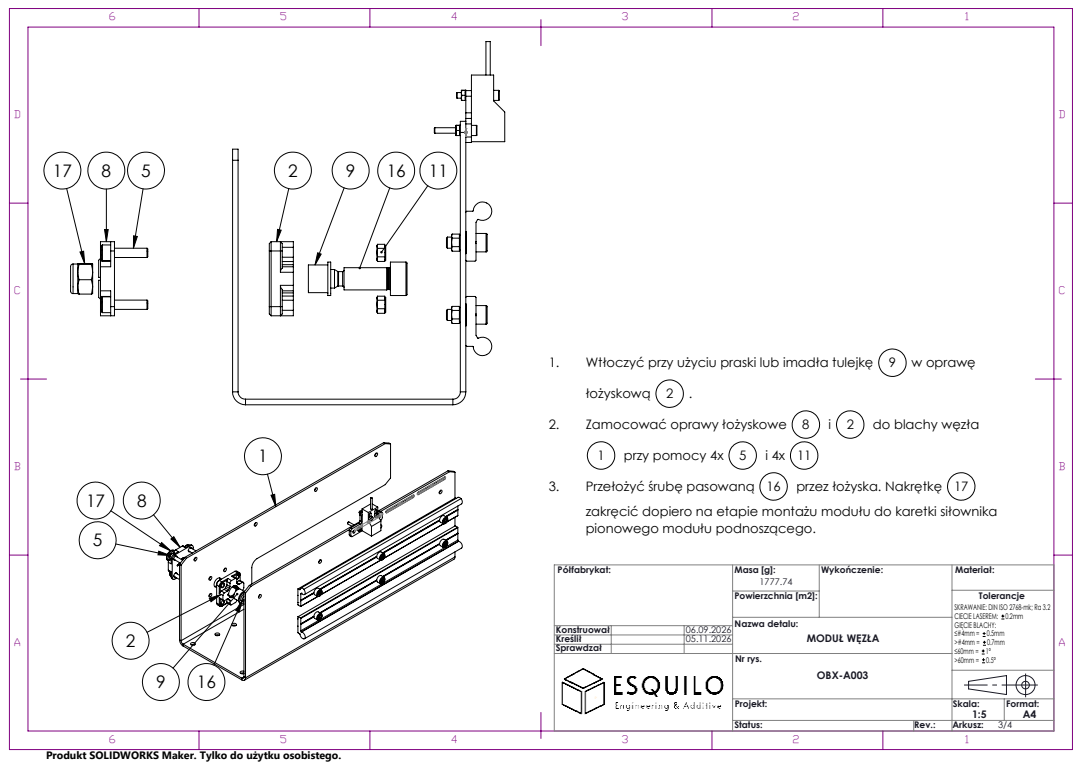
[picture p93: page 3]
MODUŁ WĘZŁA; Konstruował; 06.09.2026 Nazwa detalu:

1. Wtłoczyć przy użyciu praski lub imadła tulejkę 9 w oprawę
łożyskową 2 .
2. Zamocować oprawy łożyskowe 8 i 2 do blachy węzła
1 przy pomocy 4x 5 i 4x 11
3. Przełożyć śrubę pasowaną 16 przez łożyska. Nakrętkę 17
zakręcić dopiero na etapie montażu modułu do karetki siłownika
pionowego modułu podnoszącego.

Półfabrykat: | Masa [g]: 1777.74 | Wykończenie: | Materiał:

Powierzchnia [m2]: | | Tolerancje SKRAWANIE: DIN ISO 2768-mk; Ra 3.2 CIECIE LASEREM: 0.2mm GIĘCIE BLACHY: ≤#4mm = 0.5mm >#4mm = 0.7mm ≤60mm = 1° >60mm = 0.5°

Sprawdzał

Nr rys. OBX-A003

Projekt: | Skala: | Format:

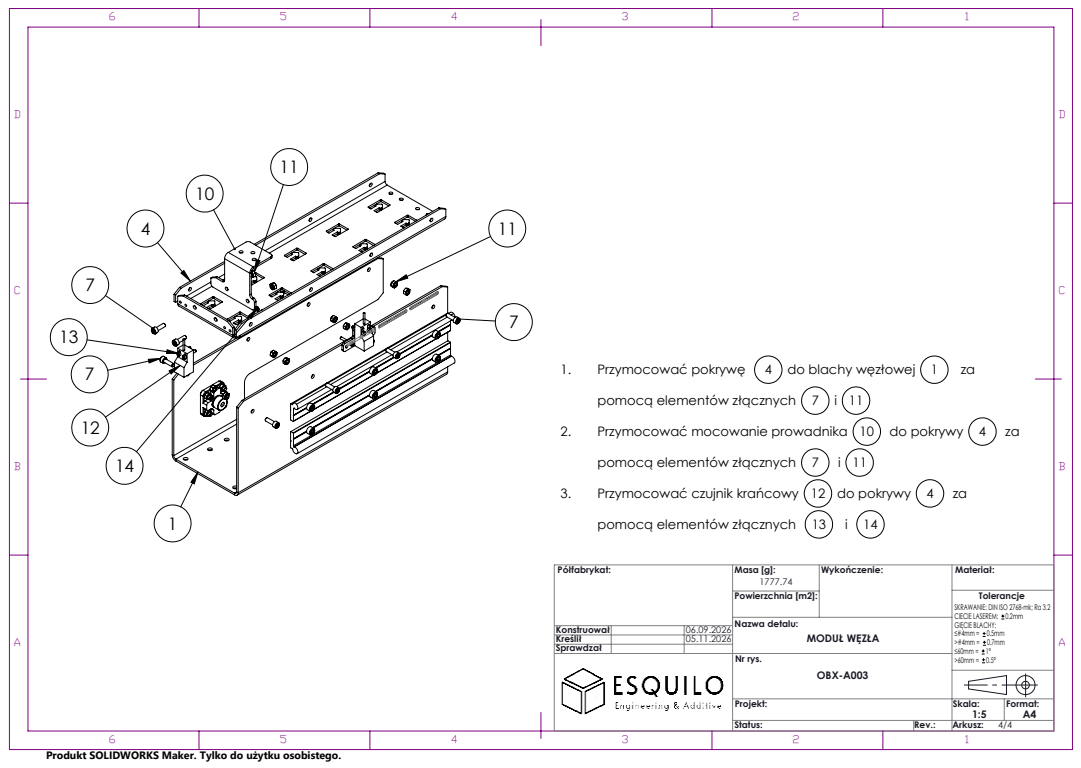
[picture p94: page 4]
Przymocować pokrywę 4 do blachy węzłowej 1; MODUŁ WĘZŁA; Konstruował; 06.09.2026 Nazwa detalu:

pomocą elementów złącznych 7 i 11
2. Przymocować mocowanie prowadnika 10 do pokrywy 4 za
3. Przymocować czujnik krańcowy 12 do pokrywy 4 za
pomocą elementów złącznych 13 i 14

Półfabrykat: | Masa [g]: 1777.74 | Wykończenie: | Materiał:

Powierzchnia [m2]: | | Tolerancje SKRAWANIE: DIN ISO 2768-mk; Ra 3.2 CIECIE LASEREM: 0.2mm GIĘCIE BLACHY: ≤#4mm = 0.5mm >#4mm = 0.7mm ≤60mm = 1° >60mm = 0.5°

Sprawdzał

Nr rys. OBX-A003

Projekt: | Skala: | Format:
