obotx/diy-robot-kit/hardware/drawings/assemblies/OBX-A009_REV.pdf

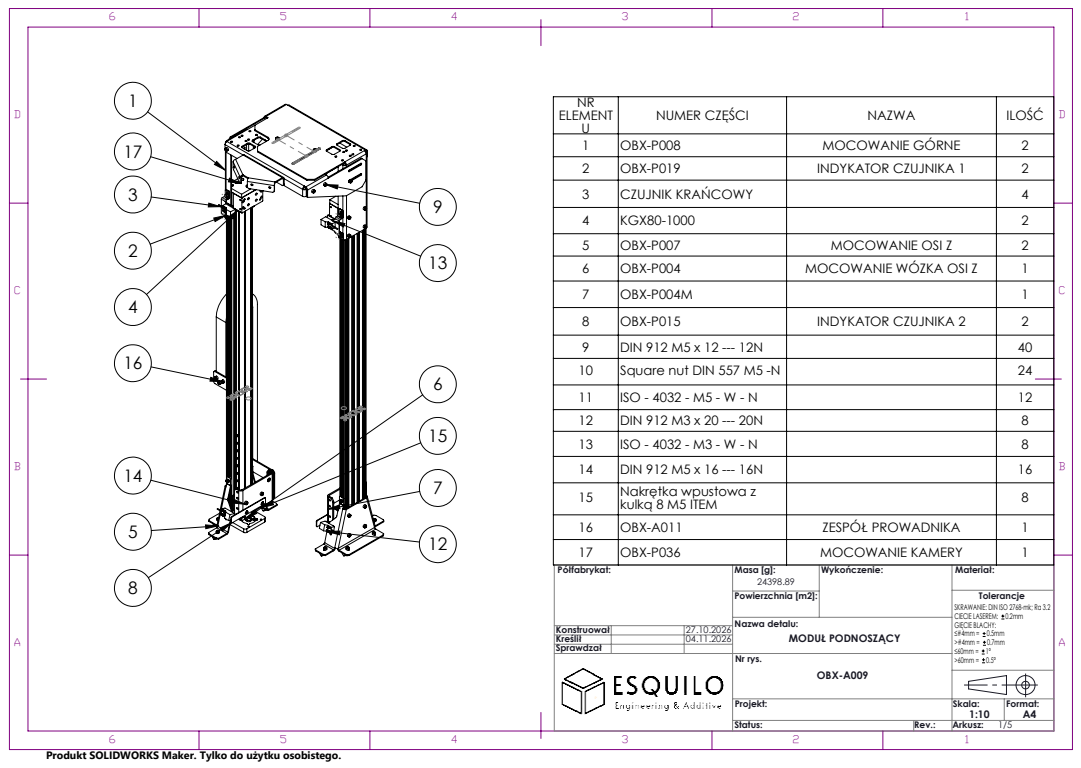
[picture p95: page 1]
MODUŁ PODNOSZĄCY; Nazwa detalu: Konstruował

ELEMENT U | NUMER CZĘŚCI | NAZWA | ILOŚĆ
1 | OBX-P008 | MOCOWANIE GÓRNE | 2
2 | OBX-P019 | INDYKATOR CZUJNIKA 1 | 2
3 | CZUJNIK KRAŃCOWY | | 4
4 | KGX80-1000 | | 2
5 | OBX-P007 | MOCOWANIE OSI Z | 2
6 | OBX-P004 | MOCOWANIE WÓZKA OSI Z | 1
7 | OBX-P004M | | 1
8 | OBX-P015 | INDYKATOR CZUJNIKA 2 | 2
9 | DIN 912 M5 x 12 --- 12N | | 40
10 | Square nut DIN 557 M5 -N | | 24
11 | ISO - 4032 - M5 - W - N | | 12
12 | DIN 912 M3 x 20 --- 20N | | 8
13 | ISO - 4032 - M3 - W - N | | 8
14 | DIN 912 M5 x 16 --- 16N | | 16
15 | Nakrętka wpustowa z kulką 8 M5 ITEM | | 8

16 | OBX-A011 | ZESPÓŁ PROWADNIKA | 1
17 | OBX-P036 | MOCOWANIE KAMERY | 1
Półfabrykat: | Masa [g]: 24398.89 | Wykończenie: | Materiał:

Powierzchnia [m2]: | | Tolerancje SKRAWANIE: DIN ISO 2768-mk; Ra 3.2 CIECIE LASEREM: 0.2mm GIĘCIE BLACHY: ≤#4mm = 0.5mm >#4mm = 0.7mm ≤60mm = 1° >60mm = 0.5°

Kreślił | | 04.11.2026
Sprawdzał

Nr rys. OBX-A009

Projekt: | Skala: 1:10 | Format: A4
Status: | Rev.: | Arkusz:

Produkt SOLIDWORKS Maker. Tylko do użytku osobistego.

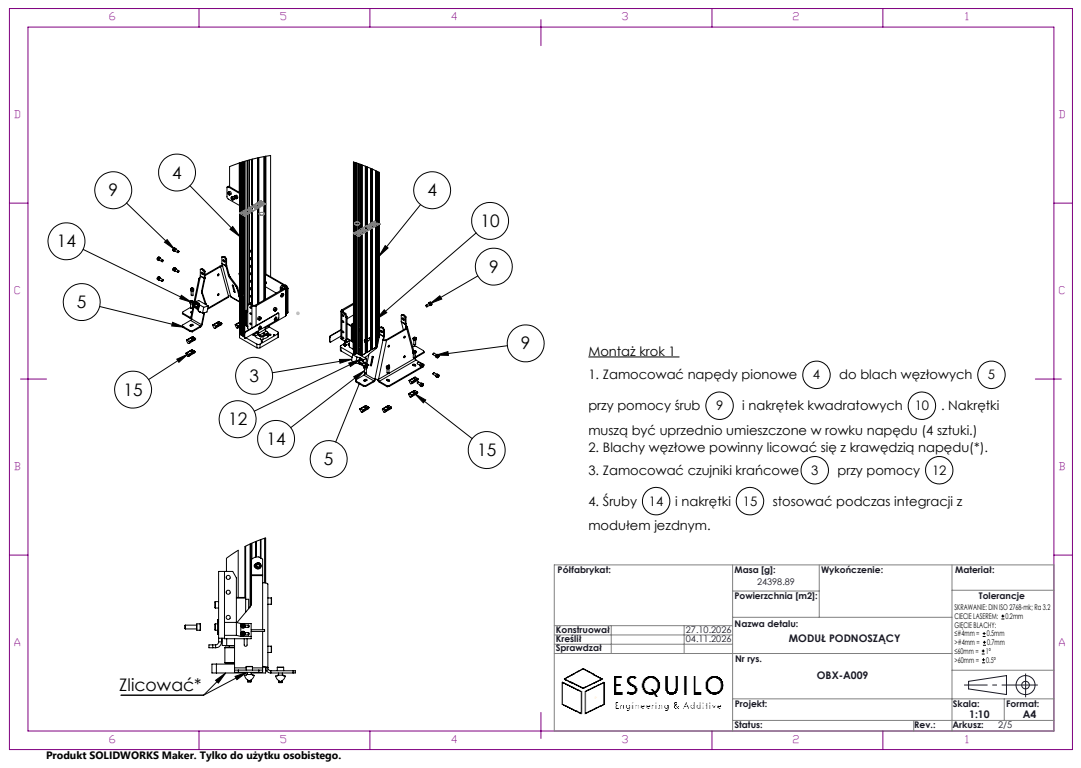
[picture p96: page 2]
MODUŁ PODNOSZĄCY; Konstruował; 27.10.2026 Nazwa detalu:

Montaż krok 1
1. Zamocować napędy pionowe 4 do blach węzłowych 5
przy pomocy śrub 9 i nakrętek kwadratowych 10 . Nakrętki
muszą być uprzednio umieszczone w rowku napędu (4 sztuki.)
2. Blachy węzłowe powinny licować się z krawędzią napędu(*).
3. Zamocować czujniki krańcowe 3 przy pomocy 12
4. Śruby 14 i nakrętki 15 stosować podczas integracji z
modułem jezdnym.

Półfabrykat: | Masa [g]: 24398.89 | Wykończenie: | Materiał:

Powierzchnia [m2]: | | Tolerancje SKRAWANIE: DIN ISO 2768-mk; Ra 3.2 CIECIE LASEREM: 0.2mm GIĘCIE BLACHY: ≤#4mm = 0.5mm >#4mm = 0.7mm ≤60mm = 1° >60mm = 0.5°

Sprawdzał

Nr rys. OBX-A009

Projekt: | Skala: | Format:

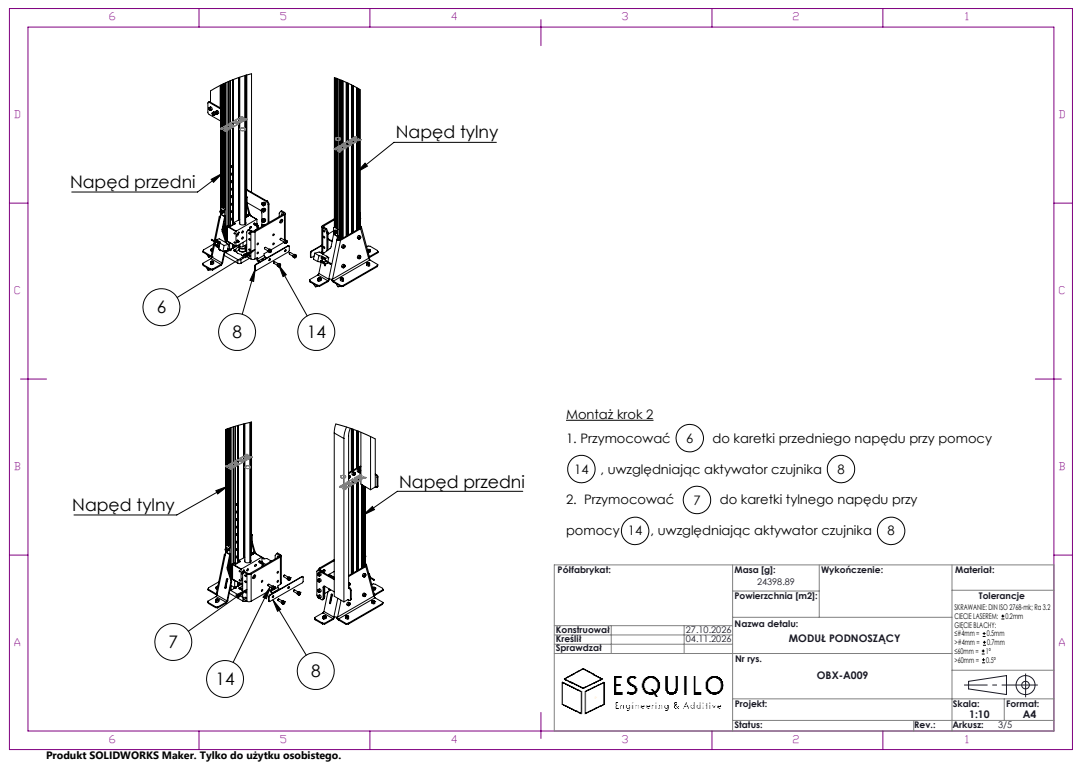
[picture p97: page 3]
Napęd przedni; Napęd tylny; MODUŁ PODNOSZĄCY; Konstruował; 27.10.2026 Nazwa detalu:

Montaż krok 2
1. Przymocować 6 do karetki przedniego napędu przy pomocy
14 , uwzględniając aktywator czujnika 8
2. Przymocować 7 do karetki tylnego napędu przy
pomocy 14 , uwzględniając aktywator czujnika 8

Półfabrykat: | Masa [g]: 24398.89 | Wykończenie: | Materiał:

Powierzchnia [m2]: | | Tolerancje SKRAWANIE: DIN ISO 2768-mk; Ra 3.2 CIECIE LASEREM: 0.2mm GIĘCIE BLACHY: ≤#4mm = 0.5mm >#4mm = 0.7mm ≤60mm = 1° >60mm = 0.5°

Sprawdzał

Nr rys. OBX-A009

Projekt: | Skala: | Format:

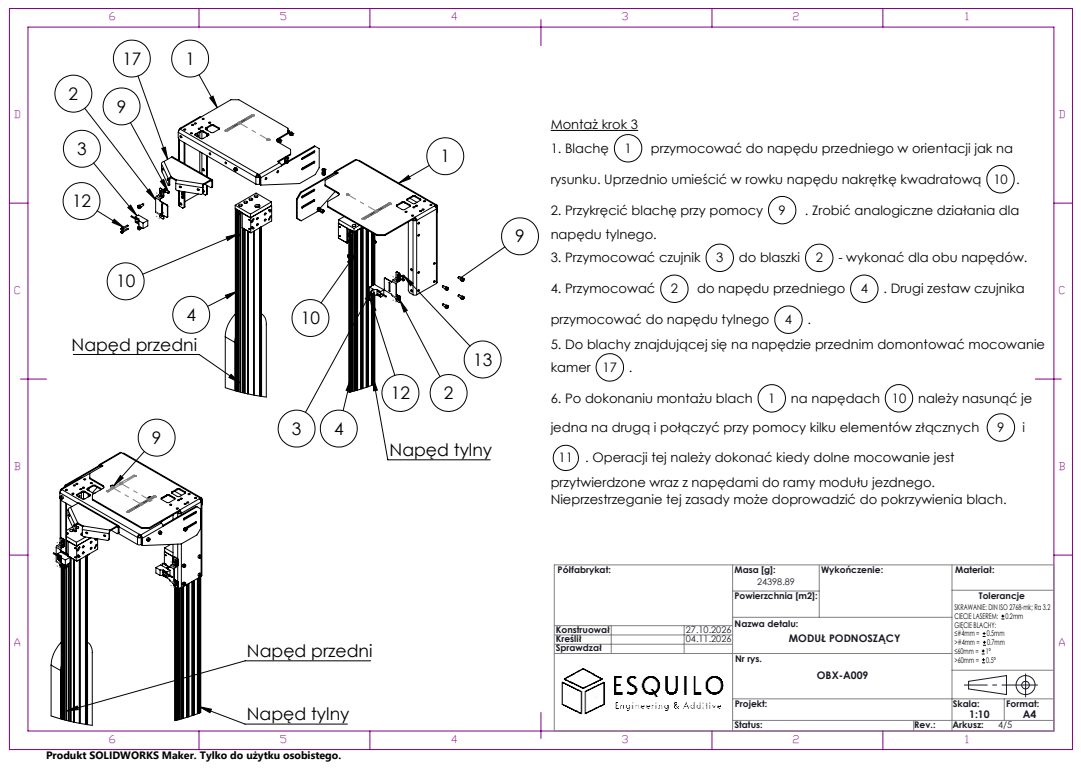
[picture p98: page 4]
Napęd przedni; Napęd tylny; MODUŁ PODNOSZĄCY; Konstruował; 27.10.2026 Nazwa detalu:

Montaż krok 3
1. Blachę 1 przymocować do napędu przedniego w orientacji jak na
rysunku. Uprzednio umieścić w rowku napędu nakrętkę kwadratową 10 .
2. Przykręcić blachę przy pomocy 9 . Zrobić analogiczne działania dla
napędu tylnego.
3. Przymocować czujnik 3 do blaszki 2 - wykonać dla obu napędów.
4. Przymocować 2 do napędu przedniego 4 . Drugi zestaw czujnika
przymocować do napędu tylnego 4 .
5. Do blachy znajdującej się na napędzie przednim domontować mocowanie
kamer 17 .
6. Po dokonaniu montażu blach 1 na napędach 10 należy nasunąć je
jedna na drugą i połączyć przy pomocy kilku elementów złącznych 9 i
11 . Operacji tej należy dokonać kiedy dolne mocowanie jest
przytwierdzone wraz z napędami do ramy modułu jezdnego.
Nieprzestrzeganie tej zasady może doprowadzić do pokrzywienia blach.

Półfabrykat: | Masa [g]: 24398.89 | Wykończenie: | Materiał:

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

Sprawdzał

Nr rys. OBX-A009

Projekt: | Skala: | Format:

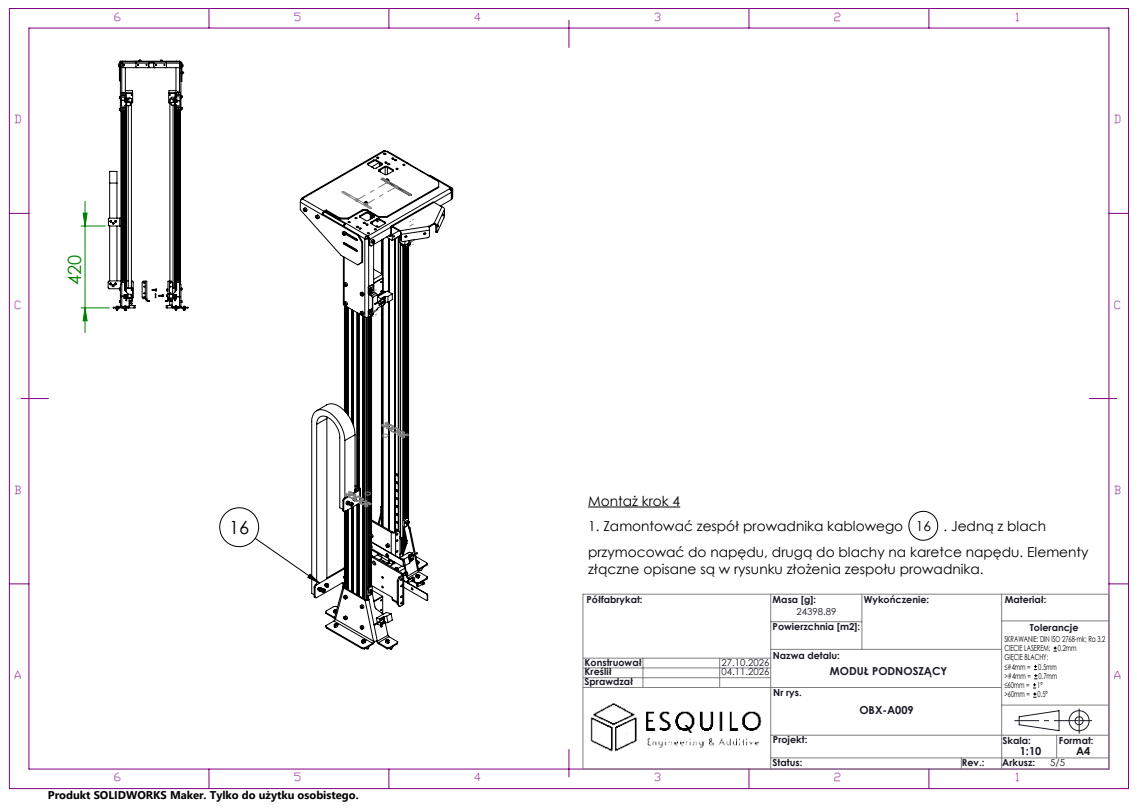
[picture p99: page 5]
MODUŁ PODNOSZĄCY; Konstruował; 27.10.2026 Nazwa detalu:

Montaż krok 4
1. Zamontować zespół prowadnika kablowego 16 . Jedną z blach
przymocować do napędu, drugą do blachy na karetce napędu. Elementy
złączne opisane są w rysunku złożenia zespołu prowadnika.

Półfabrykat: | Masa [g]: 24398.89 | Wykończenie: | Materiał:

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

Sprawdzał

Nr rys. OBX-A009

Projekt: | Skala: | Format:
