obotx/diy-robot-kit/hardware/drawings/assemblies/OBX-A001_REV.pdf

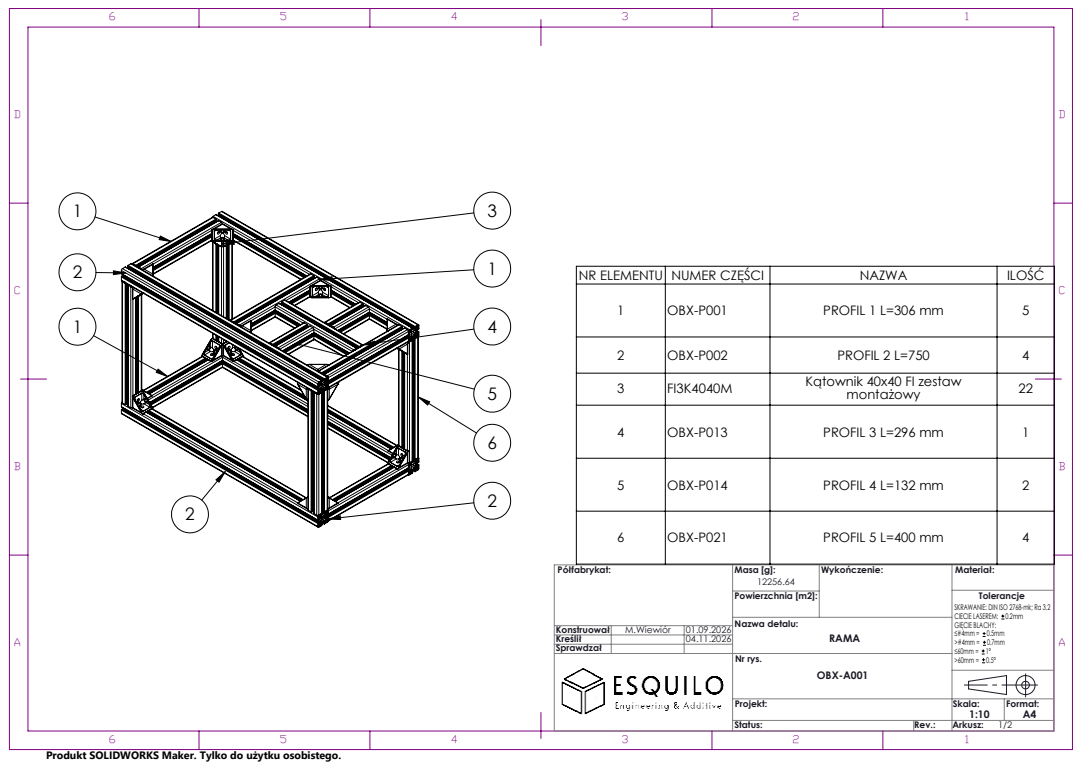
[picture p101: page 1]
NR ELEMENTU; NUMER CZĘŚCI; NAZWA; ILOŚĆ; Nazwa detalu: Konstruował

1 | OBX-P001 | PROFIL 1 L=306 mm | 5

2 | OBX-P002 | PROFIL 2 L=750 | 4
3 | FI3K4040M | Kątownik 40x40 FI zestaw montażowy | 22

4 | OBX-P013 | PROFIL 3 L=296 mm | 1

5 | OBX-P014 | PROFIL 4 L=132 mm | 2

6 | OBX-P021 | PROFIL 5 L=400 mm | 4

Półfabrykat: | Masa [g]: 12256.64 | Wykończenie: | Materiał:

Powierzchnia [m2]: | | Tolerancje SKRAWANIE: DIN ISO 2768-mk; Ra 3.2 CIECIE LASEREM: 0.2mm GIĘCIE BLACHY: ≤#4mm = 0.5mm >#4mm = 0.7mm ≤60mm = 1° >60mm = 0.5°

Kreślił | | 04.11.2026
Sprawdzał

M.Wiewiór

Nr rys. OBX-A001

Projekt: | Skala: 1:10 | Format: A4
Status: | Rev.: | Arkusz: 1/2

Produkt SOLIDWORKS Maker. Tylko do użytku osobistego.

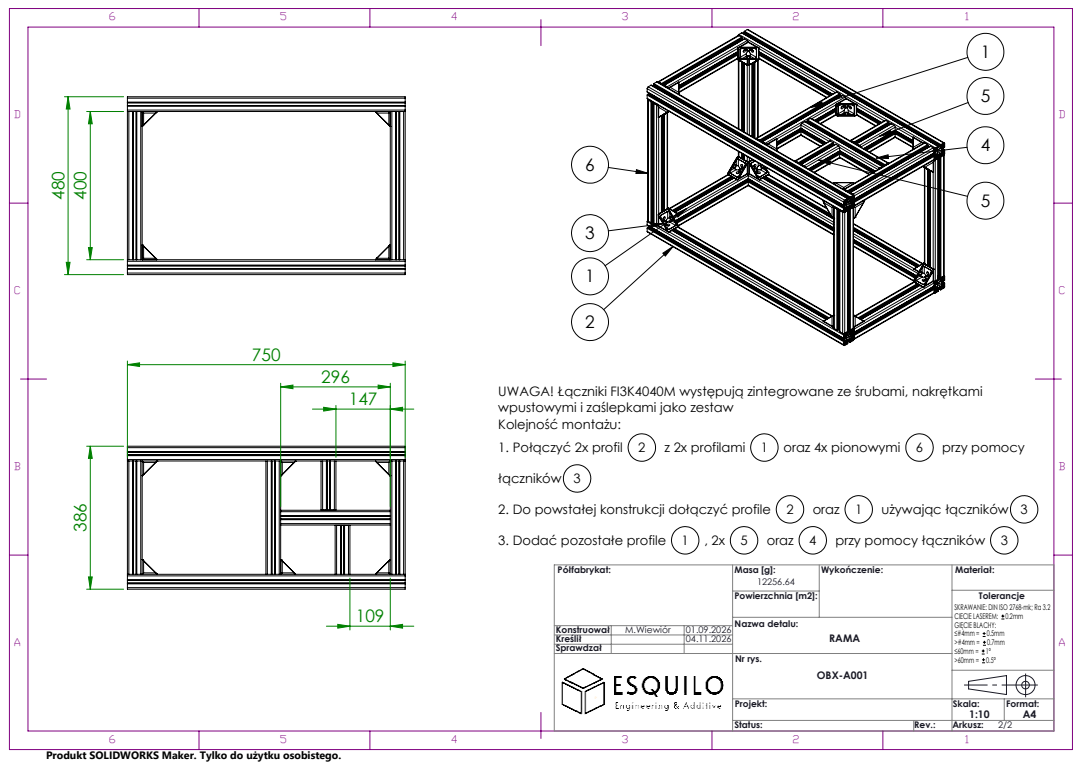
[picture p102: page 2]
Konstruował; 01.09.2026 Nazwa detalu:

UWAGA! Łączniki FI3K4040M występują zintegrowane ze śrubami, nakrętkami
wpustowymi i zaślepkami jako zestaw
Kolejność montażu:
1. Połączyć 2x profil 2 z 2x profilami 1 oraz 4x pionowymi 6 przy pomocy
łączników 3
2. Do powstałej konstrukcji dołączyć profile 2 oraz 1 używając łączników 3
3. Dodać pozostałe profile 1 , 2x 5 oraz 4 przy pomocy łączników 3

Półfabrykat: | Masa [g]: 12256.64 | Wykończenie: | Materiał:

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

Kreślił | | 04.11.2026
Sprawdzał

M.Wiewiór

Nr rys. OBX-A001

Projekt: | Skala: 1:10 | Format: A4
Status: | Rev.: | Arkusz: 2/2

Produkt SOLIDWORKS Maker. Tylko do użytku osobistego.
