obotx/diy-robot-kit/hardware/drawings/assemblies/OBX-A004_REV.pdf

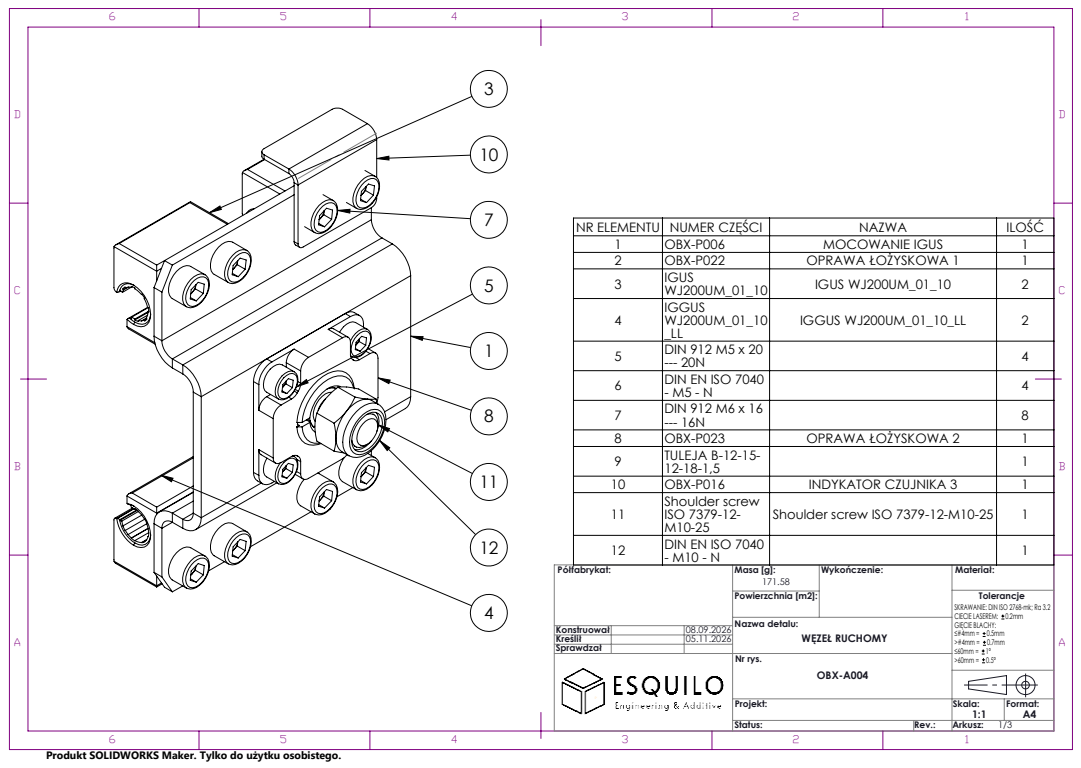
[picture p103: page 1]
WĘZEŁ RUCHOMY; Nazwa detalu: Konstruował

NR ELEMENTU | NUMER CZĘŚCI | NAZWA | ILOŚĆ
1 | OBX-P006 | MOCOWANIE IGUS | 1
2 | OBX-P022 | OPRAWA ŁOŻYSKOWA 1 | 1
3 | IGUS WJ200UM_01_10 | IGUS WJ200UM_01_10 | 2
4 | IGGUS WJ200UM_01_10 _LL | IGGUS WJ200UM_01_10_LL | 2

5 | DIN 912 M5 x 20 --- 20N | | 4
6 | DIN EN ISO 7040 - M5 - N | | 4
7 | DIN 912 M6 x 16 --- 16N | | 8
8 | OBX-P023 | OPRAWA ŁOŻYSKOWA 2 | 1
9 | TULEJA B-12-15-12-18-1,5 | | 1
10 | OBX-P016 | INDYKATOR CZUJNIKA 3 | 1
11 | Shoulder screw ISO 7379-12-M10-25 | Shoulder screw ISO 7379-12-M10-25 | 1

12 | DIN EN ISO 7040 - M10 - N | | 1

Półfabrykat: | Masa [g]: 171.58 | Wykończenie: | Materiał:

Powierzchnia [m2]: | | Tolerancje SKRAWANIE: DIN ISO 2768-mk; Ra 3.2 CIECIE LASEREM: 0.2mm GIĘCIE BLACHY: ≤#4mm = 0.5mm >#4mm = 0.7mm ≤60mm = 1° >60mm = 0.5°

Kreślił | | 05.11.2026
Sprawdzał

Nr rys. OBX-A004

Projekt: | Skala: 1:1 | Format: A4
Status: | Rev.: | Arkusz:

Produkt SOLIDWORKS Maker. Tylko do użytku osobistego.

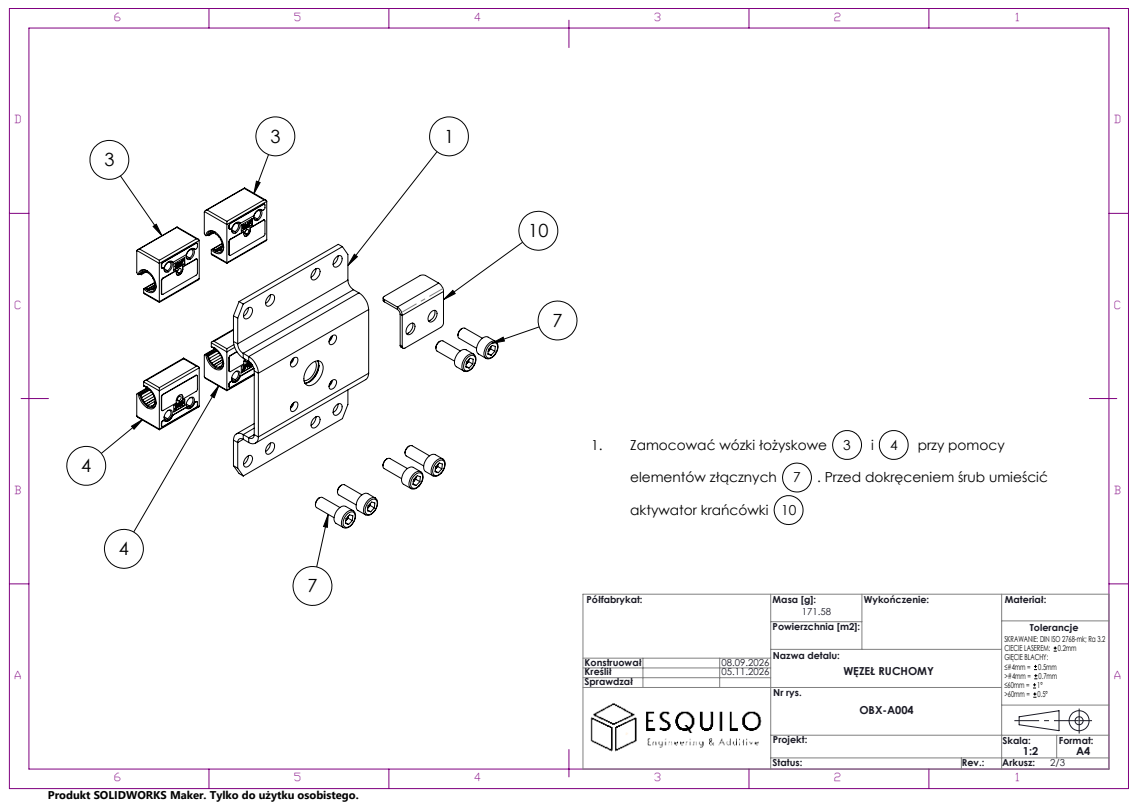
[picture p104: page 2]
WĘZEŁ RUCHOMY; Konstruował; 08.09.2026 Nazwa detalu:

1. Zamocować wózki łożyskowe 3 i 4 przy pomocy
elementów złącznych 7 . Przed dokręceniem śrub umieścić
aktywator krańcówki 10

Półfabrykat: | Masa [g]: 171.58 | Wykończenie: | Materiał:

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

Sprawdzał

Nr rys. OBX-A004

Projekt: | Skala: 1:2 | Format:

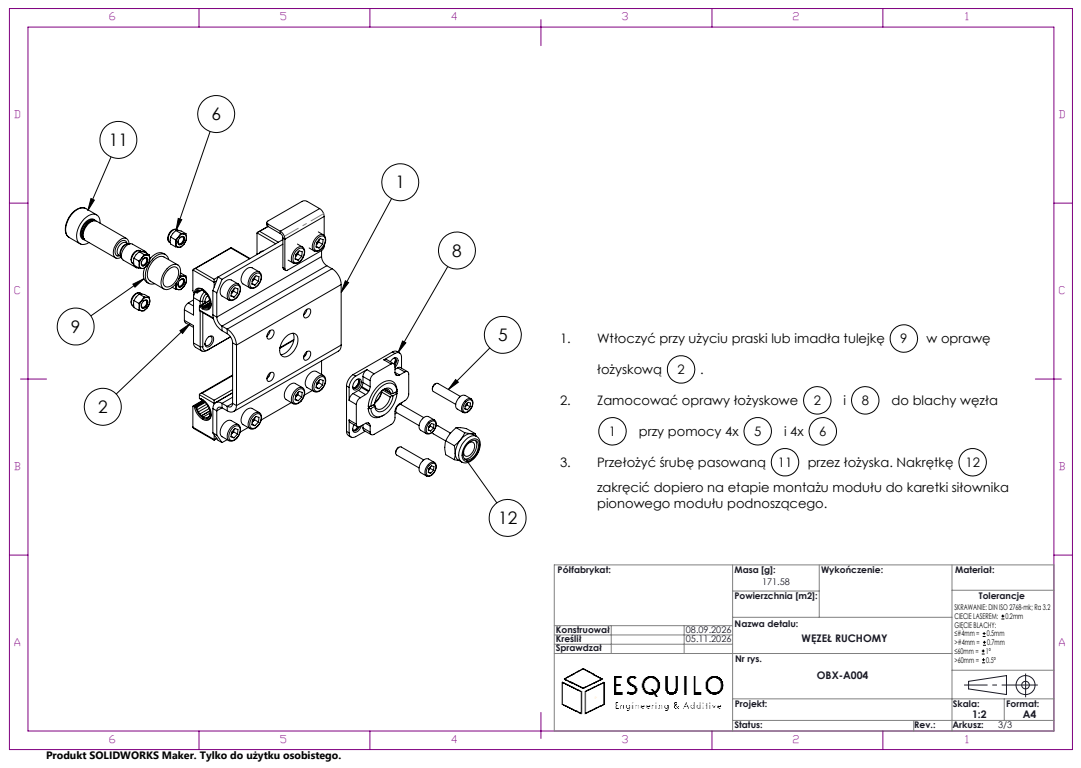
[picture p105: page 3]
Zamocować oprawy łożyskowe 2; do blachy węzła; przy pomocy 4x 5; WĘZEŁ RUCHOMY; Konstruował; 08.09.2026 Nazwa detalu:

1. Wtłoczyć przy użyciu praski lub imadła tulejkę 9 w oprawę
łożyskową 2 .
3. Przełożyć śrubę pasowaną 11 przez łożyska. Nakrętkę 12
zakręcić dopiero na etapie montażu modułu do karetki siłownika
pionowego modułu podnoszącego.

Półfabrykat: | Masa [g]: 171.58 | Wykończenie: | Materiał:

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

Sprawdzał

Nr rys. OBX-A004

Projekt: | Skala: 1:2 | Format:
