obotx/diy-robot-kit/hardware/drawings/assemblies/OBX-A005_REV.pdf

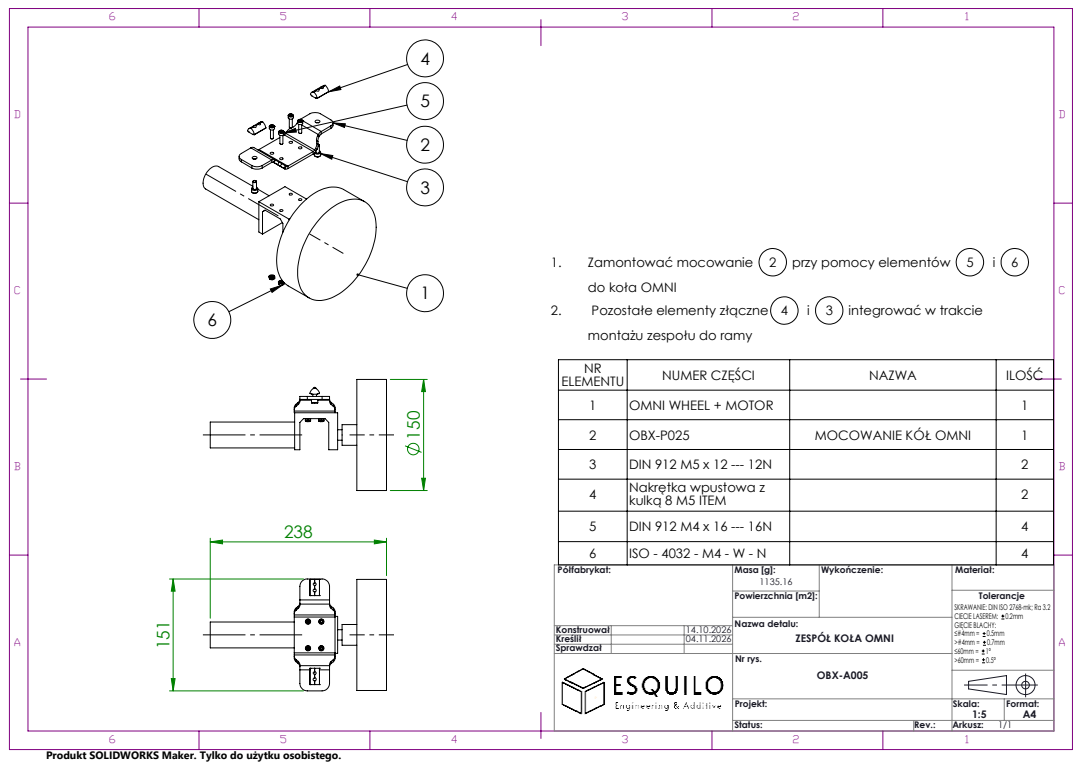
[picture p106: page 1]
Nazwa detalu: Konstruował

1. Zamontować mocowanie 2 przy pomocy elementów 5 i 6
do koła OMNI
2. Pozostałe elementy złączne 4 i 3 integrować w trakcie
montażu zespołu do ramy

NR ELEMENTU | NUMER CZĘŚCI | NAZWA | ILOŚĆ

1 | OMNI WHEEL + MOTOR | | 1
2 | OBX-P025 | MOCOWANIE KÓŁ OMNI | 1
3 | DIN 912 M5 x 12 --- 12N | | 2
4 | Nakrętka wpustowa z kulką 8 M5 ITEM | | 2

5 | DIN 912 M4 x 16 --- 16N | | 4
6 | ISO - 4032 - M4 - W - N | | 4
Półfabrykat: | Masa [g]: 1135.16 | Wykończenie: | Materiał:

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

Kreślił | | 04.11.2026
Sprawdzał

ZESPÓŁ KOŁA OMNI

Nr rys. OBX-A005

Projekt: | Skala: 1:5 | Format: A4
Status: | Rev.: | Arkusz: 1/1

Produkt SOLIDWORKS Maker. Tylko do użytku osobistego.
