obotx/diy-robot-kit/hardware/drawings/assemblies/OBX-A006_REV.pdf

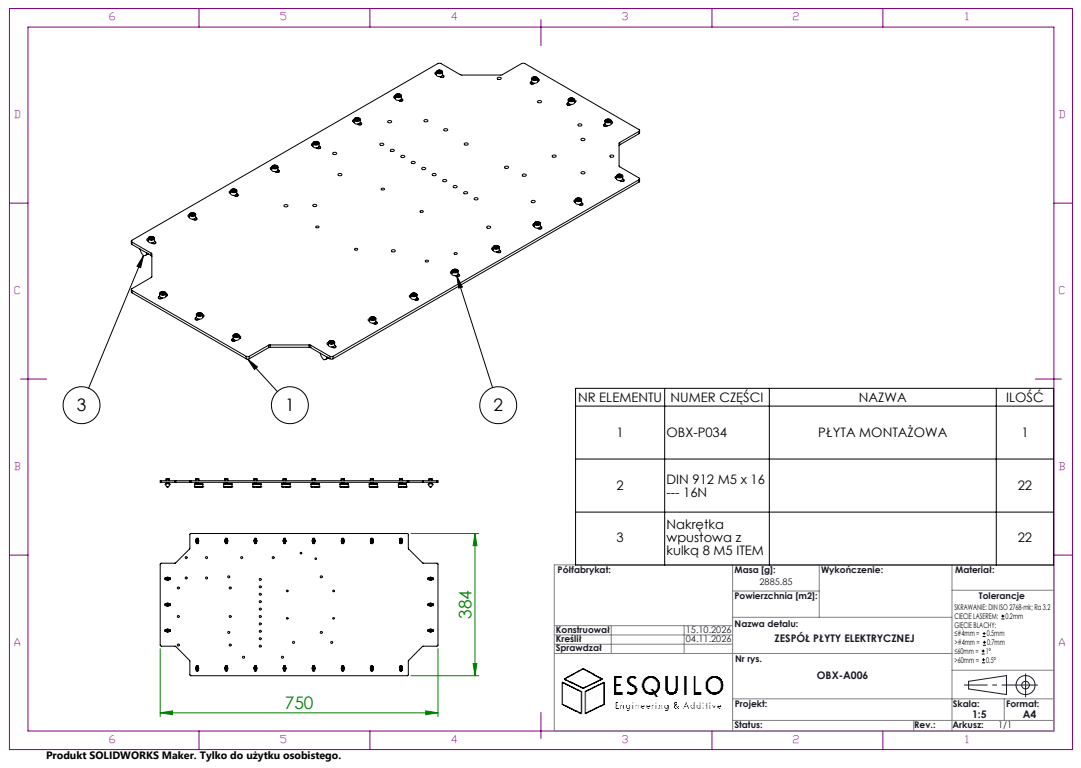
[picture p107: page 1]
Nazwa detalu: Konstruował

NR ELEMENTU | NUMER CZĘŚCI | NAZWA | ILOŚĆ

1 | OBX-P034 | PŁYTA MONTAŻOWA | 1

2 | DIN 912 M5 x 16 --- 16N | | 22

3 | Nakrętka wpustowa z kulką 8 M5 ITEM | | 22

Półfabrykat: | Masa [g]: 2885.85 | Wykończenie: | Materiał:

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

Kreślił | | 04.11.2026
Sprawdzał

ZESPÓŁ PŁYTY ELEKTRYCZNEJ

Nr rys. OBX-A006

Projekt: | Skala: 1:5 | Format: A4
Status: | Rev.: | Arkusz: 1/1

Produkt SOLIDWORKS Maker. Tylko do użytku osobistego.
