obotx/diy-robot-kit/hardware/drawings/assemblies/OBX-A007_REV.pdf

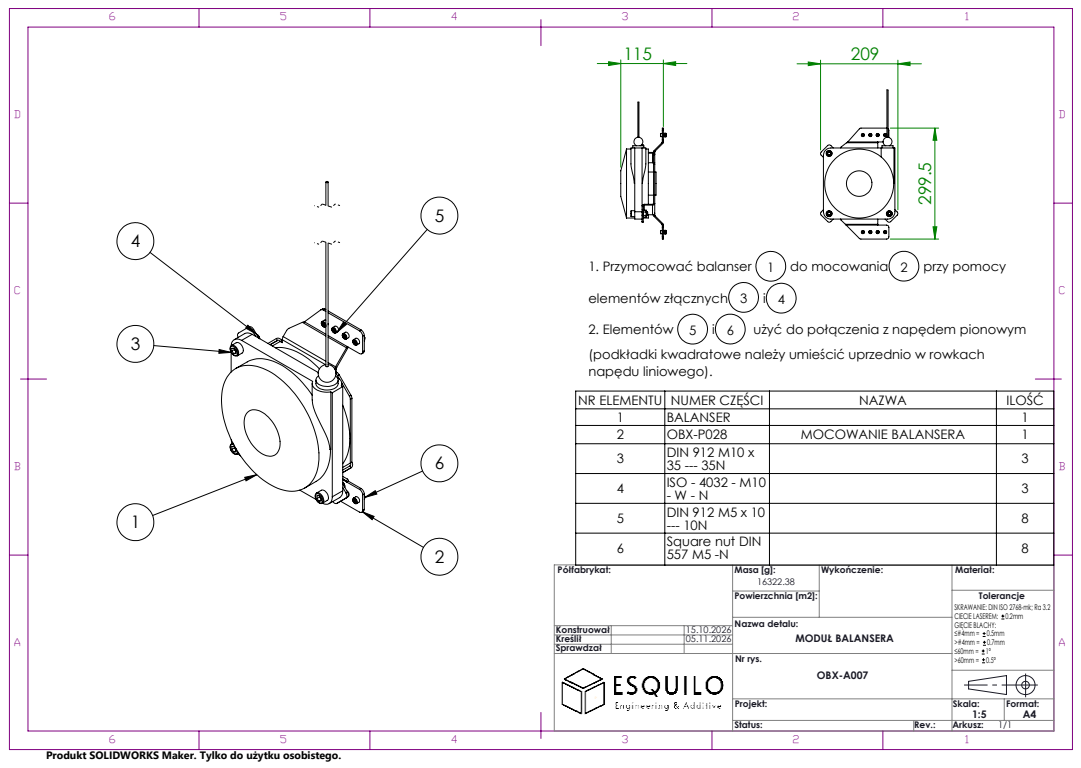
[picture p108: page 1]
MODUŁ BALANSERA; Nazwa detalu: Konstruował

1. Przymocować balanser 1 do mocowania 2 przy pomocy
elementów złącznych 3 i 4
2. Elementów 5 i 6 użyć do połączenia z napędem pionowym
(podkładki kwadratowe należy umieścić uprzednio w rowkach
napędu liniowego).

NR ELEMENTU | NUMER CZĘŚCI | NAZWA | ILOŚĆ
1 | BALANSER | | 1
2 | OBX-P028 | MOCOWANIE BALANSERA | 1
3 | DIN 912 M10 x 35 --- 35N | | 3
4 | ISO - 4032 - M10 - W - N | | 3
5 | DIN 912 M5 x 10 --- 10N | | 8
6 | Square nut DIN 557 M5 -N | | 8

Półfabrykat: | Masa [g]: 16322.38 | Wykończenie: | Materiał:

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

Kreślił | | 05.11.2026
Sprawdzał

Nr rys. OBX-A007

Projekt: | Skala: 1:5 | Format: A4
Status: | Rev.: | Arkusz: 1/1

Produkt SOLIDWORKS Maker. Tylko do użytku osobistego.
