obotx/diy-robot-kit/hardware/drawings/assemblies/OBX-A008_REV.pdf

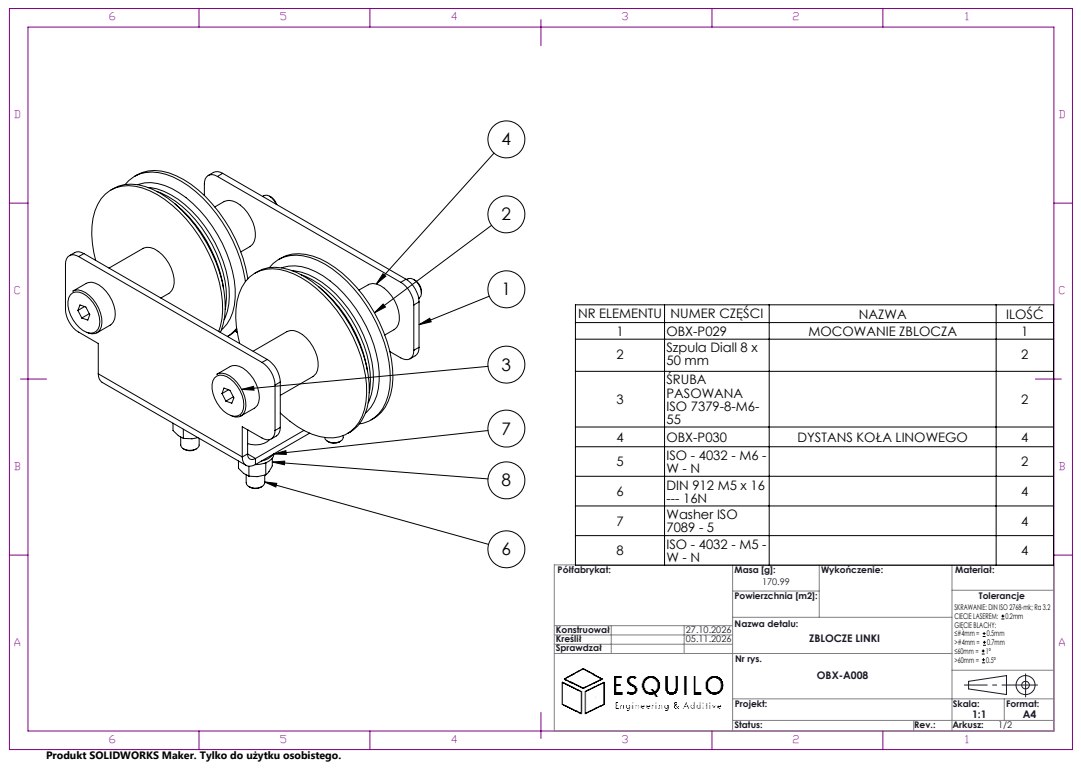
[picture p109: page 1]
ZBLOCZE LINKI; Nazwa detalu: Konstruował

NR ELEMENTU | NUMER CZĘŚCI | NAZWA | ILOŚĆ
1 | OBX-P029 | MOCOWANIE ZBLOCZA | 1
2 | Szpula Diall 8 x 50 mm | | 2
3 | ŚRUBA PASOWANA ISO 7379-8-M6-55 | | 2

4 | OBX-P030 | DYSTANS KOŁA LINOWEGO | 4
5 | ISO - 4032 - M6 -W - N | | 2
6 | DIN 912 M5 x 16 --- 16N | | 4
7 | Washer ISO 7089 - 5 | | 4
8 | ISO - 4032 - M5 -W - N | | 4

Półfabrykat: | Masa [g]: 170.99 | Wykończenie: | Materiał:

Powierzchnia [m2]: | | Tolerancje SKRAWANIE: DIN ISO 2768-mk; Ra 3.2 CIECIE LASEREM: 0.2mm GIĘCIE BLACHY: ≤#4mm = 0.5mm >#4mm = 0.7mm ≤60mm = 1° >60mm = 0.5°

Kreślił | | 05.11.2026
Sprawdzał

Nr rys. OBX-A008

Projekt: | Skala: 1:1 | Format: A4
Status: | Rev.: | Arkusz: 1/2

Produkt SOLIDWORKS Maker. Tylko do użytku osobistego.

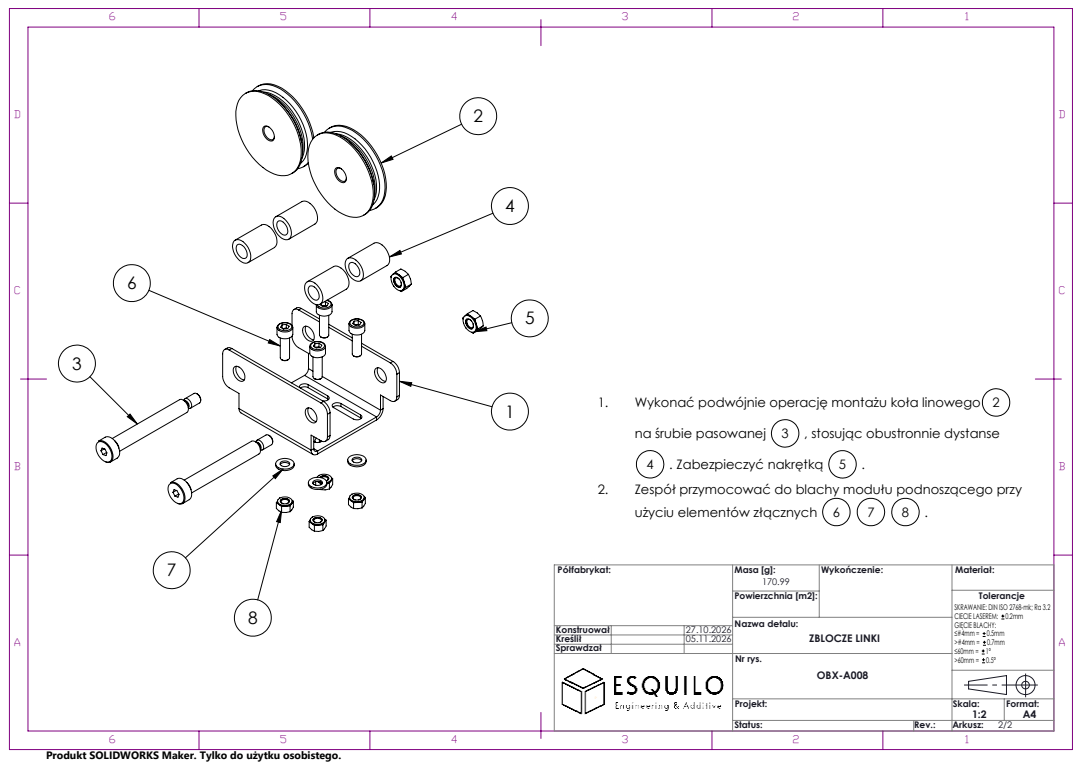
[picture p110: page 2]
użyciu elementów złącznych 6; ZBLOCZE LINKI; Konstruował; 27.10.2026 Nazwa detalu:

1. Wykonać podwójnie operację montażu koła linowego 2
na śrubie pasowanej 3 , stosując obustronnie dystanse
4 . Zabezpieczyć nakrętką 5 .
2. Zespół przymocować do blachy modułu podnoszącego przy

Półfabrykat: | Masa [g]: 170.99 | Wykończenie: | Materiał:

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

Sprawdzał

Nr rys. OBX-A008

Projekt: | Skala: 1:2 | Format: A4
Status: | Rev.: | Arkusz: 2/2

Produkt SOLIDWORKS Maker. Tylko do użytku osobistego.
