obotx/diy-robot-kit/hardware/drawings/assemblies/OBX-A010_REV.pdf

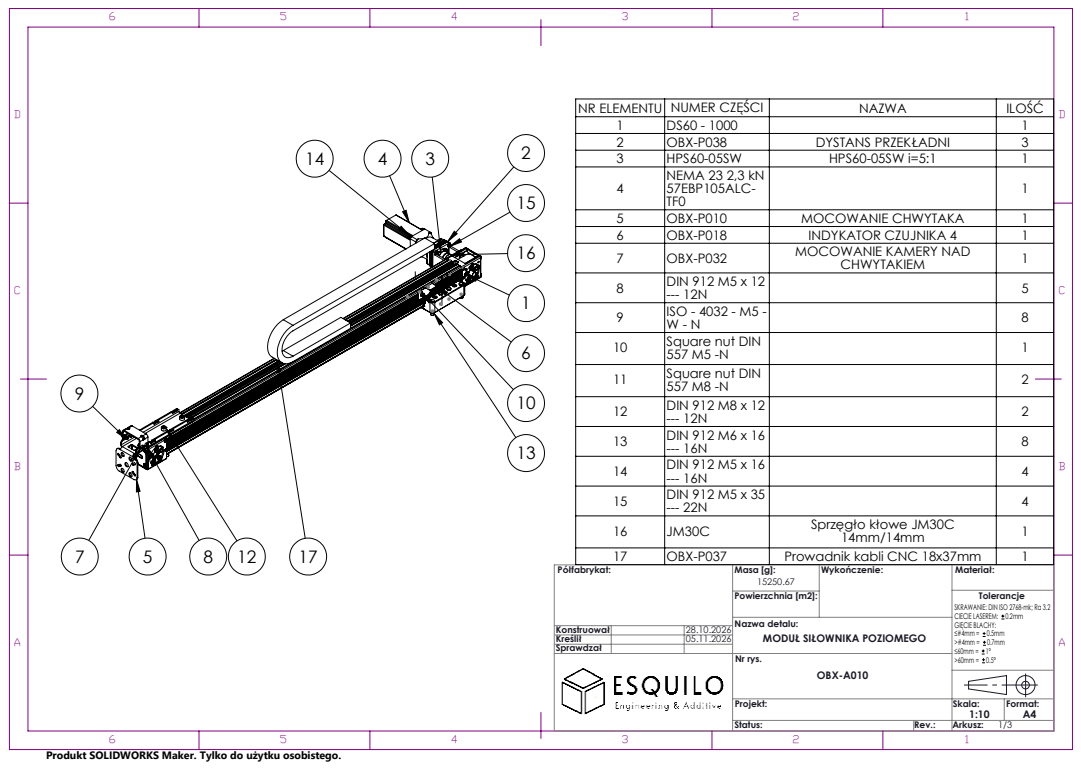
[picture p111: page 1]
Nazwa detalu: Konstruował

NR ELEMENTU | NUMER CZĘŚCI | NAZWA | ILOŚĆ
1 | DS60 - 1000 | | 1
2 | OBX-P038 | DYSTANS PRZEKŁADNI | 3
3 | HPS60-05SW | HPS60-05SW i=5:1 | 1
4 | NEMA 23 2,3 kN 57EBP105ALC-TF0 | | 1

5 | OBX-P010 | MOCOWANIE CHWYTAKA | 1
6 | OBX-P018 | INDYKATOR CZUJNIKA 4 | 1
7 | OBX-P032 | MOCOWANIE KAMERY NAD CHWYTAKIEM | 1
8 | DIN 912 M5 x 12 --- 12N | | 5
9 | ISO - 4032 - M5 -W - N | | 8
10 | Square nut DIN 557 M5 -N | | 1
11 | Square nut DIN 557 M8 -N | | 2
12 | DIN 912 M8 x 12 --- 12N | | 2
13 | DIN 912 M6 x 16 --- 16N | | 8
14 | DIN 912 M5 x 16 --- 16N | | 4
15 | DIN 912 M5 x 35 --- 22N | | 4
16 | JM30C | Sprzęgło kłowe JM30C 14mm/14mm | 1
17 | OBX-P037 | Prowadnik kabli CNC 18x37mm | 1

Półfabrykat: | Masa [g]: 15250.67 | Wykończenie: | Materiał:

Powierzchnia [m2]: | | Tolerancje SKRAWANIE: DIN ISO 2768-mk; Ra 3.2 CIECIE LASEREM: 0.2mm GIĘCIE BLACHY: ≤#4mm = 0.5mm >#4mm = 0.7mm ≤60mm = 1° >60mm = 0.5°

Kreślił | | 05.11.2026
Sprawdzał

MODUŁ SIŁOWNIKA POZIOMEGO

Nr rys. OBX-A010

Projekt: | Skala: 1:10 | Format: A4
Status: | Rev.: | Arkusz:

Produkt SOLIDWORKS Maker. Tylko do użytku osobistego.

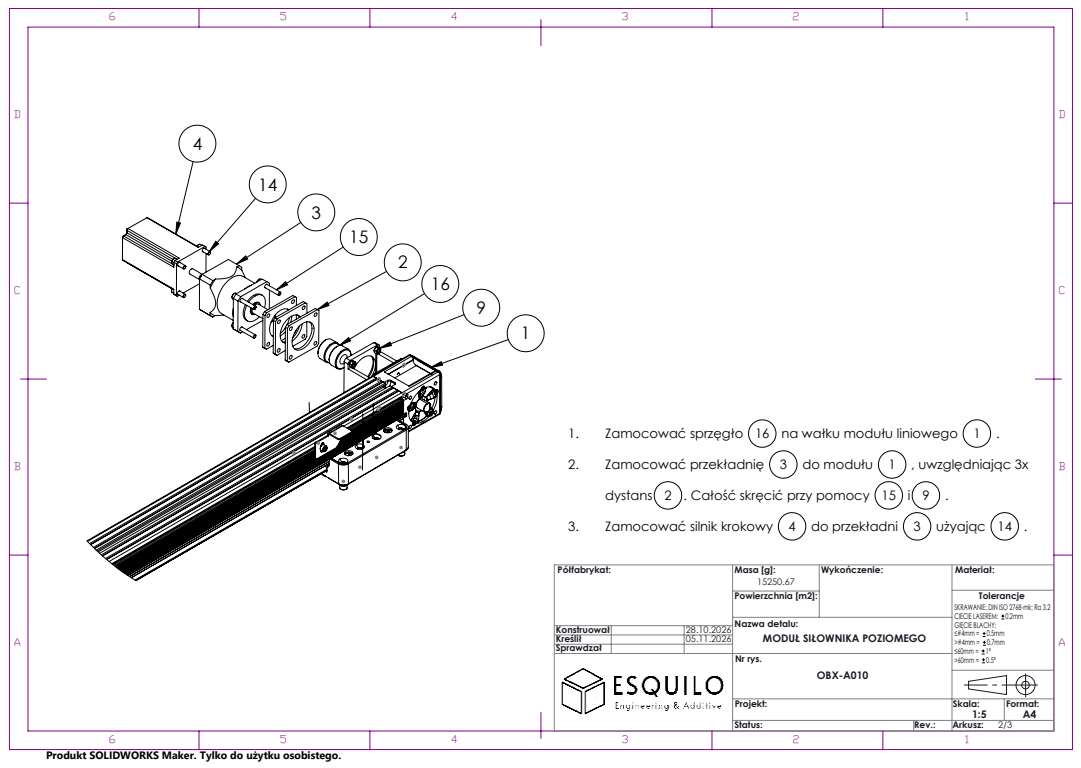
[picture p112: page 2]
MODUŁ SIŁOWNIKA POZIOMEGO; Konstruował; 28.10.2026 Nazwa detalu:

1. Zamocować sprzęgło 16 na wałku modułu liniowego 1 .
2. Zamocować przekładnię 3 do modułu 1 , uwzględniając 3x
dystans 2 . Całość skręcić przy pomocy 15 i 9 .
3. Zamocować silnik krokowy 4 do przekładni 3 użyając 14 .

Półfabrykat: | Masa [g]: 15250.67 | Wykończenie: | Materiał:

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

Sprawdzał

Nr rys. OBX-A010

Projekt: | Skala: 1:5 | Format:

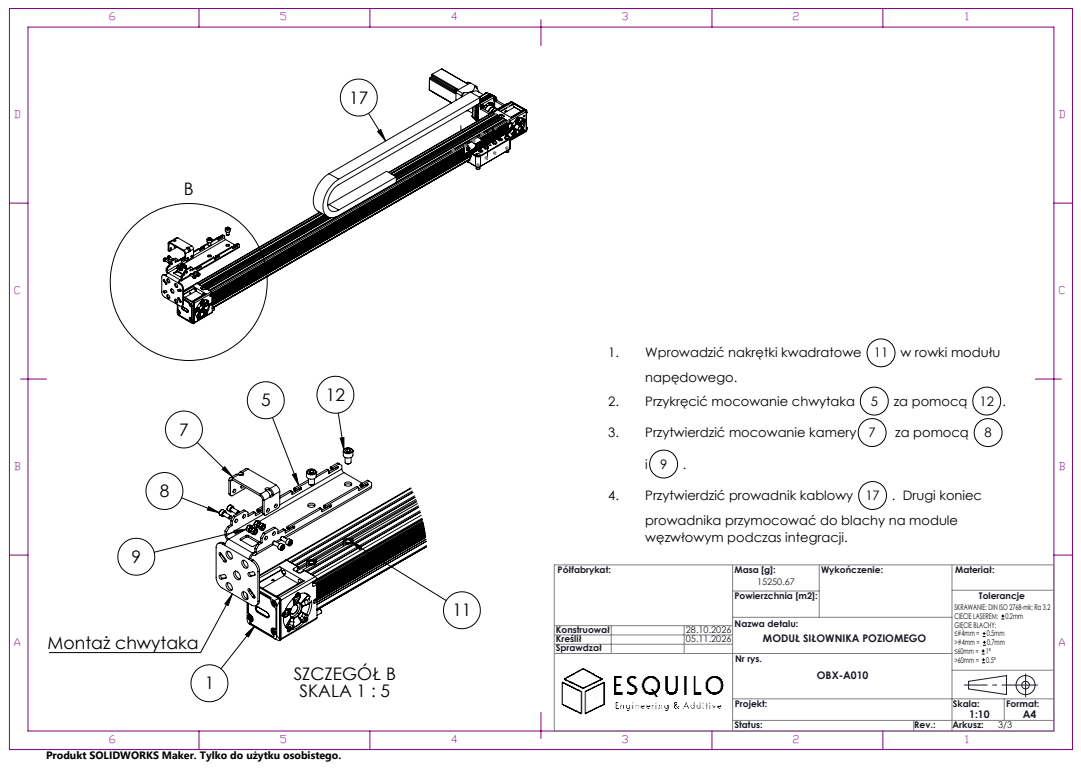
[picture p113: page 3]
SZCZEGÓŁ B SKALA 1 : 5; Montaż chwytaka; MODUŁ SIŁOWNIKA POZIOMEGO; Konstruował; 28.10.2026 Nazwa detalu:

1. Wprowadzić nakrętki kwadratowe 11 w rowki modułu
napędowego.
2. Przykręcić mocowanie chwytaka 5 za pomocą 12 .
3. Przytwierdzić mocowanie kamery 7 za pomocą 8
4. Przytwierdzić prowadnik kablowy 17 . Drugi koniec
prowadnika przymocować do blachy na module
węzwłowym podczas integracji.

Półfabrykat: | Masa [g]: 15250.67 | Wykończenie: | Materiał:

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

Sprawdzał

Nr rys. OBX-A010

Projekt: | Skala: 1:10 | Format:
