obotx/diy-robot-kit/hardware/drawings/assemblies/OBX-A011_REV.pdf

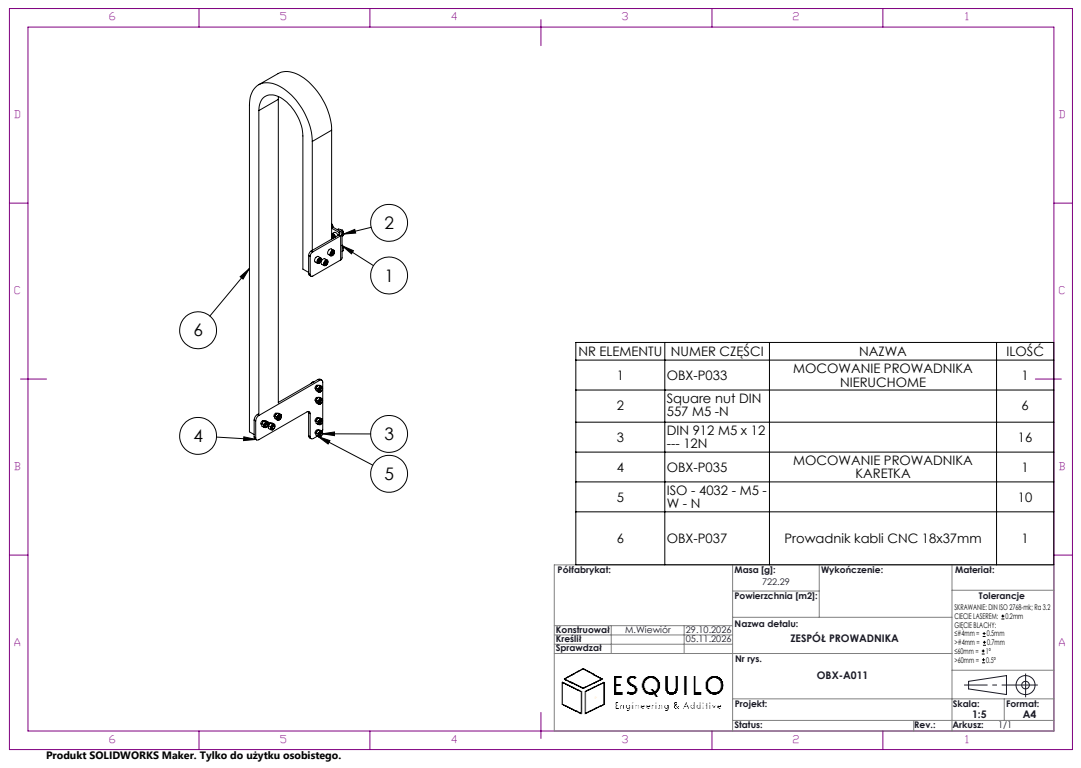
[picture p114: page 1]
ZESPÓŁ PROWADNIKA; Nazwa detalu: Konstruował

NR ELEMENTU | NUMER CZĘŚCI | NAZWA | ILOŚĆ
1 | OBX-P033 | MOCOWANIE PROWADNIKA NIERUCHOME | 1
2 | Square nut DIN 557 M5 -N | | 6
3 | DIN 912 M5 x 12 --- 12N | | 16
4 | OBX-P035 | MOCOWANIE PROWADNIKA KARETKA | 1
5 | ISO - 4032 - M5 -W - N | | 10

6 | OBX-P037 | Prowadnik kabli CNC 18x37mm | 1

Półfabrykat: | Masa [g]: 722.29 | Wykończenie: | Materiał:

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

Kreślił | | 05.11.2026
Sprawdzał

M.Wiewiór

Nr rys. OBX-A011

Projekt: | Skala: 1:5 | Format: A4
Status: | Rev.: | Arkusz: 1/1

Produkt SOLIDWORKS Maker. Tylko do użytku osobistego.
