obotx/diy-robot-kit/hardware/drawings/assemblies/OBX-A012_REV.pdf

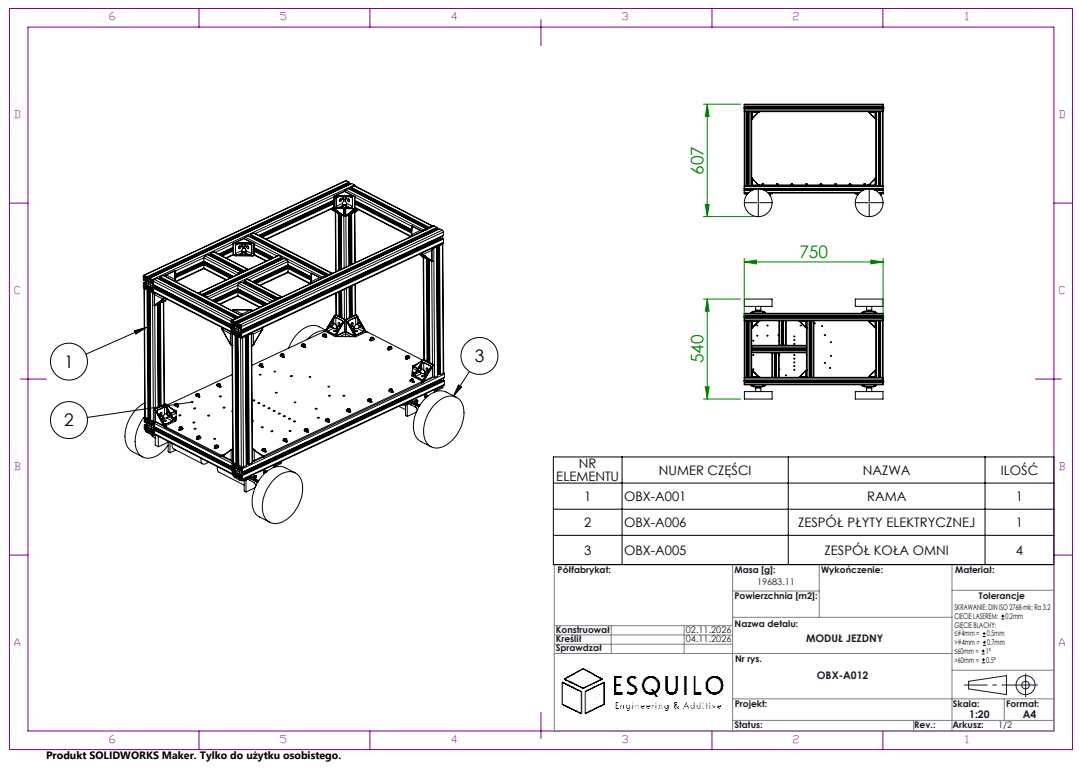
[picture p115: page 1]
MODUŁ JEZDNY; Nazwa detalu: Konstruował

NR ELEMENTU | NUMER CZĘŚCI | NAZWA | ILOŚĆ
1 | OBX-A001 | RAMA | 1
2 | OBX-A006 | ZESPÓŁ PŁYTY ELEKTRYCZNEJ | 1
3 | OBX-A005 | ZESPÓŁ KOŁA OMNI | 4
Półfabrykat: | Masa [g]: 19683.11 | Wykończenie: | Materiał:

Powierzchnia [m2]: | | Tolerancje SKRAWANIE: DIN ISO 2768-mk; Ra 3.2 CIECIE LASEREM: 0.2mm GIĘCIE BLACHY: ≤#4mm = 0.5mm >#4mm = 0.7mm ≤60mm = 1° >60mm = 0.5°

Kreślił | | 04.11.2026
Sprawdzał

Nr rys. OBX-A012

Projekt: | Skala: 1:20 | Format: A4
Status: | Rev.: | Arkusz: 1/2

Produkt SOLIDWORKS Maker. Tylko do użytku osobistego.

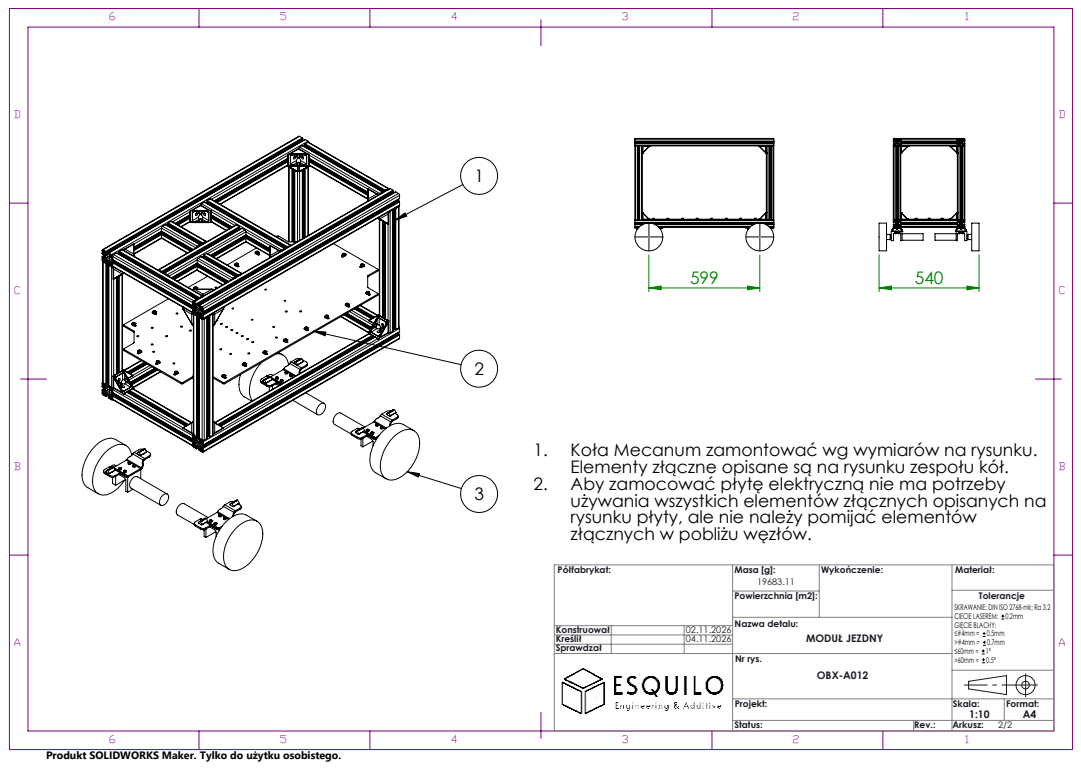
[picture p116: page 2]
MODUŁ JEZDNY; Konstruował; 02.11.2026 Nazwa detalu:

1. Koła Mecanum zamontować wg wymiarów na rysunku.
Elementy złączne opisane są na rysunku zespołu kół.
2. Aby zamocować płytę elektryczną nie ma potrzeby

używania wszystkich elementów złącznych opisanych na
rysunku płyty, ale nie należy pomijać elementów
złącznych w pobliżu węzłów.

Półfabrykat: | Masa [g]: 19683.11 | Wykończenie: | Materiał:

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

Sprawdzał

Nr rys. OBX-A012

Projekt: | Skala: 1:10 | Format: A4
Status: | Rev.: | Arkusz: 2/2

Produkt SOLIDWORKS Maker. Tylko do użytku osobistego.
