obotx/diy-robot-kit/hardware/drawings/parts/OBX-P004_REV.pdf

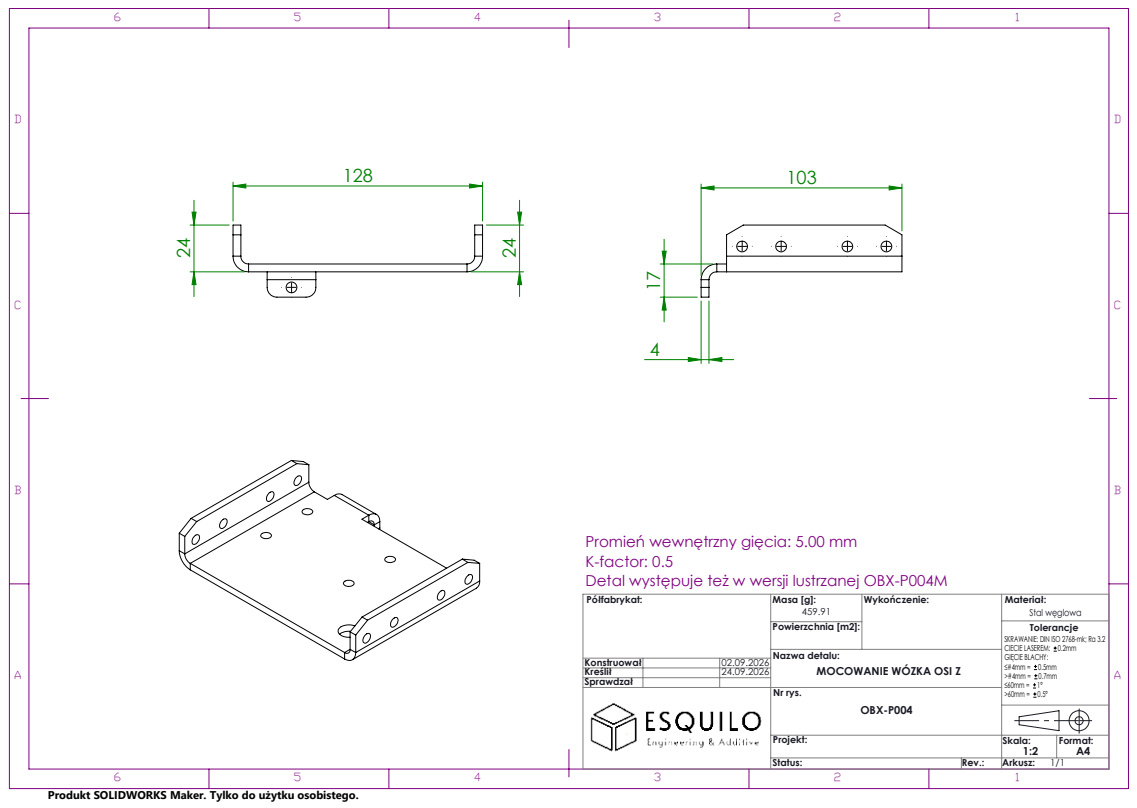
[picture p117: page 1]
Nazwa detalu: Konstruował

Promień wewnętrzny gięcia: 5.00 mm
K-factor: 0.5
Detal występuje też w wersji lustrzanej OBX-P004M

Półfabrykat: | Masa [g]: 459.91 | Wykończenie: | Materiał: Stal węglowa

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

Kreślił | | 24.09.2026
Sprawdzał

MOCOWANIE WÓZKA OSI Z

Nr rys. OBX-P004

Projekt: | Skala: 1:2 | Format: A4
Status: | Rev.: | Arkusz: 1/1

Produkt SOLIDWORKS Maker. Tylko do użytku osobistego.
