obotx/diy-robot-kit/hardware/drawings/parts/OBX-P005_REV.pdf

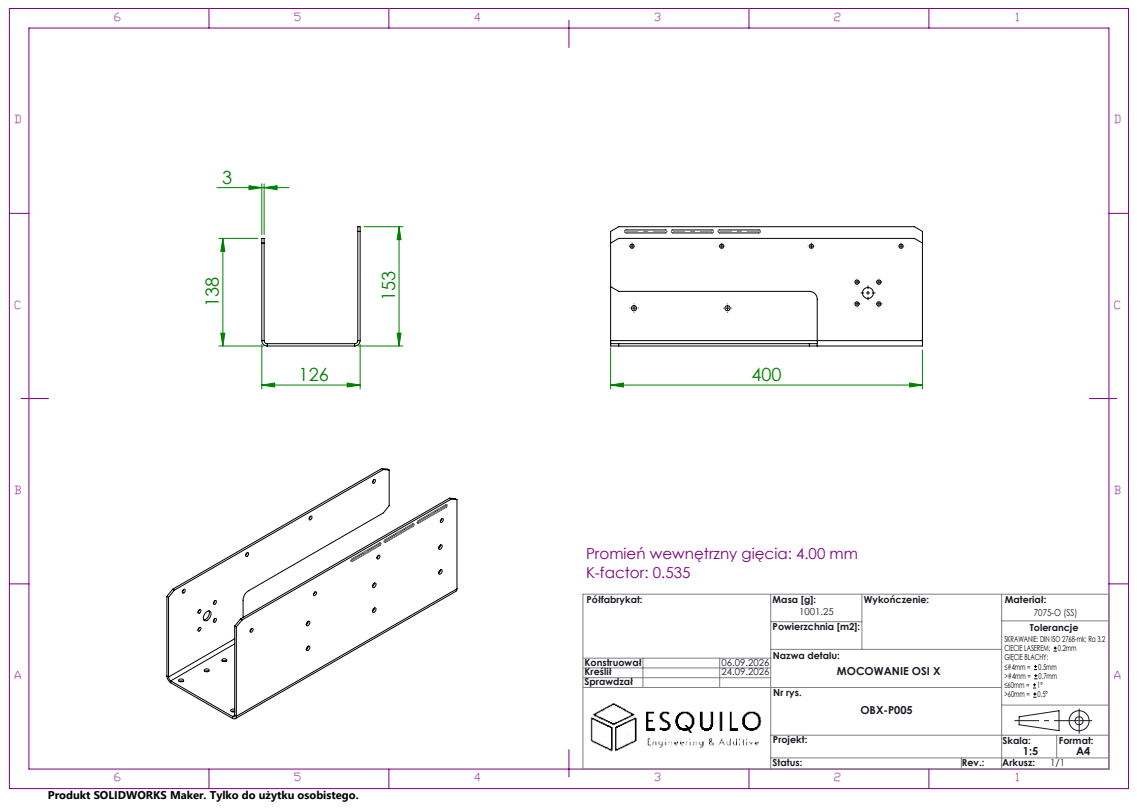
[picture p118: page 1]
MOCOWANIE OSI X; Nazwa detalu: Konstruował

Promień wewnętrzny gięcia: 4.00 mm
K-factor: 0.535

Półfabrykat: | Masa [g]: 1001.25 | Wykończenie: | Materiał: 7075-O (SS)

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

Kreślił | | 24.09.2026
Sprawdzał

Nr rys. OBX-P005

Projekt: | Skala: 1:5 | Format: A4
Status: | Rev.: | Arkusz: 1/1

Produkt SOLIDWORKS Maker. Tylko do użytku osobistego.
