obotx/diy-robot-kit/hardware/drawings/parts/OBX-P007_REV.pdf

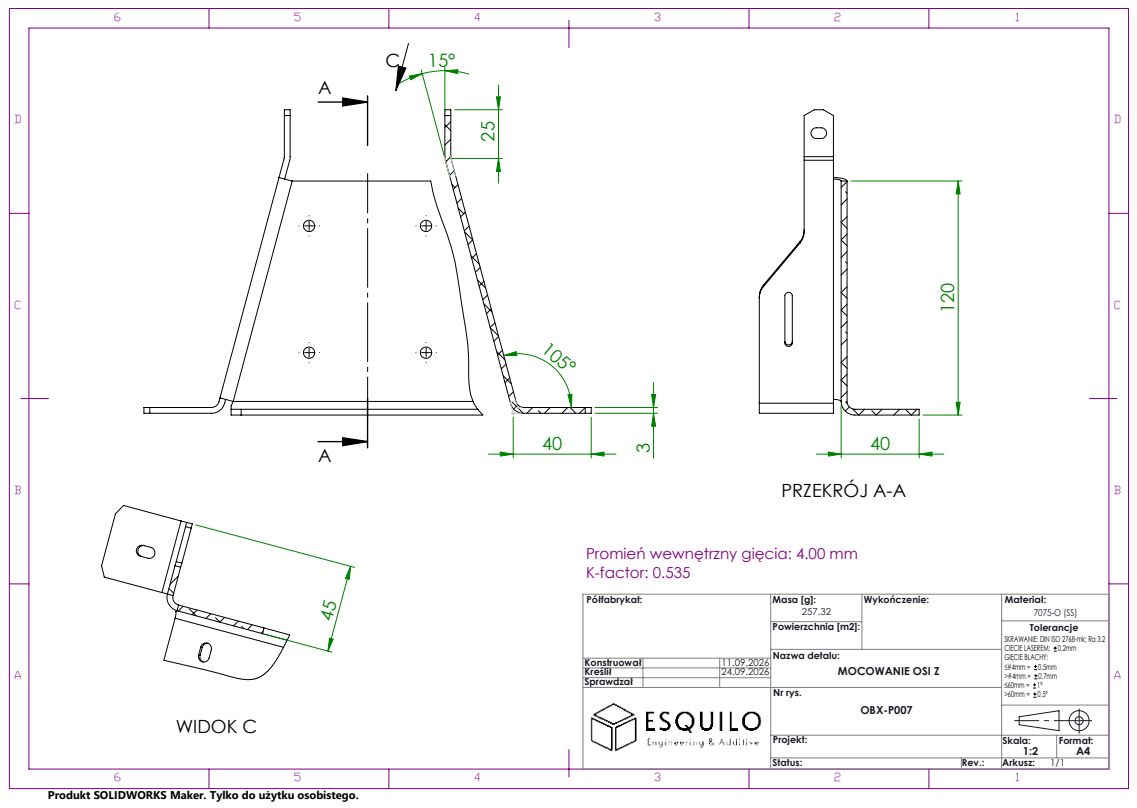
[picture p119: page 1]
PRZEKRÓJ A-A; WIDOK C; MOCOWANIE OSI Z; Nazwa detalu: Konstruował

Promień wewnętrzny gięcia: 4.00 mm
K-factor: 0.535

Półfabrykat: | Masa [g]: 257.32 | Wykończenie: | Materiał: 7075-O (SS)

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

Kreślił | | 24.09.2026
Sprawdzał

Nr rys. OBX-P007

Projekt: | Skala: 1:2 | Format: A4
Status: | Rev.: | Arkusz: 1/1

Produkt SOLIDWORKS Maker. Tylko do użytku osobistego.
