obotx/diy-robot-kit/hardware/drawings/parts/OBX-P008_REV.pdf

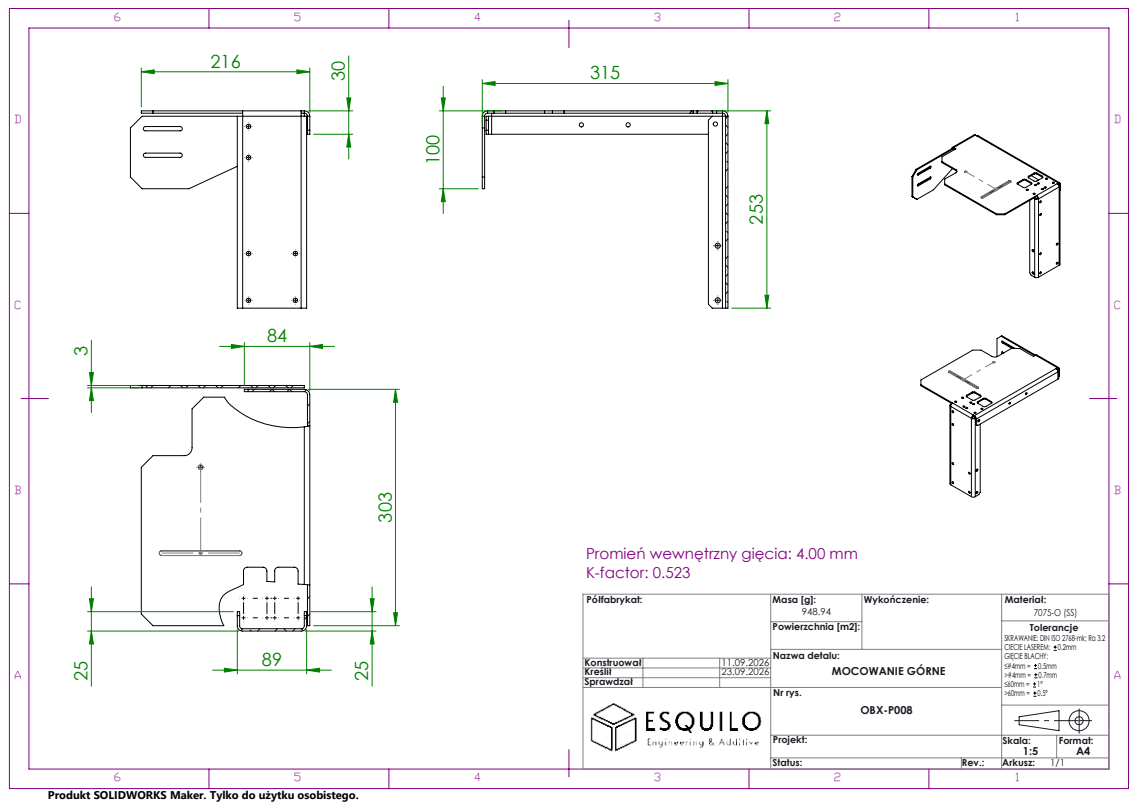
[picture p120: page 1]
MOCOWANIE GÓRNE

Promień wewnętrzny gięcia: 4.00 mm
K-factor: 0.523

Półfabrykat: | Masa [g]: 948.94 | Wykończenie: | Materiał: 7075-O (SS)

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

Nazwa detalu: Konstruował

Kreślił | | 23.09.2026
Sprawdzał

Nr rys. OBX-P008

Projekt: | Skala: 1:5 | Format: A4
Status: | Rev.: | Arkusz: 1/1

Produkt SOLIDWORKS Maker. Tylko do użytku osobistego.
