obotx/diy-robot-kit/hardware/drawings/parts/OBX-P009_REV.pdf

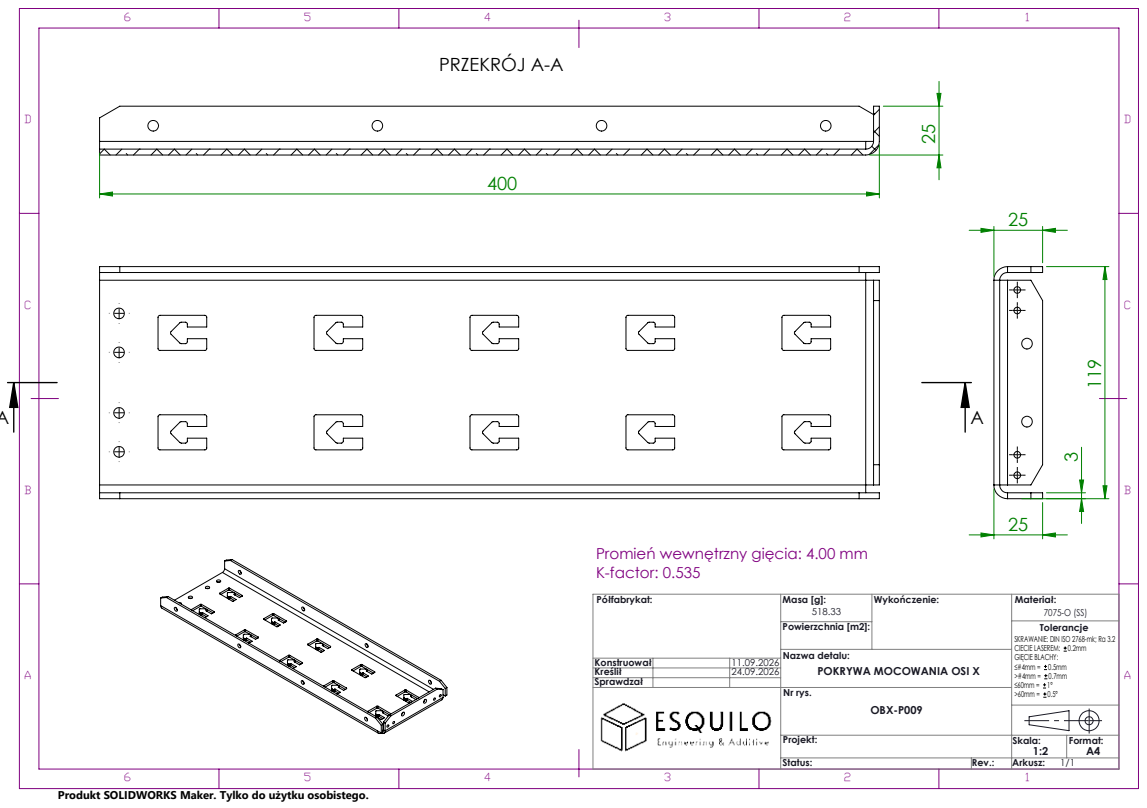
[picture p121: page 1]
Nazwa detalu: Konstruował

PRZEKRÓJ A-A | 25

Promień wewnętrzny gięcia: 4.00 mm
K-factor: 0.535

Półfabrykat: | Masa [g]: 518.33 | Wykończenie: | Materiał: 7075-O (SS)

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

Kreślił | | 24.09.2026
Sprawdzał

POKRYWA MOCOWANIA OSI X

Nr rys. OBX-P009

Projekt: | Skala: 1:2 | Format: A4
Status: | Rev.: | Arkusz: 1/1

Produkt SOLIDWORKS Maker. Tylko do użytku osobistego.
