obotx/diy-robot-kit/hardware/drawings/parts/OBX-P010_REV.pdf

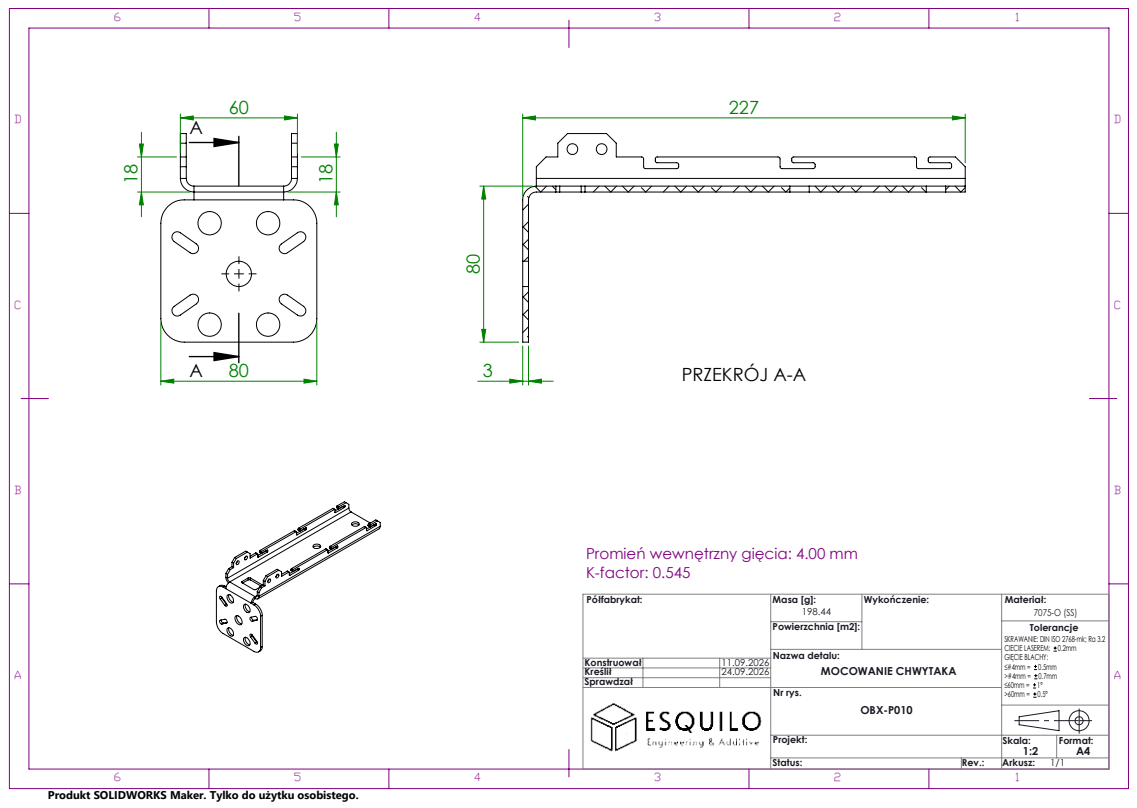
[picture p122: page 1]
PRZEKRÓJ A-A; MOCOWANIE CHWYTAKA; Nazwa detalu: Konstruował

Promień wewnętrzny gięcia: 4.00 mm
K-factor: 0.545

Półfabrykat: | Masa [g]: 198.44 | Wykończenie: | Materiał: 7075-O (SS)

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

Kreślił | | 24.09.2026
Sprawdzał

Nr rys. OBX-P010

Projekt: | Skala: 1:2 | Format: A4
Status: | Rev.: | Arkusz: 1/1

Produkt SOLIDWORKS Maker. Tylko do użytku osobistego.
