obotx/diy-robot-kit/hardware/drawings/parts/OBX-P015_REV.pdf

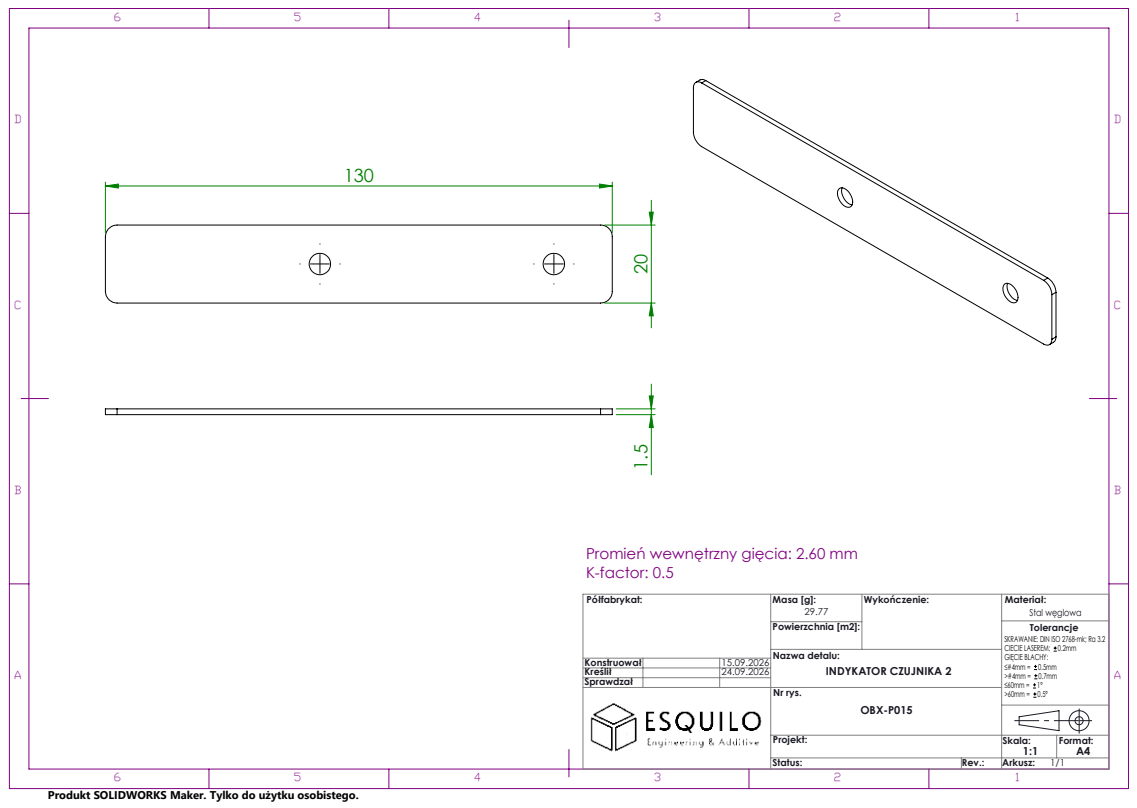
[picture p123: page 1]
INDYKATOR CZUJNIKA 2; Nazwa detalu: Konstruował

Promień wewnętrzny gięcia: 2.60 mm
K-factor: 0.5

Półfabrykat: | Masa [g]: 29.77 | Wykończenie: | Materiał: Stal węglowa

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

Kreślił | | 24.09.2026
Sprawdzał

Nr rys. OBX-P015

Projekt: | Skala: 1:1 | Format: A4
Status: | Rev.: | Arkusz: 1/1

Produkt SOLIDWORKS Maker. Tylko do użytku osobistego.
