obotx/diy-robot-kit/hardware/drawings/parts/OBX-P016_REV.pdf

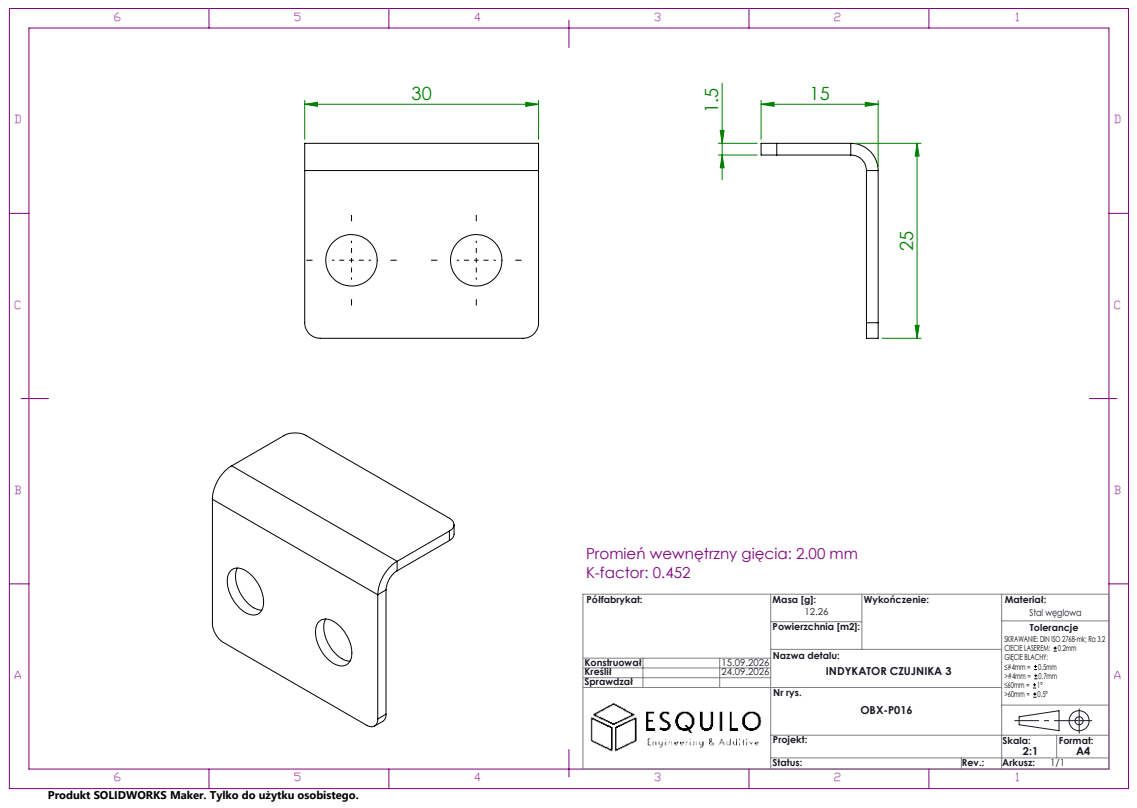
[picture p124: page 1]
INDYKATOR CZUJNIKA 3; Nazwa detalu: Konstruował

Promień wewnętrzny gięcia: 2.00 mm
K-factor: 0.452

Półfabrykat: | Masa [g]: 12.26 | Wykończenie: | Materiał: Stal węglowa

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

Kreślił | | 24.09.2026
Sprawdzał

Nr rys. OBX-P016

Projekt: | Skala: 2:1 | Format: A4
Status: | Rev.: | Arkusz: 1/1

Produkt SOLIDWORKS Maker. Tylko do użytku osobistego.
