obotx/diy-robot-kit/hardware/drawings/parts/OBX-P017_REV.pdf

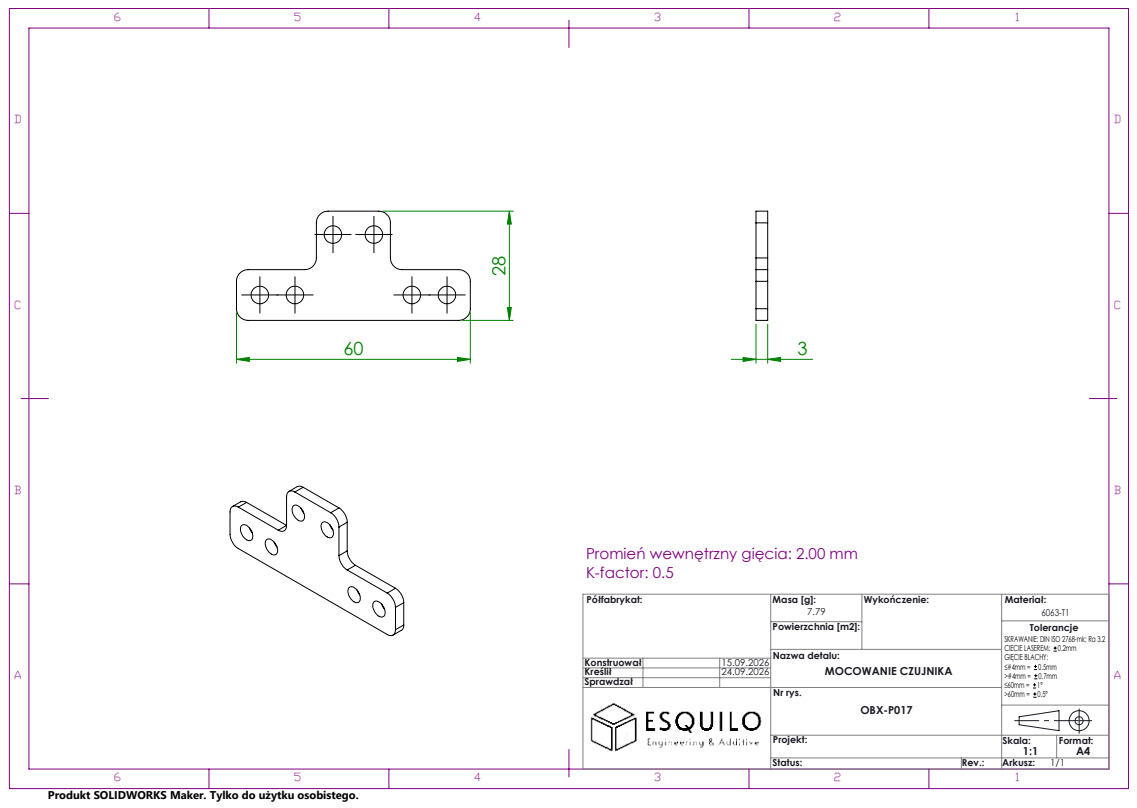
[picture p125: page 1]
MOCOWANIE CZUJNIKA; Nazwa detalu: Konstruował

Promień wewnętrzny gięcia: 2.00 mm
K-factor: 0.5

Półfabrykat: | Masa [g]: 7.79 | Wykończenie: | Materiał: 6063-T1

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

Kreślił | | 24.09.2026
Sprawdzał

Nr rys. OBX-P017

Projekt: | Skala: 1:1 | Format: A4
Status: | Rev.: | Arkusz: 1/1

Produkt SOLIDWORKS Maker. Tylko do użytku osobistego.
