obotx/diy-robot-kit/hardware/drawings/parts/OBX-P022_REV.pdf

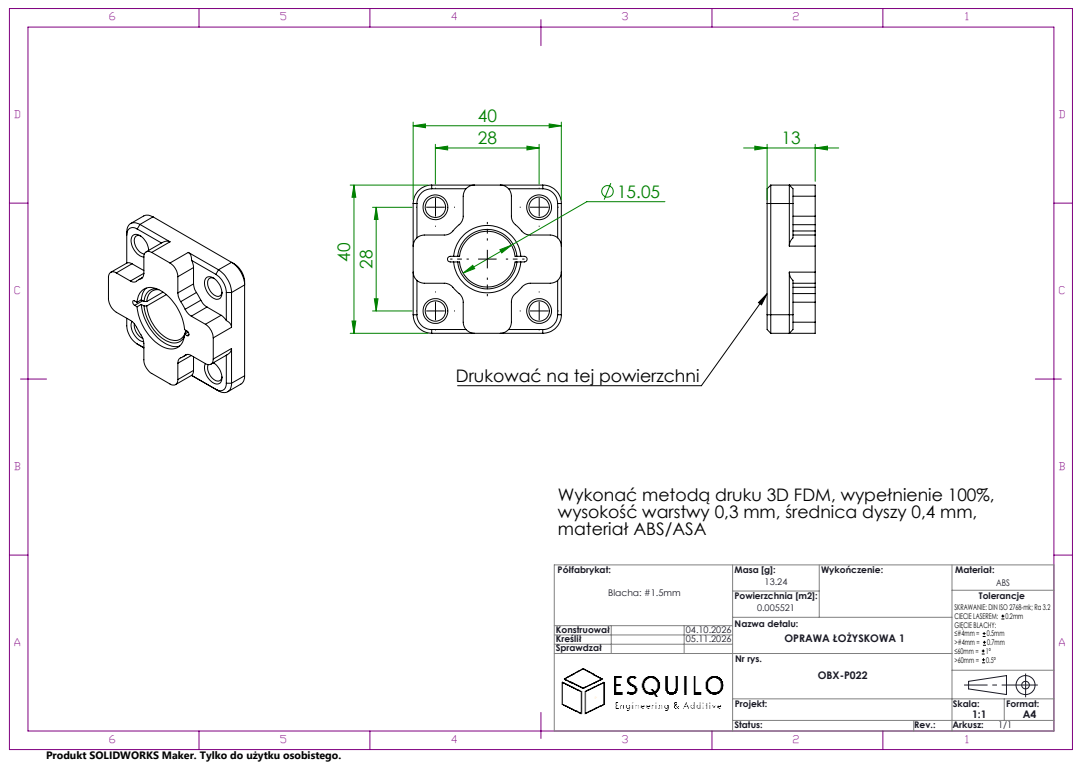
[picture p126: page 1]
OPRAWA ŁOŻYSKOWA 1; Nazwa detalu: Konstruował

Drukować na tej powierzchni

Wykonać metodą druku 3D FDM, wypełnienie 100%,
wysokość warstwy 0,3 mm, średnica dyszy 0,4 mm,
materiał ABS/ASA

Półfabrykat: Blacha: #1.5mm | Masa [g]: 13.24 | Wykończenie: | Materiał: ABS

Powierzchnia [m2]: 0.005521 | | Tolerancje SKRAWANIE: DIN ISO 2768-mk; Ra 3.2 CIECIE LASEREM: 0.2mm GIĘCIE BLACHY: ≤#4mm = 0.5mm >#4mm = 0.7mm ≤60mm = 1° >60mm = 0.5°

Kreślił | | 05.11.2026
Sprawdzał

Nr rys. OBX-P022

Projekt: | Skala: 1:1 | Format: A4
Status: | Rev.: | Arkusz: 1/1

Produkt SOLIDWORKS Maker. Tylko do użytku osobistego.
