obotx/diy-robot-kit/hardware/drawings/parts/OBX-P025_REV.pdf

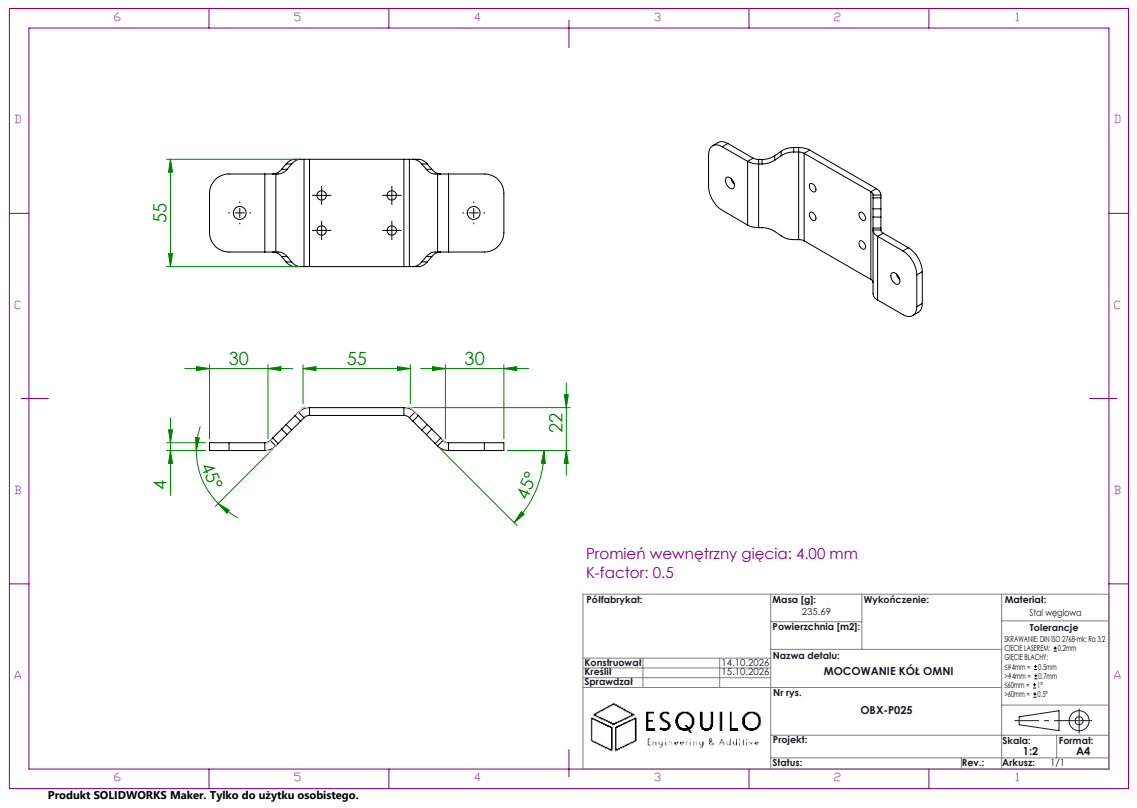
[picture p127: page 1]
Nazwa detalu: Konstruował

Promień wewnętrzny gięcia: 4.00 mm
K-factor: 0.5

Półfabrykat: | Masa [g]: 235.69 | Wykończenie: | Materiał: Stal węglowa

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

Kreślił | | 15.10.2026
Sprawdzał

MOCOWANIE KÓŁ OMNI

Nr rys. OBX-P025

Projekt: | Skala: 1:2 | Format: A4
Status: | Rev.: | Arkusz: 1/1

Produkt SOLIDWORKS Maker. Tylko do użytku osobistego.
