obotx/diy-robot-kit/hardware/drawings/parts/OBX-P028_REV.pdf

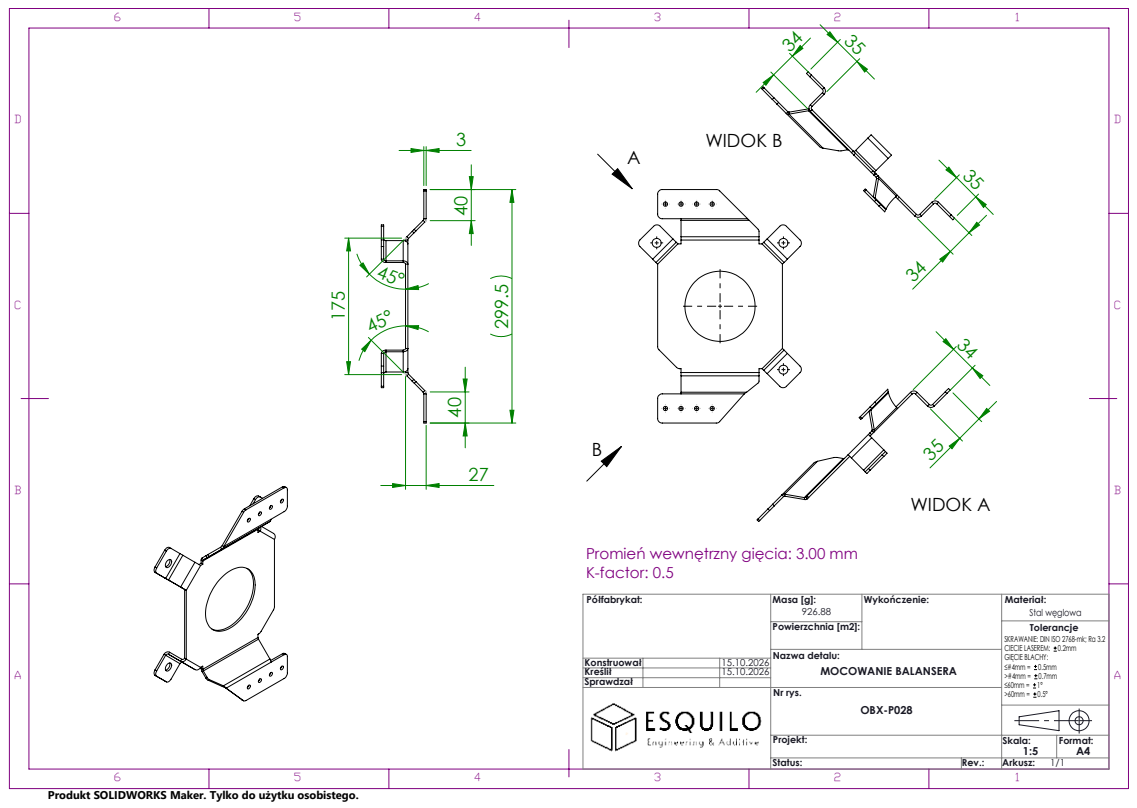
[picture p128: page 1]
WIDOK A; WIDOK B; MOCOWANIE BALANSERA; Nazwa detalu: Konstruował

Promień wewnętrzny gięcia: 3.00 mm
K-factor: 0.5

Półfabrykat: | Masa [g]: 926.88 | Wykończenie: | Materiał: Stal węglowa

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

Kreślił | | 15.10.2026
Sprawdzał

Nr rys. OBX-P028

Projekt: | Skala: 1:5 | Format: A4
Status: | Rev.: | Arkusz: 1/1

Produkt SOLIDWORKS Maker. Tylko do użytku osobistego.
