obotx/diy-robot-kit/hardware/drawings/parts/OBX-P030_REV.pdf

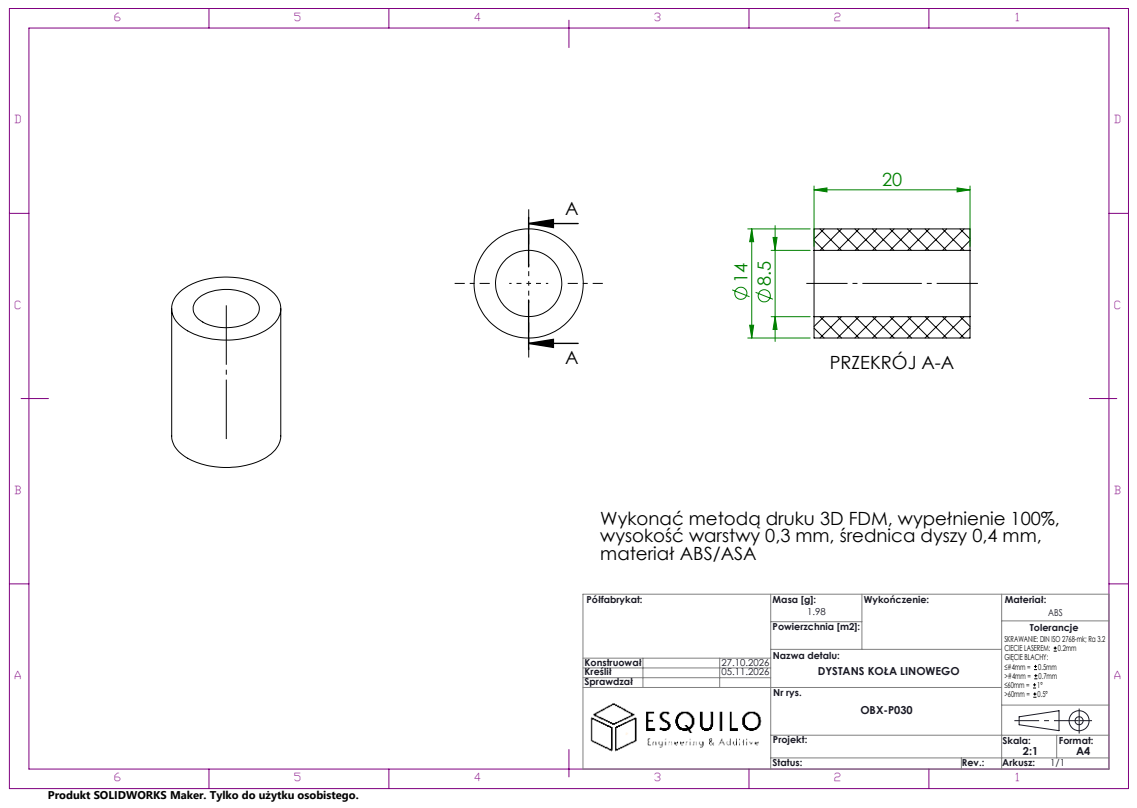
[picture p129: page 1]
PRZEKRÓJ A-A; Nazwa detalu: Konstruował

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

Półfabrykat: | Masa [g]: 1.98 | Wykończenie: | Materiał: ABS

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

Kreślił | | 05.11.2026
Sprawdzał

DYSTANS KOŁA LINOWEGO

Nr rys. OBX-P030

Projekt: | Skala: 2:1 | Format: A4
Status: | Rev.: | Arkusz: 1/1

Produkt SOLIDWORKS Maker. Tylko do użytku osobistego.
