obotx/diy-robot-kit/hardware/drawings/parts/OBX-P031_REV.pdf

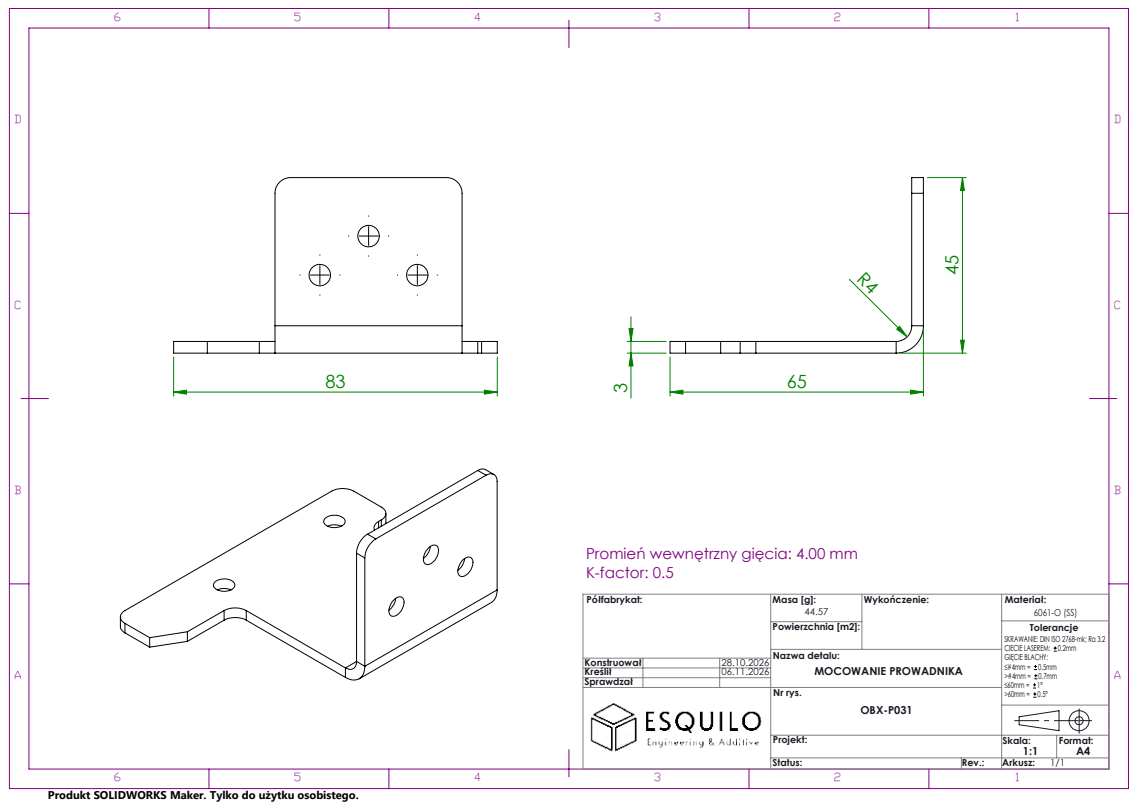
[picture p130: page 1]
MOCOWANIE PROWADNIKA; Nazwa detalu: Konstruował

Promień wewnętrzny gięcia: 4.00 mm
K-factor: 0.5

Półfabrykat: | Masa [g]: 44.57 | Wykończenie: | Materiał: 6061-O (SS)

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

Kreślił | | 06.11.2026
Sprawdzał

Nr rys. OBX-P031

Projekt: | Skala: 1:1 | Format: A4
Status: | Rev.: | Arkusz: 1/1

Produkt SOLIDWORKS Maker. Tylko do użytku osobistego.
