obotx/diy-robot-kit/hardware/drawings/parts/OBX-P032_REV.pdf

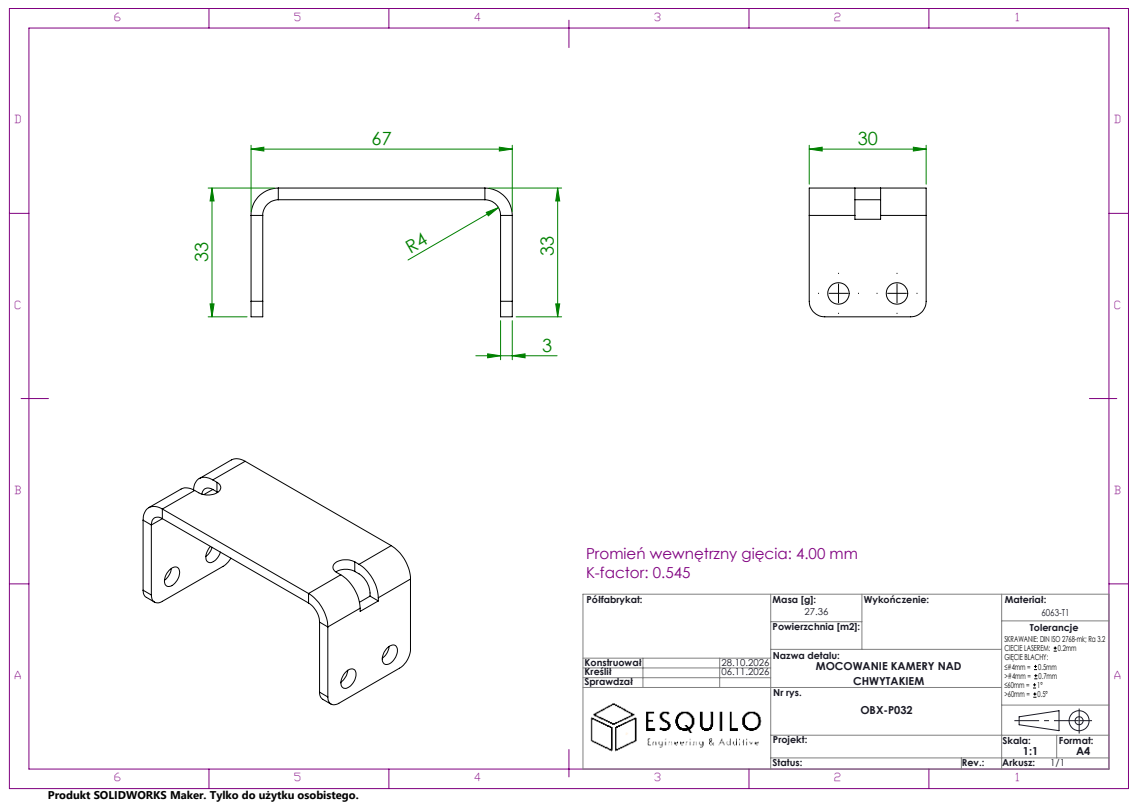
[picture p131: page 1]
Nazwa detalu: Konstruował

Promień wewnętrzny gięcia: 4.00 mm
K-factor: 0.545

Półfabrykat: | Masa [g]: 27.36 | Wykończenie: | Materiał: 6063-T1

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

Kreślił | | 06.11.2026
Sprawdzał

MOCOWANIE KAMERY NAD
CHWYTAKIEM

Nr rys. OBX-P032

Projekt: | Skala: 1:1 | Format: A4
Status: | Rev.: | Arkusz: 1/1

Produkt SOLIDWORKS Maker. Tylko do użytku osobistego.
