obotx/diy-robot-kit/hardware/drawings/parts/OBX-P034_REV.pdf

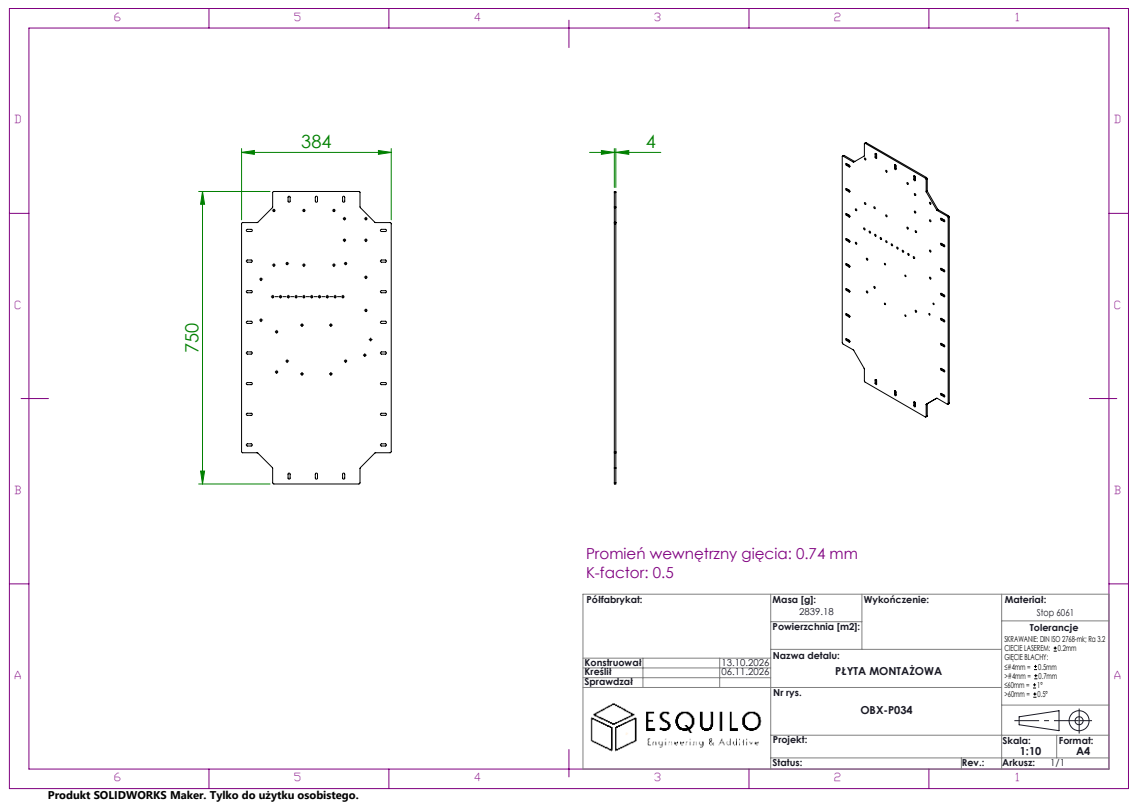
[picture p132: page 1]
PŁYTA MONTAŻOWA; Nazwa detalu: Konstruował

Promień wewnętrzny gięcia: 0.74 mm
K-factor: 0.5

Półfabrykat: | Masa [g]: 2839.18 | Wykończenie: | Materiał: Stop 6061

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

Kreślił | | 06.11.2026
Sprawdzał

Nr rys. OBX-P034

Projekt: | Skala: 1:10 | Format: A4
Status: | Rev.: | Arkusz: 1/1

Produkt SOLIDWORKS Maker. Tylko do użytku osobistego.
