obotx/diy-robot-kit/hardware/drawings/parts/OBX-P035_REV.pdf

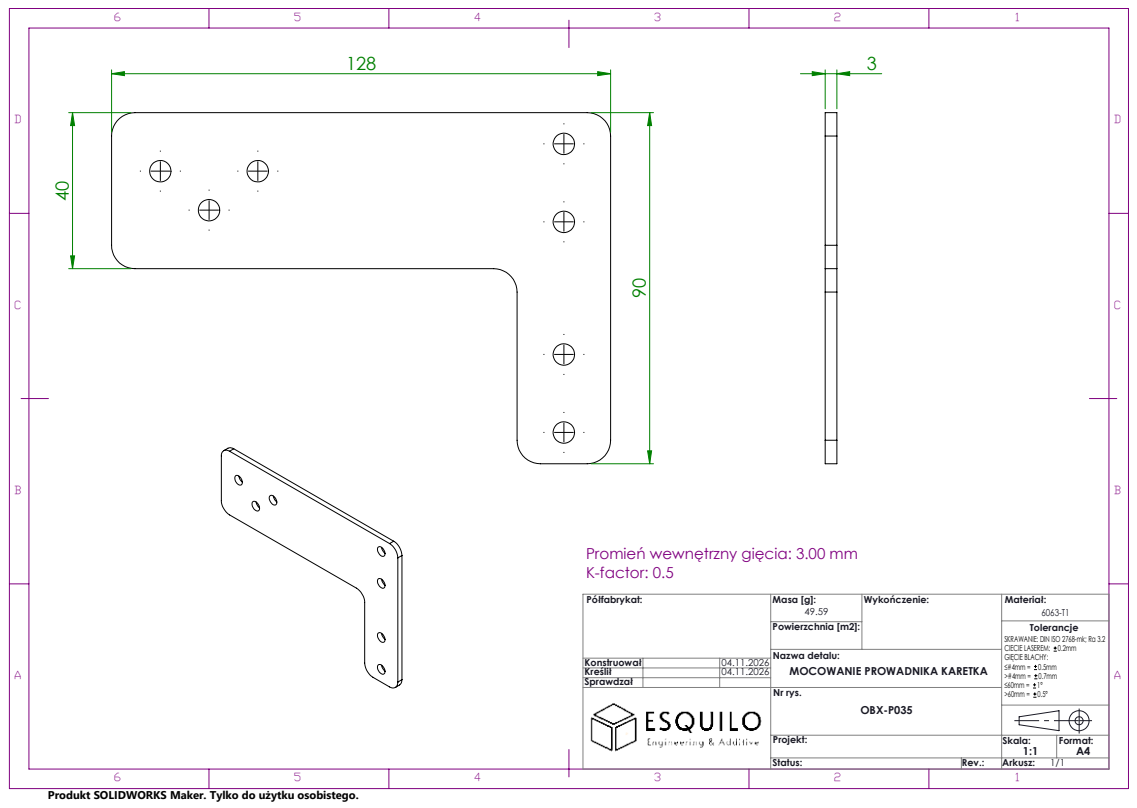
[picture p133: page 1]
Nazwa detalu: Konstruował

Promień wewnętrzny gięcia: 3.00 mm
K-factor: 0.5

Półfabrykat: | Masa [g]: 49.59 | Wykończenie: | Materiał: 6063-T1

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

Kreślił | | 04.11.2026
Sprawdzał

MOCOWANIE PROWADNIKA KARETKA

Nr rys. OBX-P035

Projekt: | Skala: 1:1 | Format: A4
Status: | Rev.: | Arkusz: 1/1

Produkt SOLIDWORKS Maker. Tylko do użytku osobistego.
