obotx/diy-robot-kit/software/stm32_arm/firmware/obotx_arm_f446re/Core/Inc/main.h

#define B1_Pin GPIO_PIN_13
#define B1_GPIO_Port GPIOC
#define ZL_ALARM_Pin GPIO_PIN_0
#define ZL_ALARM_GPIO_Port GPIOC
#define ZR_DIR_Pin GPIO_PIN_1
#define ZR_DIR_GPIO_Port GPIOC
#define ZR_ENABLE_Pin GPIO_PIN_2
#define ZR_ENABLE_GPIO_Port GPIOC
#define ZR_ALARM_Pin GPIO_PIN_3
#define ZR_ALARM_GPIO_Port GPIOC
#define USART_TX_Pin GPIO_PIN_2
#define USART_TX_GPIO_Port GPIOA
#define USART_RX_Pin GPIO_PIN_3
#define USART_RX_GPIO_Port GPIOA
#define LD2_Pin GPIO_PIN_5
#define LD2_GPIO_Port GPIOA
#define X_DIR_Pin GPIO_PIN_7
#define X_DIR_GPIO_Port GPIOA
#define X_ALARM_Pin GPIO_PIN_4
#define X_ALARM_GPIO_Port GPIOC
#define ZL_MIN_Pin GPIO_PIN_5
#define ZL_MIN_GPIO_Port GPIOC
#define ZL_DIR_Pin GPIO_PIN_0
#define ZL_DIR_GPIO_Port GPIOB
#define ZL_ENABLE_Pin GPIO_PIN_1
#define ZL_ENABLE_GPIO_Port GPIOB
#define X_ENABLE_Pin GPIO_PIN_10
#define X_ENABLE_GPIO_Port GPIOB
#define ZL_BRAKE_RELEASE_Pin GPIO_PIN_12
#define ZL_BRAKE_RELEASE_GPIO_Port GPIOB
#define ZR_BRAKE_RELEASE_Pin GPIO_PIN_13
#define ZR_BRAKE_RELEASE_GPIO_Port GPIOB
#define ZL_MAX_Pin GPIO_PIN_6
#define ZL_MAX_GPIO_Port GPIOC
#define ZR_MIN_Pin GPIO_PIN_7
#define ZR_MIN_GPIO_Port GPIOC
#define ZR_MAX_Pin GPIO_PIN_8
#define ZR_MAX_GPIO_Port GPIOC
#define X_MIN_Pin GPIO_PIN_9
#define X_MIN_GPIO_Port GPIOC
#define X_MAX_Pin GPIO_PIN_8
#define X_MAX_GPIO_Port GPIOA
#define TMS_Pin GPIO_PIN_13
#define TMS_GPIO_Port GPIOA
#define TCK_Pin GPIO_PIN_14
#define TCK_GPIO_Port GPIOA
#define SWO_Pin GPIO_PIN_3
#define SWO_GPIO_Port GPIOB
