obotx/diy-robot-kit/(notices)

Notices in the files:
software/stm32_arm/firmware/obotx_arm_f446re/Core/Inc/main.h:
Copyright (c) 2026 STMicroelectronics.
All rights reserved.
This software is licensed under terms that can be found in the LICENSE file
